Rakeshreddysr2401/-langrobo_perception-/README.md

# rover

**Goal:** give it a pose (x, y, θ) — from the VLM brain, a map click, or a
command — and it gets there precisely, knowing at every moment where it is, and
moving safely through tight spaces because it knows its own shape.

Home and office first, a parking assistant later, an arm to pick things up after
that. Built one tested layer at a time; every claim below is measured.

> **Just powered everything on?** Follow **[STARTUP.md](STARTUP.md)**.

## Start the rover — one command

Power on the D555, Jetson, Pi 5, ESP32 (motor supply too) and the laptop, then
from the Pi 5 (`cd ~/ros2_ws && ./scripts/fleet.sh rover`), or on the Jetson:

```bash
cd ~/rover
./rover up                          # orin-nav:2.0 (Isaac ROS 5.0, ROS 2 Lyrical) since 2026-10-25
                                    # recipe + checks: docker/2.0/ (ISAAC_ROS_5_UPGRADE.md)
```

> **Since 2026-10-25 the whole robot is on ROS 2 Lyrical**: the Jetson (`orin-nav:2.0`, Isaac
> ROS 5.0) and the Pi 5 host (`~/ros2_ws/scripts/ros_env.sh`). The older images 1.1/1.2 are
> deleted; their record is in git history.

It brings up and checks each layer in order: camera (D555 depth) → LiDAR → pose
→ fused pose → slam → nvblox map → nav2 → VLM → follow → track → frame memory → ESP32 wheels → Pi 5 teleop +
brain → LangGraph Studio → Pi 5 voice + Bluetooth speaker → RViz on the laptop
→ ESP32 again. About 8 minutes. A layer that fails stops it and names itself.
`--voice` also (re)checks the Pi 5's voice; it starts at boot on its own anyway.

- It **restarts the container** — for a cold power-on, not a stack that is already up.
  One layer failed? Fix it and continue by hand from that layer (STARTUP.md §2), don't re-run `up`.
- At the end it prints the **Studio** link. It needs two steps: on the laptop
  `ssh -N -L 2024:localhost:2024 rakhi24@192.168.1.16`, then open
  <https://smith.langchain.com/studio/?baseUrl=http://127.0.0.1:2024>.
- Talk to it: "**Kino**, what time is it?" — since 2026-10-12 every sentence reaches
  the brain (no wake word yet); the name makes it certain the sentence is for it.
- **Before anything drives:** `./rover wheels --nudge` (moves ~7 cm) — a live ESP32 link
  does not prove the motor supply is on. Teleop must be in AUTO.
- Stop: `./rover stop` (OPERATIONS.md).

## Where it stands (2026-10-25)

| | what | status |
|---|---|---|
| **Shape** | measured dimensions → URDF + CAD, one source | ✅ [description/](description/README.md) |
| **M1 Calibrate** | camera ↔ LiDAR, camera tilt, lever arm, gyro | ✅ camera within 4 mm of two independent methods; gyro scale 1.001 |
| **M2 LiDAR odometry** | the pose from the walls, every scan | ✅ worst 0.9 cm / 0.39° over 17 runs; ~1 cm vs the owner's tape marks |
| **M3 Fusion** | gyro + LiDAR + VO + wheels, each weighted by its own evidence | ✅ **live**, owns `/odom`: worst 0.8 cm / 0.45° over 19 runs (Phase 1 fusion: 20.5 cm / 13°) |
| **M4 Motion control** | exact x, y, θ moves closed on the pose; firmware fixes | ✅ **live**: four-goal loop closes within 1.4 cm / 0.8° vs LiDAR truth (`./rover goto`) |
| **M5 Safe navigation** | nav2 on the fused pose, LiDAR + depth obstacles, 5 cm margin, collision monitor | nav2 drives on fusion2; nav2 route + goal_exec finish 1.3 cm (`navto --exact`); tight gaps by `./rover pass` (3 cm margin): a 55 cm gap passed at 1.1 cm. Close quarters (2026-10-03): no blind Spin, depth into the map only when not turning, 3 cm map slice; ~50 cm gaps pass, **45 cm cannot be promised** and things under 3 cm are not seen (OPEN_ISSUES.md). 2026-10-04: marks people leave in the camera map are erased by the LiDAR (`ghost_clear`), low things stay; on "no path" `reach` drives back along its own trail and stops repeating a failure |
| **Brain (B1–B3)** | the Pi 5's LangGraph brain drives through `reach` / `goal_exec`, finds things from its own photos (`pixel_to_goal` on the held photo), checks on arrival | ✅ floor-tested 2026-09-26 → 10-02 ([INTELLIGENCE_PLAN.md](INTELLIGENCE_PLAN.md)) |
| **Twin** | the laptop's `kino_sim` simulates the robot's HARDWARE in Isaac Sim and THIS code runs on it unchanged, `TWIN=1 ./rover up`, on ROS domain 42, judged on the true pose -- with the Pi 5 brain too (`fleet.sh twin` on the Pi 5; real-looking `home_real` world) | ✅ Isaac day 2026-10-18: every gate OK; `reach 1.0 -0.6 90` believed vs true 0.4 cm; home_real 4/4 reached through the 80 cm door, over the 1 cm tablet as the robot does ([SYSTEM_OVERVIEW.md](SYSTEM_OVERVIEW.md)) |
| **Isaac ROS 5** | `orin-nav:2.0` (Isaac ROS 5.0, ROS 2 Lyrical) from `docker/2.0/Dockerfile`; 2.1 adds the Part B packages | ✅ 2026-10-25: twin home_real 4/4 in 159 s (4.6: 271 s), 0 touches in the regression suite; **real robot driven**: reach goals 0.6-3.2 cm, nav2 drives the wheels. Three silent nav2 1.5 breaks found and fixed (Twist!). Checks: `docker/2.0/*.sh` ([ISAAC_ROS_5_UPGRADE.md](ISAAC_ROS_5_UPGRADE.md)) |
| **Explore** | the rover maps the home by itself: frontiers of the LiDAR map, every goal through `reach` | twin home_real: whole house in 8.9 min, "no frontier left" (`./rover explore`); **not yet run on the real robot** |
| **Frame memory** | the last 10 min of what it saw, searchable by words: a keyframe per 40 cm / 20° / 30 s still, embedded by EmbeddingGemma 2 on the host GPU; a hit is placed with that frame's own depth (`./rover memory`) | ✅ Jetson half 2026-10-29, robot standing still: search 33-84 ms, "a black backpack" strong and placed from a 103 s old frame (0.53 m ahead), absent things weak; `/odom` 19-20 Hz with it; with the Mac's VLM boxing the hit, the whole find takes ~5-7 s. **Not yet used by the brain, not yet measured while driving** ([FRAME_MEMORY.md](FRAME_MEMORY.md)) |

Numbers and how each was measured: [LOCALIZATION.md](LOCALIZATION.md).
What is still missing, measured: [LOCALIZATION_GAPS.md](LOCALIZATION_GAPS.md).
The roadmap: [SENSOR_FUSION_PLAN.md](SENSOR_FUSION_PLAN.md) §8.
Making the brain use all this (object memory, exact moves, fast detection, learning): [INTELLIGENCE_PLAN.md](INTELLIGENCE_PLAN.md).
**What is open right now, one page:** [OPEN_ISSUES.md](OPEN_ISSUES.md).
**All machines, all repos, how they connect, and how clean each is:** [SYSTEM_OVERVIEW.md](SYSTEM_OVERVIEW.md).

## The repo

| where | what |
|---|---|
| `rover` | the launcher: one layer at a time, each gated on the one below |
| `description/` | **the rover's shape**: `params.yaml` (every measurement, with status and date) → `rover.urdf`, `cad/rover.step`; `description/build` also checks every other copy of those numbers |
| `phase1/nodes/` | the pose: `vo_isaac` (Isaac cuVSLAM; `vo_node` = the old pyCuVSLAM path, self-test only), `gyro_node`, `lidar_odom` (+ node), `fusion2` (+ node), `health`, the calibration tools (`floor_calib`, `cam_lidar_calib`) |
| `phase1/harness/` | **the test harness**: `./rover record <scenario>` drives or records a run, `./rover grade` scores every estimate against LiDAR truth |
| `phase1/firmware/` | ESP32: motors, encoders, telemetry |
| `lidar/` | the RPLidar C1 driver build and its calibration (yaw by driving, timestamp lag) |
| `phase2/` | mapping: nvblox (depth → obstacles 5-27 cm), slam_toolbox, RViz |
| `phase3/` | nav2 (costmaps: nvblox + LiDAR), `./rover drive` exact moves |
| `phase4/` | the VLM bridge: `image_bridge` (photos for the brain), `pixel_to_goal` (pixel → goal; also keeps keyframes' depth), `detections_3d` (opt-in YOLO), `keyframe_memory` + `tools/embedder.sh` (frame memory, [FRAME_MEMORY.md](FRAME_MEMORY.md)) |
| `docker/2.0/` | **the image**: Dockerfile (+ `Dockerfile.features` for 2.1) and its checks: `check.sh`, `vo_check.sh`, `nvblox_check.sh`, `nav2_check.sh`, `topic_audit.sh`, `param_audit.sh`, `tf_lag.sh`, `b2_gridloc.sh`, `b3_cuvgl.sh` |
| `ops/` | `rover_watchdog.py`, `mps.sh` (CUDA MPS, B1) |
| `docs/archive/` | history: the phase logs, the old TODO and READINESS, the knowledge notes |

The Pi 5 brain (LangGraph, voice, teleop) is a separate repo: `~/ros2_ws` on the Pi.

## Everyday commands

```bash
./rover up                         # everything, cold (see STARTUP.md for the layers)
./rover health                     # every layer's rate in one ~15 s pass
./rover status                     # the same rates + processes, and whether the pose is honest

./rover record return              # move it by hand, put it back on the tape: all ~0
./rover grade                      # the newest run vs LiDAR truth

./rover camera --floor             # camera tilt and height off the floor (moves nothing)
./rover camera --lidar [--solve]   # camera vs LiDAR, pose by pose (moves nothing)
./rover lidar --calibrate          # LiDAR mount yaw, by driving
description/build                  # after any measurement change: URDF, CAD, drift check

./rover goto X Y [DEG]             # an exact move, relative (DRIVES); --map / --odom for frames
./rover navto X Y DEG [--exact]    # nav2 plans the route; --exact: goal_exec finishes to ~1 cm (DRIVES)
./rover pass [D] [--dry]           # find the tight gap ahead, crawl straight through, 3 cm margin (DRIVES)
./rover explore [minutes]          # map the home by itself, frontier by frontier, via reach (DRIVES; a person watches)

./rover memory                     # frame memory: last 10 min searchable by words (FRAME_MEMORY.md; part of up)
phase4/tools/embedder.sh status    # its model server on the host GPU (start | stop | status)

docker/2.0/topic_audit.sh          # topics whose publishers and subscribers disagree on the type (stack up)
docker/2.0/param_audit.sh          # nav2.yaml keys the running nav2 silently ignores (stack up)
ops/mps.sh start; MPS=1 ./rover up # GPU shared through CUDA MPS (off by default: no gain measured yet)
```

[OPERATIONS.md](OPERATIONS.md) has the rest and the troubleshooting;
[ARCHITECTURE.md](ARCHITECTURE.md) the topics, frames and nodes.
