Rakeshreddysr2401/-langrobo_perception-/description/README.md

# description/ — the rover's geometry: CAD and URDF from one file

```
params.yaml   every measurement, raw, with status + source + date   ← edit this
build         regenerate everything below and check the repo for drift
build.py      the derivation (params -> frames), URDF writer, CAD, drift check
rover.urdf    GENERATED: frames + boxes/cylinders, no <inertial> yet
cad/          GENERATED: rover.step (open in FreeCAD / Onshape) + one .stl per part
```

## Workflow — "as we go"

1. Measure something (see ROVER_BUILD_PLAN.md §1).
2. Put it in `params.yaml` the way it was measured (from the nose, from the
   floor...). Unknown stays `value: null`. **No guesses, no placeholder masses.**
3. `description/build`: rewrites `rover.urdf` and `cad/`, prints the derived frames,
   and checks the hand copies of these numbers that remain (nav2 footprint,
   `vo_node`'s fallback, firmware, odometry constants, pivot safety corners). Exit 1 = a copy
   disagrees; the output says what it should be.
4. Fix the copies it names, rerun until `drift: N/N`, commit.

A new part (battery, Jetson, Pi 5, motors, drivers...) goes under `components:`
as a box with `size` and `centre` in base_link. It shows up in the URDF and the
CAD on the next build. `mass` stays null until it is weighed.

The CAD needs build123d; `build` makes `~/.venvs/cad` on its first run.

## Frames

base_link: **on the floor, midway between the four wheel contact patches** —
x forward, y left, z up. The nose is at +0.182 (axles 6.3 / 30.1 cm behind it).

| frame | x | y | z | note |
|---|---|---|---|---|
| wheels | ±0.119 | ±0.170 | 0.041 | fixed joints until /joint_states exists |
| camera0_link | 0.173 | −0.0475 | 0.175 | the D555's LEFT IR imager, at the front glass; the driver publishes everything below it |
| laser | 0.1342 | 0 | 0.2498 | yaw 1.5463 rad, calibrated by driving |

Two things that look like mistakes and are not:

- **camera y is −4.75 cm** although the camera is centred: `camera0_link` is the
  left imager, half the 95 mm baseline from the case centre. The driver's own
  TF puts infra2 at +0.095 from it, which fixes the sign.
- **The odometry wheel diameter (85 mm) differs from the tyre (83 mm).** It stays
  until a taped 1 m drive says which one gives true distances.
  Likewise `effective_track` (0.5216) is a turning calibration, not the 0.34 track.

## Live

`./rover pose` and `./rover lidar` both call `tf_up`, which runs
`build.py --rsp` and starts ONE `robot_state_publisher` with the URDF derived
from `params.yaml` at that moment. So a new measurement reaches the live TF on
the next layer start, with no copy to update. `LIDAR_YAW=<rad> ./rover lidar`
still overrides the yaw for one run.

RViz (`phase2/rviz/rover_live.rviz`) draws the URDF from `/robot_description`.

`vo_node` reads its camera offset from TF (`base_link -> camera0_link`) at
start; its constants are only the fallback, and it logs an ERROR if it uses them.

Still copied by hand, and held to params.yaml by the drift check: nav2's
footprint, `vo_node`'s fallback, the firmware and the Phase 1 odometry constants
(`WHEEL_BASE_M`, `WHEEL_BASE_ROT_M`, `METRES_PER_COUNT`), and the pivot
scripts' corners.

## Placeholders

`mass.total` is **assumed 3.5 kg (3–4)**, on the owner's word until it is weighed.
Every build prints it. Nothing uses it for geometry and the URDF has no
`<inertial>` yet.
