Rakeshreddysr2401/-langrobo_perception-/STARTUP.md

# Power-on → working development environment

**The one document to follow after everything has been switched off.**

You powered down the D555, the Jetson, the Pi 5 and the ESP32. You have powered
them back on. This is what to run, in what order, what "good" looks like at each
step, and what to do physically when a step fails.

For *why* any of it is shaped this way see [ARCHITECTURE.md](ARCHITECTURE.md).
For the full runbook including calibration and troubleshooting see
[OPERATIONS.md](OPERATIONS.md).

---

## 0. The five boxes

| box | address | how you know it is alive |
|---|---|---|
| Jetson Orin Nano | 192.168.1.15 | you are on it; `docker ps` shows `rover` |
| D555 depth camera | 192.168.11.55 | **only** a live publisher on `infra1`. Ping proves nothing |
| ESP32 wheel link | via micro-ROS | `/wheel_state` at ~20 Hz |
| Pi 5 (teleop + brain) | 192.168.1.16 | `:8091/mode` answers, `agent_node` running |
| Mac mini (LLM/VLM) | **DHCP — moves** (was .6, came back as .10 on 2026-09-23) | from the Pi 5: `curl http://singireddys-mac-mini.local:8080/health`. The brain calls it by name, so a moved IP does not affect it — only a check by IP looks like a dead server |
| RPLidar C1 | USB on the Jetson, `/dev/ttyUSB0` (CP210x) | `/scan` at ~10 Hz and `base_link -> laser` resolving — `./rover lidar` checks both |
| Laptop (RViz) | **DHCP — moves** | `./rover view` finds it |

**Single command:** `./rover up` runs every step below in order — camera,
lidar, pose (with `SLAM=false`), fused, slam, map, nav, vlm, follow, track and memory (these three
not fatal), the ESP32 check,
the Pi 5 check, Studio, and the laptop view — and prints the Studio tunnel link
and the LangSmith project at the end. Add `--voice` to also check the Pi 5's
voice. It restarts the container, so it's for a cold power-on — don't run
it against a stack that's already up and healthy, it throws the running state
away for nothing. The layer-by-layer steps below are what it runs, and what to
fall back to when one of them fails and you need to see which.

**From the Pi 5 instead:** `~/ros2_ws/scripts/fleet.sh rover` runs this same
`./rover up` — but only when the stack is not already up (it asks over ROS), so
it is safe to run any time. `fleet.sh check` then proves every link with data.

**Voice:** it lives on the Pi 5 as the `langrobo-voice` systemd user unit
(starts at boot). `./rover voice` starts it if it is not running — never a
second copy — and prints the providers, the wake setting, and which speaker +
mic the Pi 5's audio owner picked. Since 2026-10-10 the **mic is the USB AM-C28
array** and the **boAt Stone is the speaker** (Bluetooth A2DP). Speech-to-text is
Sarvam (Telugu or English → English); if Sarvam fails, Parakeet transcribes English
on the Pi 5. Say "Kino" in the sentence to be sure it becomes a turn; other
sentences are judged by the brain. Details: the Pi 5 repo
`docs/voice/VOICE_LAB_2026-10.md`.

**If it seems deaf:** the mic is plugged into the Pi 5, not here — check
`/voice/debug_vad` and `/voice/debug_transcript`. (The old trap — the Stone's
Bluetooth mic too quiet for a 0.05 loudness gate — is gone: that gate is off and
the Stone no longer listens.) To check a suspicion:

```bash
docker exec rover bash -lc 'unset ROS_DISCOVERY_SERVER FASTRTPS_DEFAULT_PROFILES_FILE; \
  export ROS_DOMAIN_ID=0; source /opt/ros/lyrical/setup.bash; \
  ros2 topic echo /voice/debug_vad --field data'
```

**The Jetson can come back under another name.** After a power cycle its
avahi (mDNS) may find `rakhi-jetson.local` still claimed on the network and
rename itself `rakhi-jetson-2.local`, `-3`, … (seen 2026-09-28). The Jetson is
fine, but everything that calls it by name — `fleet.sh`, the Pi 5's ssh — sees
`jetson: unreachable`. Find it by address (192.168.1.15) and give it its name
back:

```bash
ssh rakhi24@192.168.1.15 'sudo systemctl restart avahi-daemon'
getent hosts rakhi-jetson.local          # from the Pi 5: 192.168.1.15 again
```

Two more traps worth knowing before you start:

- **The D555 answers ping while completely dead.** It is a PoE network device
  speaking DDS, not a USB camera. Never diagnose it with `lsusb` or `ping`.
- **`./rover status` on a cold container prints a table of dashes** — nothing is
  publishing yet. It measures every topic in one ~12 s pass (since 2026-10-18;
  it used to take 2+ min). Start a layer first; the layer gates name what failed.

---

## 1. Jetson — start the container

```bash
cd ~/rover
docker ps -a --format '{{.Names}}\t{{.Status}}'   # is `rover` there, and stopped?
docker start rover
```

After a power cycle the container is stopped, not gone. `docker start` is
enough; `./rover camera` will create one if it is genuinely missing.

---

## 2. The stack, one layer at a time

Run these **in order**. Each layer checks the one beneath it, so a failure names
its own layer instead of hiding in a wall of log. **Do not skip ahead when one
fails.**

```bash
./rover camera      # the D555 alone       — IR >=15 Hz, depth >=10 Hz
./rover lidar       # the RPLidar C1       — /scan >=8 Hz AND base_link -> laser exists
SLAM=false ./rover pose   # + cuVSLAM, gyro — VO >=10 Hz, gyro >=50 Hz
./rover fused       # + fusion -> /odom    — /odom >=15 Hz, AND the honesty check
./rover slam        # + slam_toolbox       — /map >=0.3 Hz, map -> odom
./rover map         # + nvblox, ghost_clear — occupancy grid >=1 Hz, cleaned grid >=1 Hz
./rover nav         # + nav2               — both costmaps
./rover vlm         # + VLM pixel -> goal  — colour >=2 Hz, 1 listener
./rover detect      # + YOLO -> odom objects — publishing, target hunt listening
./rover follow      # + "follow me" (starts detect too) — follow listening, people publisher
./rover track       # + the locked-target tracker  — track listening
./rover memory      # + frame memory (model on the host GPU) — embedder reachable, >=1 keyframe, /odom still >=15 Hz
./rover view        # RViz on the laptop
```

**One layer failed in `./rover up`? Continue by hand — do not re-run `up`.**
`up` restarts the container, which restarts the camera you may just have got
working. Fix the failed layer, run it alone, then the rest in the order above
(with `SLAM=false` on pose), then `./rover view` for RViz. From the Pi 5,
`fleet.sh check` then proves the whole chain.

**The nav layer's compiled plugin.** `./rover nav` loads the rover's own
costmap plugin (`footprint_clear`, NAV_PLAN.md) from
`phase3/plugins/ws/install`. That is built once, inside the image, by
`phase3/plugins/build.sh` (~20 s), and again only after its source changes;
nav2_supervise.sh warns in `./rover logs nav` if it is missing. After a nav
restart check two things: `./rover logs nav` has `Initialized plugin
"footprint_clear"`, and `./rover logs reach` has `pose OK`.

**`SLAM=false` on pose, and only one owner of `map -> odom`.** cuVSLAM
publishes `map -> odom` whenever its loop closure is on, which is `./rover
pose`'s default. slam_toolbox is the owner now — it corrects against the walls
on every scan — so pose must run with `SLAM=false`, and `./rover slam` refuses
to start if cuVSLAM already owns the frame. `./rover up` does this for you.

**Order matters less than it did, but the LiDAR still needs a live frame.**
Until 2026-09-22, `./rover pose` killed every static transform in the
container, including the LiDAR's, so a LiDAR started before it vanished
silently. That is fixed; `./rover lidar` now fails its gate if
`base_link -> laser` does not resolve.

**If you carry the rover by hand after bring-up**, cuVSLAM can diverge and slam
will apply a large correction trying to make sense of it. Put it down and run
`SLAM=false ./rover pose`, `./rover fused`, `./rover slam` — the pose and the
map restart at the new spot, which becomes the new origin.

**`detect` depends on which brain the Pi 5 is running.** It feeds
`approach_object`, `where_is`, `list_known_objects` and the `world_model`
service — five tools that otherwise answer "I haven't seen one before" about an
object in plain view. It is distinct from `vlm`: `vlm` answers a VLM's
*described* object at ~10-40 s a look, `detect` publishes everything it
recognises continuously at roughly zero query cost.

Those tools exist on `pi5_ros2_ws`'s **`dev-1.2.8-refactor-test`**. They were
deliberately removed on the **`minimal`** line — `dev-1.3.0-minimal` and
`dev-1.3.1-minimal` both — along with `world_model` and the `on_detections`
handler; that cut keeps vision on `look` + the VLM approach path. On a minimal
brain `/vision/detections_3d` has no subscriber, and running `detect` costs GPU
for nobody. See [docs/archive/TODO.md](docs/archive/TODO.md) §32.

**Check the brain before adding `detect` to the order, and check it by what it
subscribes to, not by the branch name.** `dev-1.3.1-minimal` still *mentions*
`/vision/detections_3d` in `ros2_bridge.py` and `tools/approach.py`, but both
are only comments describing the contract — the handler is gone. Verified
2026-09-09: the bridge's three real subscriptions are `/vision/pixel_result`,
`/voice/tts_speaking` and the compressed colour image, and
`langrobo_core/tools/` has no `world_model`. The grep that answers it:

```bash
ssh 192.168.1.16 'grep -n create_subscription \
  ~/ros2_ws/src/langrobo_ros/langrobo_ros/ros2_bridge.py'
```

If `/vision/detections_3d` is not in that output, skip `detect`. (Since 2026-10-20
it costs ~1 % CPU while nothing subscribes: it sleeps -- no camera, no TF, no YOLO --
and wakes for follow or a target hunt; NAV_PLAN.md "2026-10-20".)

**`follow` is part of `up` since 2026-10-11** ("Kino, follow me" / "come to me";
the Pi 5 brain has the tool on with `LANGROBO_FOLLOW=1`). It starts `detect` (YOLO
+ the person tracker -> `/vision/people`) and `follow_node`. If it fails, `up` warns
and carries on: the robot works without it. YOLO idles until someone asks for people,
so it costs nothing at rest; while active, measured 2026-10-11: `/odom` 20 Hz, colour
4.5 Hz, the cleaned grid 5 Hz, `/scan` 10 Hz (unchanged), GPU ~10 %. `follow_node`
drives only after `/follow/start`. `FOLLOW_DRY=1 ./rover follow` = commands on
`/follow/cmd_vel_dry`, wheels untouched. Nobody in view at the start: it turns
in place to find someone (2026-10-13; not with something within ~0.29 m of its
centre). Lost mid-follow: it turns after them, drives to where they were last
seen and looks all around (40 s cap), re-acquiring by clothes colours
(`phase4/nodes/person_look.py`). The camera sits low: a person must be
standing to be seen. Someone seated at the frame edge (legs and arms only) gives no
YOLO person even at conf 0.1.

**`memory` is part of `up` since 2026-10-29** ([FRAME_MEMORY.md](FRAME_MEMORY.md)): the last
10 minutes of what the robot saw, searchable by words. Two parts: EmbeddingGemma 2 in
llama.cpp on the **host** GPU (`phase4/tools/embedder.sh`, port 8097; the image is not
touched) and `keyframe_memory.py` in the container. Good looks like: `embedder
reachable True`, `keyframes kept >= 1`, `embed per keyframe` ~1.6-1.9 s, `reference
level: 38 photos` (the first start builds it in ~70 s and caches it in
`logs/embed_reference.npz`), and `/odom` still >= 15 Hz (measured 19-20 Hz). If it
fails, `up` warns and carries on. The model server refuses to start with too little
free RAM and stops itself (never anything else) if available RAM drops under 600 MB,
or when the container is gone; keyframes then pause and the status says
`"embedder": false`. Model files: `models/embed/` (gitignored; recovery commands in
`embedder.sh`'s header).

**Do not stop at `nav`.** `vlm` is what lets the Pi 5 brain *see* — without it
`look()` and `approach_described_object()` are silently dead, the brain answers
questions but is blind, and `./rover status` shows the `vlm` row as `--`.

`vlm` costs you depth rate: ~24 Hz → ~14 Hz once `image_bridge` attaches, worst
case a 633 ms gap (measured 2026-09-09). Still over the 10 Hz gate. This is
consumer load, **not** `align_depth` — an earlier note blaming the driver's
reprojection was wrong.

**But the 10 Hz gate is not the constraint that matters here.** Later the same
day, under all six layers, the same stall was measured at **1.4–1.9 s** — past
cuVSLAM's `max_frame_delta_s` of 1.0 s, which resets tracking. `vo_node` logs
`frame gap` and the fusion node logs `vo DOWN`, both recovering in ~1 s, so no
rate gate ever sees it. See [docs/archive/TODO.md](docs/archive/TODO.md) §31.

### When a layer fails

| layer | what it means | what to do — physically |
|---|---|---|
| `camera` | the D555's on-camera DDS server is dead | **unplug its PoE cable ~5 s and replug.** No software restart recovers this |
| `camera`, right after a replug | the D555 is still booting — it takes **~60 s** after power, and `./rover up` waits only 40 s | wait a minute, then `./rover camera` alone (2026-09-28: failed in `up`, passed at 30 Hz a minute later) |
| `slam` | `✗ cuVSLAM is already publishing map -> odom` | pose was started without `SLAM=false`. `SLAM=false ./rover pose`, `./rover fused`, `./rover slam` |
| `nav` | the gate shows both costmaps at **0.0 Hz** and nav.log stops after `Configured MPPI Controller` | nav2's lifecycle manager lost a service reply under load (2026-09-28). Run `./rover nav` again |
| `nav` (reach) | `./rover logs reach` shows `NO POSE` | reach started without ever receiving `/odom` and would drop every goal (it did once, 2026-09-27). `./rover nav` again, then look for `pose OK` |
| `pose` | camera is up but cuVSLAM is not tracking | needs texture. Do not start it facing a bare wall with the emitter off |
| `fused` | prints `✗ DIVERGED` | `./rover pose` **then** `./rover fused`. `fused` alone restarts fusion and NOT cuvslam, so the divergence survives |
| `map` | refuses to start | that is deliberate — the pose is dishonest. Fix the pose first, see above |
| `nav` | costmaps flat | the map has no obstacle data yet. Drive it a little |

---

## 3. The cuVSLAM honesty check — now automatic

cuVSLAM has diverged four times and **the fallback is silent**: the rover drops
to gyro-plus-wheel dead reckoning while `/odom` stays at 20 Hz, `ready: true`,
every rate gate green and nav2 planning and driving. One session ran 21 m that
way before anyone noticed.

**You no longer have to remember to check this.** As of 2026-09-09:

- `./rover fused` runs the check in its gate and prints a `cuvslam` line.
- `./rover map` **refuses** to build on a diverged pose — mapping while diverged
  corrupts the map permanently rather than degrading it.
- `./rover status` prints the pose / cuvslam / wheels rows from fusion2's health.

### It catches two different failures, and says which

Earlier on 2026-09-09 it caught only one. It printed `ok — tracking, not dead
reckoning` with no cuVSLAM node running at all, and `./rover map` built on that
pose without refusing — because the four fields it read (`vo_z`,
`vo_implausible`, `dr_metres`, `landmarks`) are last-known values that **freeze**
rather than disappear when `vo_node` stops. At a standstill a dead tracker read
identically to a healthy one. Fixed the same day (TODO 30); it now also reads
`vo_alive`, and both failures print distinctly:

```
✗ DIVERGED      cuVSLAM is publishing a confidently wrong pose
✗ NOT RUNNING   cuVSLAM is publishing nothing; the numbers above are frozen
```

**Both are fixed the same way** — `./rover pose` **then** `./rover fused` — and
both now make `./rover map` refuse rather than smear the map.

You may also see this, which is *not* a failure and does not block a gate:

```
! vo dropped out in 1 of 4 samples — frame gaps past max_frame_delta_s (1.0 s)
```

That is the load-related stall in [docs/archive/TODO.md](docs/archive/TODO.md) §31 — tracking recovers in
~1 s. Worth watching before a long autonomous run, not worth stopping for.

What you want to see:

```
cuvslam   vo_z +0.007 m   implausible 0   dead-reckoned 0.00 m   landmarks 132
          ok — tracking, not dead reckoning
```

Do **not** check this with `ros2 topic echo /fusion/status --once` — it truncates
the JSON mid-field, so anything grepping it silently reads nothing.

---

## 4. ESP32 — the wheel link

```bash
docker exec rover bash -lc 'unset ROS_DISCOVERY_SERVER FASTRTPS_DEFAULT_PROFILES_FILE; \
  export ROS_DOMAIN_ID=0; source /opt/ros/lyrical/setup.bash; \
  ros2 topic hz /wheel_state; ros2 topic info /cmd_vel'
```

Want **~20 Hz** and `/cmd_vel` **Subscription count: 2** — the ESP32 (it shows
as `_CREATED_BY_BARE_DDS_APP_` in `ros2 topic info -v`, via the micro-ROS agent)
and `fusion2`, which reads the commands. `./rover wheels` checks the ESP32 one by
name, and `./rover up` runs it twice: after `vlm` and again at the very end.

**20 Hz does not mean the motors have power.** On 2026-09-23 every gate passed
— 20 Hz, subs 1, "Wheels are live" — and the wheels could not turn: the
ESP32's logic was powered and the motor supply was not. The rate proves the
board is talking. Before anything drives:

```bash
./rover wheels --nudge      # MOVES ~7 cm: command arrived? did both sides drive?
```

It names which of three things is wrong: the command never arrived, it arrived
and nothing moved (motor power — a switch or the BTS7960 supply), or only one
side moved (that side's driver or wiring).

If it is 0 Hz or subs 0, the ESP32 did not reconnect its micro-ROS session —
**power-cycle the rover** (the board, not the Jetson). Old firmware does not
retry the agent connection. It usually comes back on its own after a power
cycle; it did on 2026-09-09 with no intervention.

### It can also link, rot, and then come back — do not power-cycle on sight

On 2026-09-09 the link came up healthy after the power cycle — `/cmd_vel` subs
**1**, `/wheel_state` publishing — then **decayed and died while the stack was
still being brought up**: 15.9 → 14.8 → 11.3 Hz across three consecutive
`ros2 topic hz` windows, max gap 0.732 s, and minutes later publishers **0**,
subs **0**. Nothing was driven at any point. Roughly ten minutes later it was
back at a steady **20.0 Hz**, subs **1**, with **no power-cycle and no
intervention**.

**So this is not the firmware-retry fault above, and the fix above is the wrong
reflex.** That fault leaves a dead link dead until the board is power-cycled;
this one restored its own micro-ROS session. Power-cycling on sight of it
"fixes" something already recovering and destroys the evidence.

What to do instead: a green wheel check at §4 is a reading, not a guarantee —
**re-check after the last layer is up, and again before anything drives.** The
symptom of missing the window is the worst one available: nav2 plans a route and
publishes `/cmd_vel` into a topic with no subscriber, so the rover never moves
while every gate on the Jetson stays green. That looks like a controller fault
or like teleop in MANUAL, and it is neither.

Cause is not established — one observation. `/cmd_vel` publishers climbed 2 → 6
over the same period as nav2, the brain and `/studio_bridge` attached, so DDS
load is the first thing to test, not the answer. See [docs/archive/TODO.md](docs/archive/TODO.md) §33.

---

## 5. Pi 5 — teleop and the brain

These start themselves at boot. **Check, do not start.**

```bash
ssh 192.168.1.16 'pgrep -af "teleop_we[b]|agent_[n]ode|brain_launc[h]"'
curl -s http://192.168.1.16:8091/mode          # want {"manual": false}
```

| check | want | if not |
|---|---|---|
| `teleop_web.py` running | 1 process | `ssh 192.168.1.16 'pkill -f teleop_web.py'` — `Restart=always` brings it back |
| `agent_node` running | 1–2 processes | it is launched by `brain_launch.py`; see OPERATIONS.md §7 |
| `:8091/mode` | `{"manual": false}` | **AUTO.** In MANUAL it streams zeros at 10 Hz that cancel nav2's commands |

The brackets in that `pgrep` are deliberate: without them the pattern matches
the command line of the shell running it, and every check reports one extra
"process" that is just itself. The same trap kills your ssh session outright
when the command is `pkill` — see §6.

**Teleop must be in AUTO before any autonomous motion.** In MANUAL the rover
crawls, stalls, and it looks exactly like a controller fault.

### The four services, and the one that needs you

All of it is systemd on the Pi 5, which §5 never actually named:

| unit | what it is |
|---|---|
| `langrobo-brain` | the LangGraph `agent_node` |
| `langrobo-teleop` | the `:8091` hold-to-move web page |
| `langrobo-microros` | the **ESP32 <-> Pi 5 bridge**, over the ESP32's USB cable since 2026-10-07 (`/dev/ttyUSB0`; was WiFi UDP 8888) — see §4 and TODO §33 |
| `langrobo-discovery` | Fast DDS Discovery Server, the Pi 5 <-> Jetson meeting point |

After changing anything under `~/ros2_ws/src/langrobo_core`, the brain must be
restarted to see it — `langrobo_core` is imported straight from `src/`, so there
is **no colcon build step** for it, but the running process holds the old code.

```bash
ssh 192.168.1.16 'sudo systemctl restart langrobo-brain'
```

**That needs a password** — `sudo -n` fails, so it cannot be scripted or run by
an agent on your behalf. Type it yourself. Confirm it actually took, because a
piped `sudo` failure is easy to miss:

```bash
ssh 192.168.1.16 'systemctl show -p ExecMainStartTimestamp langrobo-brain'
```

A PID that did not change means the restart did not happen.

---

## 6. LangGraph Studio — the link you asked for

`./rover up` starts it on the Pi 5 every time (its `[studio]` step); it is
not needed for the robot to work — `agent_node` runs the graph in-process —
it is a **dev server** that draws the graph and lets you step it.

The launcher is the Pi 5 repo's `~/ros2_ws/scripts/start_studio.sh` (one
Studio only: a second start sees :2024 answering and exits). It runs beside
the live brain: no micro-ROS agent, plain multicast DDS like everything else.
The Pi 5's `./scripts/dev.sh` is the variant for when the brain is **stopped**
(it also starts a micro-ROS agent). Never run Studio's graph and the brain's
both driving: both publish `/cmd_vel`, and only `agent_node` hears the
nav-done callback.

### Start it on the Pi 5

```bash
ssh 192.168.1.16 'setsid nohup ~/ros2_ws/scripts/start_studio.sh \
    > /tmp/langgraph_dev.log 2>&1 < /dev/null &'
```

It takes 30–60 s. Poll rather than assume:

```bash
ssh 192.168.1.16 'curl -s http://127.0.0.1:2024/ok'      # {"ok":true} when ready
```

### Open it — TWO steps, both required

**Step 1** — on the machine with the browser, leave this running:

```bash
ssh -N -L 2024:localhost:2024 rakhi24@192.168.1.16
```

**Step 2** — open:

```
https://smith.langchain.com/studio/?baseUrl=http://127.0.0.1:2024
```

**The link alone will not work.** Studio's page is served over HTTPS and a
browser blocks it from calling `http://192.168.1.16:2024` as mixed content, with
no visible error. `http://127.0.0.1` is the one address browsers exempt, and the
tunnel is what makes it `127.0.0.1` on your laptop.

Check the tunnel from your laptop: `curl localhost:2024/ok` → `{"ok":true}`.

**A blank page when `/ok` is healthy is the CORS private-network bug**, not a
dead server — and `curl` cannot see it, because curl sends no `Origin`. A local
patch on the Pi 5 fixes it and `pip` silently undoes it; the diagnostic curl and
the one-line fix are in [OPERATIONS.md](OPERATIONS.md) §7, tracked as
[docs/archive/TODO.md](docs/archive/TODO.md) §38. A stale tab looks the same, so hard-reload first.

### When there is no laptop

The tunnel is not a laptop thing — it must simply run **on whichever machine has
the browser**, because `127.0.0.1` is the only address a browser will let an
HTTPS page call over plain HTTP. Pick the box you will actually be looking at:

**On the Jetson** (it has `firefox`, and this is the usual fallback):

```bash
setsid nohup ssh -N -o ExitOnForwardFailure=yes -o ServerAliveInterval=30 \
    -L 2024:localhost:2024 rakhi24@192.168.1.16 \
    > /tmp/studio_tunnel.log 2>&1 < /dev/null &
curl -s http://127.0.0.1:2024/ok        # {"ok":true} — verified 2026-09-09
```

Then open the §6 Step 2 link in a browser **on the Jetson**. `ExitOnForwardFailure`
is what makes a failed forward fail loudly instead of leaving a live ssh session
with a dead tunnel; the keepalive stops the flaky Pi 5 link (TODO §29) from
silently dropping it mid-session.

Note the Jetson's `DISPLAY` is empty over ssh — you need its physical monitor,
or `ssh -X`. If neither is available, **that closes the Studio path** and
LangSmith below is the answer, not a workaround.

**A phone cannot do this.** No ssh tunnel, so no `127.0.0.1`, so Studio will not
load — the teleop page on `:8091` is the only phone-facing thing here.

### If you only want to read what the brain did, skip all of it

LangSmith needs no tunnel, no server and no browser on any particular machine —
[smith.langchain.com](https://smith.langchain.com), project **`pi5`**. Drive a
real turn through Telegram and read the trace. For *reading* flows this is the
lower-effort path and always has been; Studio is only worth the tunnel when you
want to **step the graph yourself**.

### Stop it before you use Telegram — it answers your messages instead

**Studio is not a passive viewer.** Its process runs the same graph and brings
up its own `/studio_bridge` ROS node beside `/agent_node`; both can publish
`/cmd_vel`. It takes no voice or Telegram input (only `agent_node` listens to
those), so it cannot steal a request -- but a drive started from Studio and one
started by voice/Telegram would fight over the wheels.

**Since 2026-10-04 a drive started in Studio reports back to Studio.** Before
that, only `agent_node` registered a nav-done callback, so Studio's bridge logged
`nav done ... listener=NONE` and threw the report away (measured 2026-09-10, and
again 2026-10-04: the robot said it was "1.5 m from the door" after arriving).
Now `graph_studio.py` posts the same report (`movement.nav_report`) as a new turn
on the thread whose tool started the drive -- arrival, failure with its reason,
and any "on arrival" errand. Pi 5 commit `a362e8a`.

So still treat §6 as a mode for DRIVING: **Studio, or the Telegram/voice brain --
not both at once.** `./rover up` starts Studio at the end because the link is
usually what is wanted; if you are about to drive from Telegram, stop it first.
Voice can stay up beside Studio.

### Stopping it

```bash
ssh 192.168.1.16 'pkill -f "langgrap[h] dev"'
```

Confirm `/studio_bridge` is actually gone before trusting a nav report again:

```bash
ros2 node list | grep studio      # want no output
```

**The brackets are not a typo.** `pkill -f "langgraph dev"` matches its own
command line over ssh and kills its own session: exit 255, no output, nothing
killed — indistinguishable from a flaky link.

### LangSmith is a different thing, and needs none of this

[smith.langchain.com](https://smith.langchain.com), project **`pi5`**. Traces of
real turns the rover has already taken through Telegram. No tunnel, no server,
nothing to start — tracing is on (`LANGCHAIN_TRACING_V2=true`).

For *reading* how agents hand off and which tools fire, LangSmith is the lower
effort path. Studio is for driving the graph yourself.

---

## 7. What "all good" looks like

`./rover status` — all eleven rows, plus an honest pose:

```
  camera  /camera/camera0/infra1/image_rect_raw   28.6   want 15   OK
  camera  /camera/camera0/depth/image_rect_raw    15.4   want 10   OK
  pose    /vo/odom                                21.5   want 10   OK
  pose    /gyro/base                             199.2   want 50   OK
  wheels  /wheel_state                            19.9   want 15   OK
  fused   /odom                                   20.0   want 15   OK
  map     /ghost_clear/grid                        4.8   want  1   OK
  nav     /global_costmap/costmap                  0.8   want0.5   OK
  nav     /local_costmap/costmap                   1.7   want  1   OK
  vlm     /camera/color/image_raw/compressed       4.5   want  2   OK
  view    /rover/model                             1.0   want0.5   OK

  cuvslam  vo_z +0.007 m  implausible 0  dead-reckoned 0.00 m  landmarks 132
           ok — tracking, not dead reckoning
```

Plus, off the Jetson:

- `/wheel_state` ~20 Hz, `/cmd_vel` subs 1 — ESP32 linked
- `:8091/mode` → `{"manual": false}` — teleop in AUTO
- `agent_node` running on the Pi 5 — brain up
- `:2024/ok` → `{"ok":true}` — Studio up, if you started it
- `ros2 node list` shows `/agent_node` and `/studio_bridge`

---

## 8. What this does NOT restore

Following this document gets you a **working rig**, not the *identical* state you
left. The difference is deliberate in some places and a known gap in others.

**Comes back exactly:**

- every layer and its rates, the honesty of the pose, the ESP32 link
- the Pi 5 brain and teleop — they start at boot
- Studio's own episodic store (`~/.langrobo/qdrant_studio` persists on disk)
- the Pi 5's `.env`, including `STUDIO_MODEL=default`

**Does NOT come back, by design:**

- **The map.** nvblox builds in the `odom` frame and is discarded on shutdown —
  phase 2c ("a map that survives a power cycle") is deferred by choice. You
  start with an empty grid and it grows as you drive.
- **The odom origin.** It resets to wherever the rover is when `./rover fused`
  starts. Saved locations (`kitchen`, `entrance`, …) are coordinates in that
  frame, so **they only mean anything relative to this session's start pose.**
  If you moved the rover while it was off, they point somewhere else.

**Backed up, but not in this repo:**

- **`~/ros2_ws` on the Pi 5 is its own git repo** —
  `github.com/Rakeshreddysr2401/pi5_ros2_ws`. The branch actually checked out
  moves: it was `dev-1.2.8-refactor-test`, and on 2026-09-09 it was
  `dev-1.3.1-minimal`. Read it, do not assume it —
  `ssh 192.168.1.16 'cd ~/ros2_ws && git rev-parse --abbrev-ref HEAD'`.
  The whole `langrobo_core` / `langrobo_ros` brain tree is version-controlled
  there, so a reflash is a `git clone`, not a loss. (An earlier draft of this
  section claimed it was unbacked-up. It was wrong.)
- **`.env` is the exception, and correctly so** — it is gitignored on the Pi 5
  because it holds the LangSmith / Sarvam / Soniox / OpenAI keys. `example.env`
  is tracked as the template. **This is the one thing with no backup anywhere**:
  if that SD card dies you re-issue keys. Worth a copy somewhere safe.

**Varies between power cycles:**

- **Whether the ESP32 reconnects on its own.** It did on 2026-09-09 with no
  intervention; other sessions have needed a physical power-cycle. §4 tells you
  which you got.
- **The laptop's IP** — DHCP. `./rover view` finds it.
- **Studio is not started at boot** — §6 every time.

---

## 9. Before anything drives

- **A human watches, every time.** The rover cannot see anything flatter than
  5 cm, anything low beside or behind it that the camera never faced (the
  LiDAR sees all round, but only at 25 cm), or **downward**: there is no
  drop-off detection at all.
- **Tapping MANUAL on the phone cancels the active nav2 goal.** That is the stop.
- **Studio can drive.** With ROS sourced, a `navigate` turn typed into the
  browser publishes real `/cmd_vel` — `/studio_bridge` sits alongside
  `/agent_node` and both can command the wheels. To explore the graph *without*
  that, start Studio in a shell where ROS is not sourced: it falls back to
  `StubBridge` and logs tool calls instead of publishing.
- **Teleop must be in AUTO for `./rover drive`, `pivot` and `lidar --calibrate`.**
  In MANUAL it streams zeros over every command. `./rover drive` checks and
  refuses; driving the rover to a new spot with the phone leaves it in MANUAL.
- **`./rover wheels --nudge` first** after any power cycle (§4): a healthy link
  rate says nothing about motor power.
- **Pause YOLO, follow and track while driving** until the overload is fixed (OPEN_ISSUES R8):
  with all of them up on the real robot (2026-10-25) `/odom` fell to 14.7 Hz and the gyro to 104 Hz;
  without them `/odom` held 19.8 Hz. `./rover detect` / `follow` / `track` bring them back.
- **If the D555 does not come up after a power cycle**, look at the Jetson's Ethernet first:
  `cat /sys/class/net/enP8p1s0/carrier` -- `0` is a cable / PoE problem (re-seat the plug at
  both ends, check the injector's light), not the camera's software (2026-10-25).
- **Turns slide.** A plain turn "in place" moves the centre ~30 cm per 90°
  ([LOCALIZATION.md](LOCALIZATION.md)). Give turns room, and use
  `./rover drive` when the position after a turn matters.

## 10. The whole-home map — once, with the owner watching

The brain's "go to the bedroom" needs ONE map of the whole home that survives power cycles
(`maps/last.*`, resumed by `./rover slam`) and the rooms saved in it by name. Do this once:

1. `SLAM_FRESH=1 ./rover up`, then `./rover wheels --nudge`. Pause YOLO/follow/track (§9).
2. Map it: either drive slowly room to room with the phone (teleop), **or** `./rover explore 30`
   and walk behind it (frontier exploration through `reach`; twin home_real: whole house in
   8.9 min). Doors open; nothing on the floor you do not want it to drive at.
3. In each room, stop and tell the brain on Telegram: "save this place as bedroom" (the
   `save_location` tool; places are stored per room id, `/home/room`).
4. `./rover slam --save home` (a named copy), and `./rover stop` (saves `maps/last.*`).
5. Next start, `./rover slam` says where it is in that map ("locked"), and "go to the bedroom"
   works. Optional, for cuVGL (camera "where am I?"): record the same drive with
   `phase2/tools/record_cuvgl.sh home 300` -- it loads the Jetson, so drive slowly.
