Rakeshreddysr2401/-langrobo_perception-/docs/img/2026-10-04_dad_drive_costmap.png

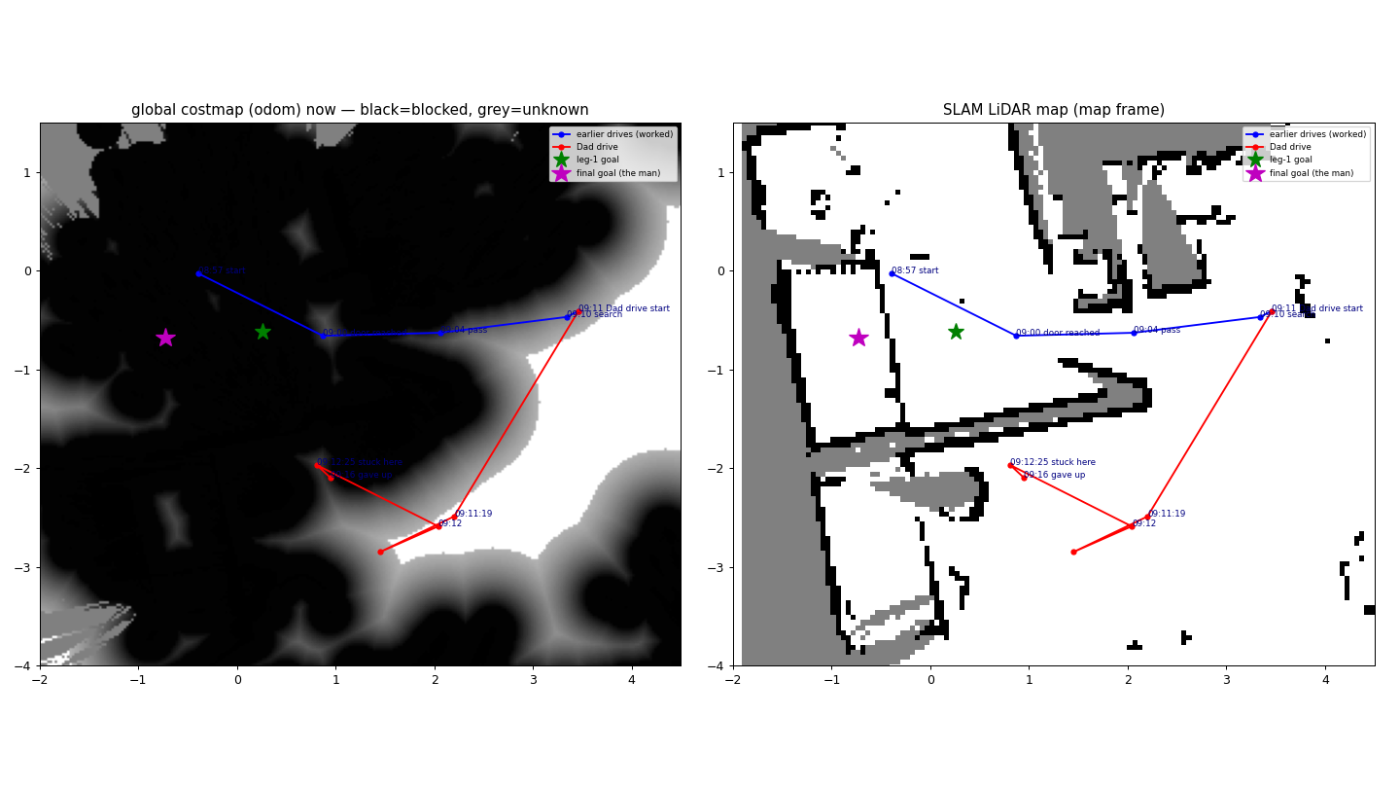
docs/img/2026-10-04_dad_drive_costmap.png
