Rakeshreddysr2401/-langrobo_perception-/description/cad/rover.step

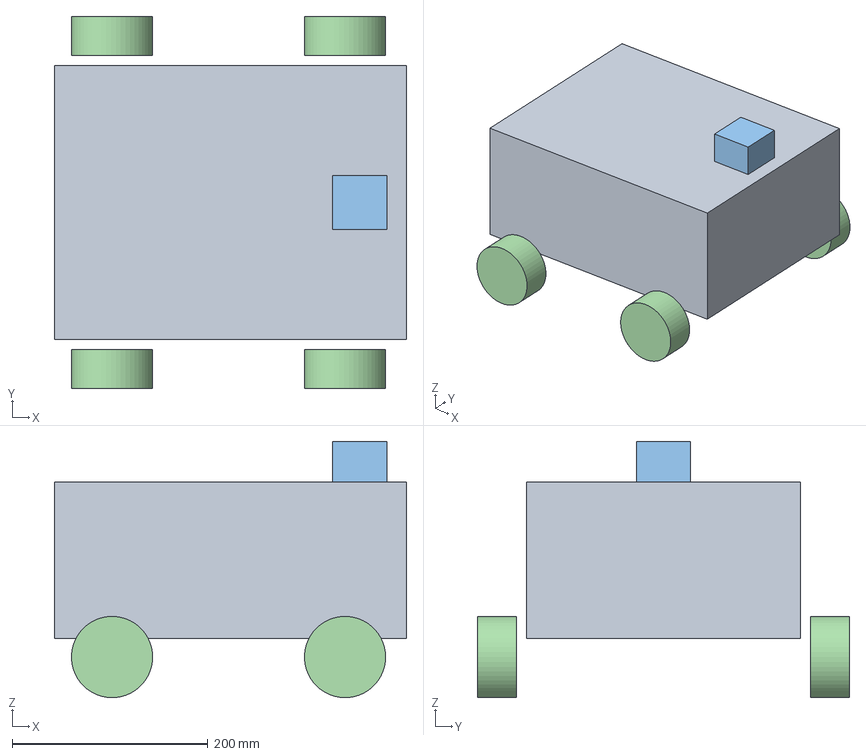
[picture p3: CAD file, 2026-10-19]
description/cad/rover.step
360.0 x 380.0 x 261.8 mm
chassis
camera_d555
lidar_c1
wheel_lf
wheel_lr
wheel_rf
wheel_rr
