Rakeshreddysr2401/-langrobo_perception-/description/cad/wheel_rf.stl

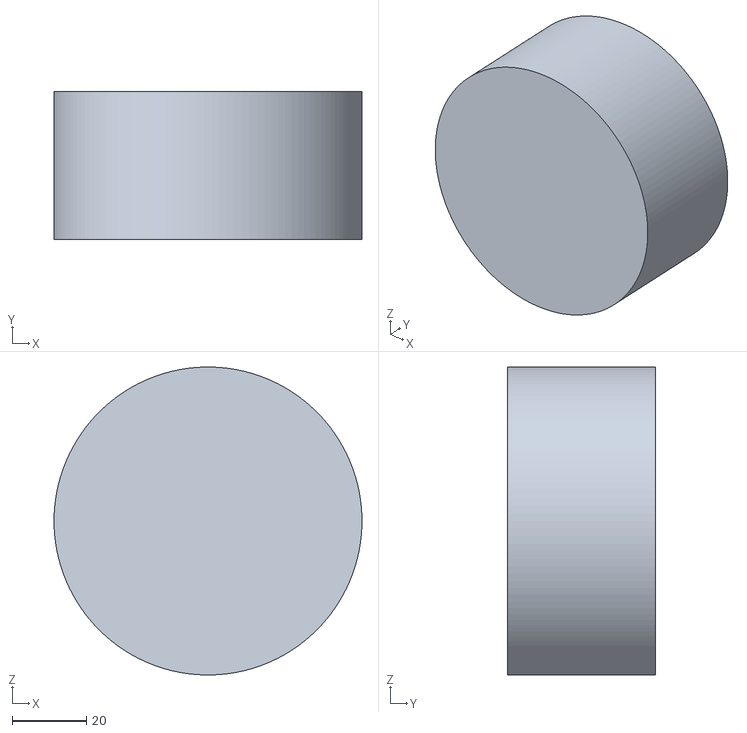
[picture p4: CAD file, 2026-09-23]
description/cad/wheel_rf.stl
83.0 x 40.0 x 83.0
