Rakeshreddysr2401/-langrobo_perception-/description/cad/lidar_c1.stl

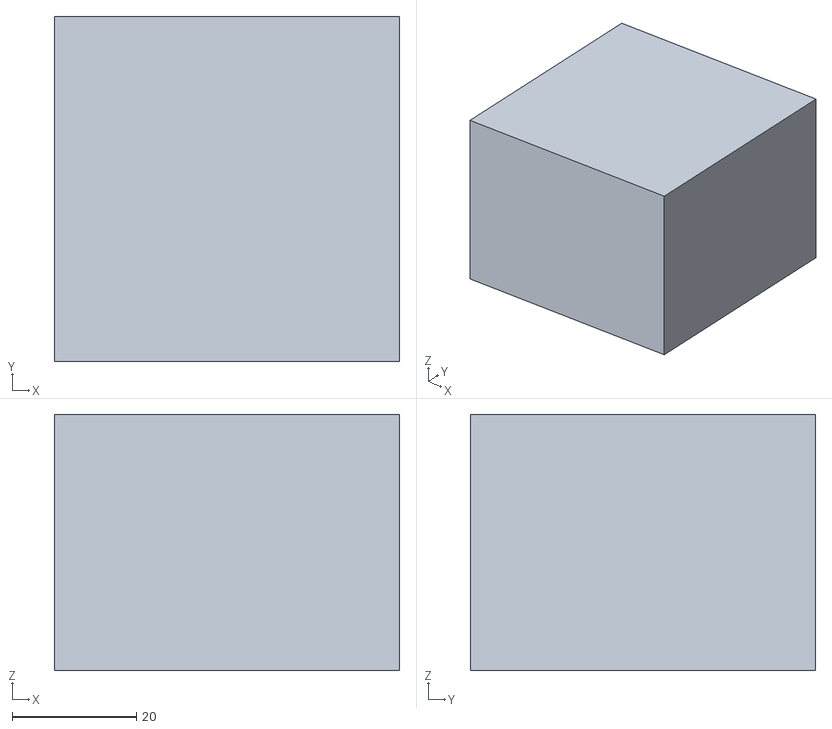
[picture p5: CAD file, 2026-09-23]
description/cad/lidar_c1.stl
55.6 x 55.6 x 41.3
