Rakeshreddysr2401/-langrobo_perception-/description/cad/chassis.stl

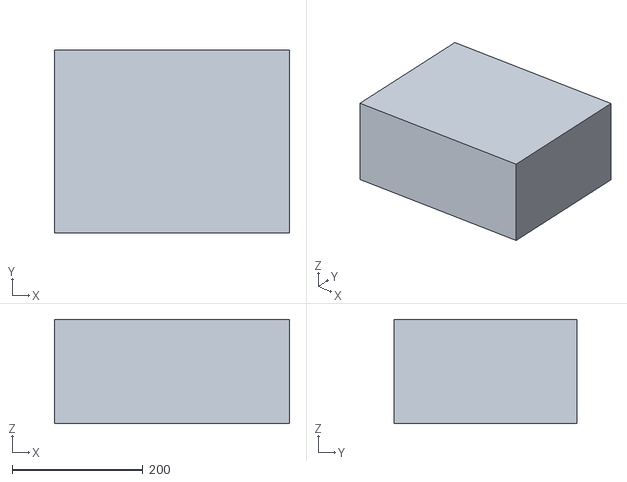
[picture p6: CAD file, 2026-09-23]
description/cad/chassis.stl
360.0 x 280.0 x 160.0
