Rakeshreddysr2401/-langrobo_perception-/description/cad/camera_d555.stl

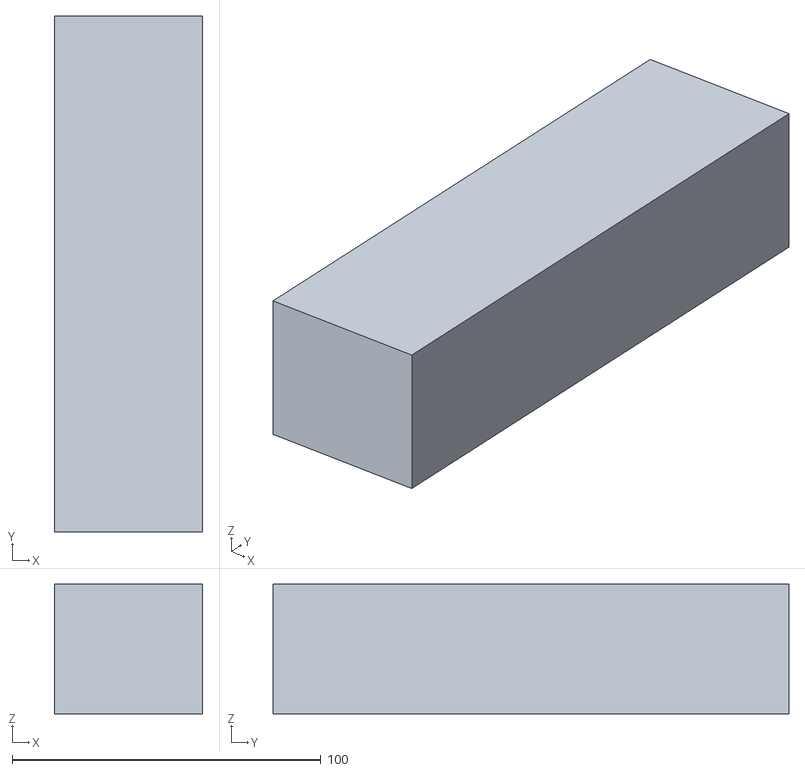
[picture p7: CAD file, 2026-09-23]
description/cad/camera_d555.stl
48.0 x 167.0 x 42.0
