Rakeshreddysr2401/-langrobo_perception-/(list of files, cad)

Other CAD files:
description/cad/wheel_lf.stl
description/cad/wheel_rr.stl
description/cad/wheel_lr.stl
