Rakeshreddysr2401/-langrobo_perception-/OPERATIONS.md

# Operations — the runbook

How to bring the rover up, measure it, calibrate it, and diagnose it when it
misbehaves. For *why* anything is the way it is see
[ARCHITECTURE.md](ARCHITECTURE.md); for the measured numbers see
[docs/archive/PHASE1.md](docs/archive/PHASE1.md).

---

## 1. Bring-up

> Coming back from a power cycle? **[STARTUP.md](STARTUP.md)** is the shorter
> path: it covers all five boxes, not just the Jetson stack, and ends with the
> Studio link. This section is the reference for what each layer proves.

Run these **in order**. Each checks the layer beneath it, so a failure names its
own layer instead of hiding in a wall of log.

```bash
./rover camera      # the D555 alone
./rover lidar       # the RPLidar C1 -> /scan, and base_link -> laser
SLAM=false ./rover pose   # + cuVSLAM and the gyro, loop closure OFF
./rover fused       # + the fused pose -> /odom and TF
./rover slam        # + slam_toolbox: map -> odom, the LiDAR correction
./rover map         # + nvblox: build the room as it drives
./rover nav         # + nav2: plan a route and drive it
./rover vlm         # + the VLM bridge: a picked pixel -> a nav2 goal (phase 4)
./rover follow      # + "follow me": detect (YOLO people) + follow_node (in ./rover up since 2026-10-11)
```

| command | what it proves |
|---|---|
| `./rover camera` | streaming ≥15 Hz **and** the IR emitter verified OFF by read-back |
| `./rover lidar` | `/scan` ≥8 Hz **and** `base_link → laser` resolves (a scan nothing can transform fails the gate) |
| `./rover pose` | cuVSLAM ≥10 Hz, gyro ≥50 Hz, re-framed into `base_link` |
| `./rover fused` | `/odom` ≥15 Hz, TF `odom → base_link` owned by exactly one node |
| `./rover slam` | `/map` ≥0.3 Hz, and **refuses** if cuVSLAM already owns `map → odom` |
| `./rover map` | the occupancy grid publishing, and how much is mapped |
| `./rover nav` | both costmaps carrying obstacle data, all servers activated |
| `./rover vlm` | compressed colour ≥2 Hz, and `pixel_to_goal` subscribed to `/vision/pixel_query` |
| `./rover follow` | `follow_node` subscribed to `/follow/start`, and a `/vision/people` publisher (detect) |

**Restarting `fused` destroys the map.** The pose origin resets, so the old
geometry would land in the wrong place. Restart `map` whenever you restart
`fused`.

Then, at any time:

```bash
./rover status      # every layer's rate, one screen
./rover values      # one-shot readout of every sensor
./rover wheels      # the ESP32 link specifically
./rover wheels --nudge   # MOVES ~7 cm: proves the motors are POWERED, not just linked
./rover slam --check     # odom alone vs LiDAR-corrected, and the correction
./rover logs vo     # tail a layer's log: camera | vo | gyro | fused | lidar | slam
./rover stop        # tear the container down
```

### Exact moves and grading turns — see [LOCALIZATION.md](LOCALIZATION.md)

```bash
./rover drive 0 0 90 --rel     # turn 90 deg left without the centre moving
./rover drive X Y [DEG]        # go to a pose in the map frame
./rover drive --mark NAME      # remember this pose;  --to NAME  goes back
./rover lidar --calibrate      # measure LIDAR_YAW by driving
./rover lidar --lag            # measure the scan timestamp error
```

All of these move the rover except `--mark`, need teleop in AUTO, and check the
LiDAR for clearance first. A plain turn "in place" slides the centre ~30 cm per
90° on this chassis; `./rover drive` plans around it.

### Before you trust anything

**Rates are the honest signal.** Every failure this rig has had was a rate
collapsing, not a topic disappearing. `./rover status` is the first thing to
look at when something is odd.

---

## 2. Driving it

Teleop lives on the Pi 5: **`http://192.168.1.16:8091`** from a phone on the same
WiFi.

**It defaults to AUTO and the buttons do nothing until you flip it to MANUAL.**
That is nav2/the brain owning `/cmd_vel`, not a fault. In MANUAL it publishes at
10 Hz whether or not a button is held, so `/cmd_vel` traffic alone proves
nothing — only a non-zero velocity does.

| button | commanded | speed at the camera | |
|---|---|---|---|
| forward / back | 0.20 m/s | 20 cm/s | ✅ under the tracking limit |
| left / right pivot | 2.0 rad/s | **34 cm/s** | ⚠ over it — expect jumps |

Release is a **coast**, not a brake: the wheels decay to zero over ~0.5 s. Motion
is gated on a `/cmd_vel` newer than 500 ms, so a lost connection stops the rover.

---

## 3. Testing the pose: record, then grade against LiDAR truth

The Phase 1 tape gates (`./rover compare`) are retired. Every pose estimate is
now graded against where the LiDAR says the rover really was
([phase1/harness/README.md](phase1/harness/README.md)):

```bash
./rover record return        # YOU move it anywhere, put it back on the tape marks: all should read ~0
./rover record straight      # also: pivot90, pivot360, square, small, turn, still, manual (these DRIVE)
./rover grade                # the newest run: truth vs fused / lidar / vo / wheels, cm and degrees
./rover grade --summary      # every run -> logs/bags/SUMMARY.md
```

Acceptance and the latest numbers: [SENSOR_FUSION_PLAN.md](SENSOR_FUSION_PLAN.md)
§5 and [LOCALIZATION.md](LOCALIZATION.md) §8-11.

## 4. Calibration

All of these run inside the container. Prefix with:

```bash
docker exec -it rover bash -lc 'source /opt/ros/lyrical/setup.bash; export ROS_DOMAIN_ID=0; <command>'
```

| what | command | procedure |
|---|---|---|
| **how much is mapped** | `python3 -u /opt/rover2/tools/map_stats.py` (in the container) | nothing — it just reads |
| **camera tilt and height, off the floor** | `./rover camera --floor` | nothing: rover still on open floor |
| **camera vs LiDAR (one camera yaw everywhere)** | `./rover camera --lidar` ×5, then `--solve` | place it by hand facing a corner each time |
| **gyro scale, turns, straights** | `./rover record pivot360` / `straight`, then `./rover grade` | clear ~0.7 m; charged pack |
| **LiDAR mount angle** | `./rover lidar --calibrate` | nothing — it drives three 0.20 m out-and-back pairs itself |
| **LiDAR timestamp error** | `./rover lidar --lag` | nothing — it turns briefly each way itself |

### Calibration rules learned the hard way

- **Calibrate against a tape, never against another sensor.** cuVSLAM reads ~2%
  under; calibrating to it bakes that into every wheel.
- **Forward only.** Reversing lets a counting error cancel itself and hide.
- **A 360° beats a 90°.** Four times the signal, and returning to the same floor
  line is far easier to judge than eyeballing a right angle.
- **Never set an angle from a description of a picture.** Two `LIDAR_YAW` values
  set that way were both wrong, sign inverted. Measure by driving
  (`--calibrate`), where two sensors must agree on the same move.
- **Point samples of `/wheel_state` lie.** The encoder reads 0 between its own
  updates, so sampling every 0.5 s during a pivot made a working left side look
  dead. Average over the command window.
- **Never compare cumulative counts (arc length) against `straight`
  (displacement).** On a path that curves or doubles back they are different
  quantities. This produced a confident "the encoders are 2× out" that was
  entirely wrong.

---

## 5. Troubleshooting, by symptom

### The camera

**Three distinct failures that look alike.** Tell them apart before acting:

| symptom | what is true | fix |
|---|---|---|
| `No RealSense devices` **and** `ethtool` says `Link detected: no` | no electrical link — cable or PoE injector | reseat the cable; nothing on the camera can help |
| `dds-device.cpp:46 device is offline`, driver alive, 0 publishers | link fine, on-camera DDS server dead | unplug 5 s, replug |
| streams at 30 Hz but `ros2 param set` times out | **half-alive**: image traffic works, option traffic does not | power-cycle, then **wait 30 s** before re-attaching |

```bash
cat /sys/class/net/enP8p1s0/carrier     # 1 = cable link is up
ping -c2 192.168.11.55                  # answers even when completely dead
```

**Ping is not a health check. Nor is a live image stream.** The only proof is the
emitter read-back, which `./rover camera` does for you and refuses to continue
without.

### The detector (YOLO)

`./rover detect` prints which backend it loaded: `YOLO backend: tensorrt …` is
the fast one (~16 % of a core and 0.6 GB at 5 Hz); `pytorch …` works the same
but costs ~2x the CPU and +0.8 GB. Why it fell back is the next line, and in
`./rover logs detections_3d`:

| it says | fix |
|---|---|
| `no TensorRT engine for TensorRT X` | `./rover engine` once (~8 min, loads the GPU: not while driving), then `./rover detect` |
| `built with TensorRT A, the host now has B` | a JetPack update changed TensorRT: `./rover engine` again |
| `the host's is not mounted at /hosttrt` | the container predates the change: `./rover stop`, `./rover up` |

The engine must be built by the HOST's TensorRT: the image's (10.13) refuses
this Orin (SM 87). Details: `phase4/nodes/yolo_backend.py`. Check it any time
(no robot needed, in the container):
`LD_LIBRARY_PATH=/hosttrt/lib:$LD_LIBRARY_PATH PYTHONPATH=/hosttrt/py:$PYTHONPATH python3 /opt/rover4/tools/test_yolo_backend.py`

### The target tracker (closed loop)

`./rover track` (started by `./rover up`) sleeps until a `/target/lock`.
`ros2 topic echo /target/state` while locked: `tracking` = seen this frame;
`coasting` / `occluded` = not seen, point held; `out_of_view` / `too_close` =
cannot be seen from here, point held; `lost` = in view but unseen 3 s (ask the
VLM). A lock `refused` names why: `photo_not_kept` (the Pi 5 did not announce
the photo on /vision/pixel_snapshot, or it is > 24 photos old), `no_camera_info`
(camera down), a box too small. Tests, no robot: `python3
phase4/tools/test_target_lock.py`; the node over ROS: `phase4/tools/sim_target_track.py`.

**Closed loop without the brain** (DRIVES; owner present): `./rover approach bottle`
-- YOLO finds the nearest bottle, the tracker keeps refining it, /reach drives and
the goal follows. `--mode oneshot` is today's behaviour, for comparison. It prints
a JSON line (also appended to `logs/approach.jsonl`).

### Frame memory (keyframes, EmbeddingGemma 2)

`./rover memory` (started by `./rover up`; [FRAME_MEMORY.md](FRAME_MEMORY.md)). Two parts:
the model server on the **host** (`phase4/tools/embedder.sh status`, log
`logs/embedder.log`) and `keyframe_memory.py` in the container (`./rover logs memory`).
Its health, 1 Hz: `ros2 topic echo /vision/keyframes/status`.

| symptom | meaning | do |
|---|---|---|
| `"embedder": false`, keyframes not growing | the model server is down | `embedder.sh status`; `logs/embedder.log` says why: `GUARD -- available RAM ... < 600 MB` (it stood down for the robot; free memory, then `./rover memory`) or `container ... is gone` |
| `embedder.sh start` says `NOT starting: available RAM` | less than ~1.5 GB free | something else is holding RAM; the robot comes first |
| `frames` stays 1 while parked | correct: a same-view refresh **replaces** the frame (every 30 s), it does not add one | -- |
| `/odom` under 15 Hz after it starts | the GPU or memory is overloaded | `embedder.sh stop`; never raise `EMBED_TOKENS` above 70 without re-measuring (FRAME_MEMORY.md §2) |
| every query `weak`, even for things in view | `reference` not ready (status shows `building`) or the words are vague | wait ~70 s on a first start; describe it ("a black backpack", not "bag") |
| a placement fails `snapshot_expired` for a hit | the keyframe's depth aged out (> 660 s) or the odom origin changed | ask again: the memory itself also forgets after 600 s |

Tests, no robot: `python3 phase4/tools/test_keyframe_memory.py` (23 checks; in the
container: `docker exec rover python3 /opt/rover4/tools/test_keyframe_memory.py`).

### The wheels

```bash
./rover wheels                          # rate at the Jetson
ros2 topic echo /rover_diag --once      # the board's own report
```

`/rover_diag` gives `x` = `loop()` Hz, `y` = free heap KB, `z` = agent state
(2 = connected). **If `loop()` is in the hundreds, the firmware is fine and the
problem is the network.** That distinction used to cost a day.

The ESP32 is on the Pi 5's USB cable since 2026-10-07, so its own link has no
WiFi in it; `/wheel_state` still crosses the **Pi 5 <-> Jetson WiFi** to get
here. Jitter at the Jetson with a steady 20 Hz on the Pi 5 means that WiFi. Check signal:

```bash
iw dev wlP1p1s0 link | grep -iE 'signal|bitrate'
```

−36 dBm is good; −47 dBm and rising jitter means the rover has moved away from
the access point.

**Link healthy, nothing moves.** `./rover wheels --nudge`. If the firmware
echoes the command (`/wheel_state.z` = the vx it received) and both sides read
exactly zero, the motor supply is off — a switch or the BTS7960 feed. The rate
gate cannot see this (2026-09-23).

**It turns, but slides ~30 cm per 90°.** Expected on this chassis — the left
side cannot reverse against the tyres' scrub (and it grows as the pack drains,
ROVER_BUILD_PLAN.md §4.5). `./rover record pivot90` + `./rover grade` measures
it; `./rover drive` plans around it. See [LOCALIZATION.md](LOCALIZATION.md).

### The pose

| symptom | likely cause |
|---|---|
| `straight` grows while parked | gyro bias stale — should self-correct; check `STILL — retuning bias` appears |
| many teleports, `landmarks` low | featureless scene. Drive where there is furniture, not a bare wall |
| many teleports, `landmarks` healthy | genuinely unexplained. Speed is NOT the answer — 89 cm/s with 0 teleports on 2026-08-22. See TODO §3 |
| `wheels` row wildly wrong in turns | expected — skid-steer scrub. The gyro owns heading |
| `FUSED` worse than an input | a real bug. This has happened twice; see docs/archive/PHASE1.md §7 |
| `/odom` frozen, goal_exec refuses "gyro stalled: the pose is frozen", status says "the gyro has stopped" | the D555 link stalled (the gyro rides it — OPEN_ISSUES #2). `ros2 topic hz /gyro/base`; usually resumes by itself within seconds; if not, `./rover pose` |

### The map

| symptom | likely cause |
|---|---|
| RViz map display empty, topic alive | **QoS.** nvblox is VOLATILE, nav2's costmaps are TRANSIENT_LOCAL. RViz renders a mismatch exactly like a dead publisher |
| subscriber gets nothing, `topic hz` shows 5 Hz | wrong topic: `static_map_slice` is a `DistanceMapSlice`. The `OccupancyGrid` is `static_occupancy_grid` |
| `./rover map` gate reads 0 Hz | checked too early — nvblox allocates GPU hash tables before publishing. The gate waits 25 s |
| walls doubled or offset | the pose drifted; the map was written twice in different places |
| map smears suddenly | a cuVSLAM teleport. **Unrecoverable** — nvblox cannot un-write it. Check `jumps` in `/fusion/status` and restart the map |
| large areas blank despite driving there | the camera never saw them — a wall behind the rover stays unknown until it turns |

### nav2

| symptom | likely cause |
|---|---|
| `bt_navigator` fails: *"spin action server not available"* | a behaviour tree still references Spin. **Both** trees need overriding, `navigate_to_pose` and `navigate_through_poses` |
| costmap topic silent but the node is fine | `always_send_full_costmap: false` — it only sends deltas after the first full map |
| `Invalid frame ID "odom"` at startup | a race; the costmaps come up before the TF is flowing and recover |
| rover sits still after a goal | stale row: it pivots since 2026-08-22. Look at the recoveries in `./rover logs nav` |
| goal rejected as unreachable | the GOAL cell is blocked, or the rover is standing in one. RViz's global costmap shows which; `./rover reach` says why in its status line |
| RViz costmap frozen while the rover moves | a nav2 process died (planner_server hosts the global costmap). nav2 now runs under `nav2_supervise.sh`: any death restarts it whole within ~20 s; restarts are in `/tmp/nav_restarts.log` (in the container) |
| planner_server segfaults (exit -11) | changing `footprint_padding` live with `ros2 param set`. **Don't**: edit nav2.yaml and `./rover nav` |
| a gap the rover fits is solid cyan in RViz | cyan = the centre may not go there. A passable gap shows pink edges, cyan bands, and a coloured strip in the middle. Too tight for nav2's 5 cm padding: `./rover pass` (LOCALIZATION.md §13) |

### RViz shows nothing

**Check this first: was it started with `-d`?**

```bash
bash ~/rover_live.sh          # correct -- on the laptop, in a desktop terminal
rviz2 -d ~/rover_live.rviz    # correct, the long way
rviz2 ~/rover_live.rviz       # WRONG -- silently ignored
```

`rviz2` ignores a bare config path. Without `-d` it starts with its **defaults**:
Fixed Frame `map`, which does not exist on this rover, and **zero displays**. A
blank window, no error, and the ROS graph shows `/rviz` connected while
subscribing to nothing. Use `./rover view` from the Jetson, or `bash
~/rover_live.sh` on the laptop — neither can get this wrong.

**`./rover view` needs somebody logged in at the laptop desktop.** RViz started
over ssh into a login screen renders into a void and exits 0. The launcher
refuses in that case and says so rather than reporting success; log in there and
re-run, or start it on the laptop by hand with the command above.

**The laptop key (`rover-laptop`).** The launcher checks the laptop's ssh host
key under the alias `rover-laptop`, not under its DHCP address -- keyed by IP,
every new address was an unknown host, BatchMode refused it, and the search
walked past the laptop (2026-10-09, at .5). Written once, per Jetson:

```bash
ssh-keyscan -t ed25519 <laptop ip> | sed 's/^[^ ]*/rover-laptop/' > /tmp/lk
ssh-keygen -lf /tmp/lk     # must match the Pi 5's: ssh-keygen -lF rakhi24.local
cat /tmp/lk >> ~/.ssh/known_hosts
```

"Did not answer ssh within 15 s" is the WiFi (or that key), never a login
problem; the launcher says which.

It does **not** decide that by looking for an `Xwayland` process any more. GNOME
starts Xwayland on demand, so a freshly logged-in laptop has none and used to be
reported as a login screen — see [docs/archive/TODO.md](docs/archive/TODO.md) §35. It now asks `loginctl`
for an active graphical session and uses mutter's waiting auth cookie.

| symptom | cause |
|---|---|
| blank, `/rviz` in the graph, **0 subscribers** on `/odom` | started without `-d` |
| blank, displays listed, Global Status red | Fixed Frame is `map` (the default since 2026-09-22) and **`./rover slam` is not up** — start it, or set Fixed Frame to `odom` |
| everything but the LiDAR ring draws | `base_link → laser` missing — re-run `./rover lidar` (its gate now catches this) |
| a config change "did nothing" | RViz reads the config only at startup: `./rover view --restart` |
| one display blank, others fine | **QoS.** nvblox is Volatile, nav2 costmaps are Transient Local |
| `GLSL link result: active samplers...` | a driver quirk in RViz's Map shader; usually still draws |

To confirm from the rover whether RViz is really subscribing:

```bash
ros2 topic info /odom        # Subscription count should be >= 1
```

### Teleop

| symptom | cause |
|---|---|
| buttons do nothing | still in **AUTO** — flip to MANUAL |
| turn command drives forward/backward | not enough duty to scrub four tyres. See TODO §14 — `WZ` must be ~5.0 for this firmware, not 2.0 |
| `/cmd_vel` traffic but nothing moves | in MANUAL it publishes 10 Hz of zeros whether or not a button is held. Only a **non-zero** velocity means anything |

Restart it **without a password** — it runs as your user with `Restart=always`:

```bash
ssh 192.168.1.16 'pkill -f teleop_web.py'
```

### Everything looks alive but nodes cannot see each other

A stale `ROS_DISCOVERY_SERVER`. `./rover` unsets it on every command; if you are
running something by hand, do the same.

### An obstacle stays in RViz after the person has gone

Pink cells with the light-blue inflation ring, in FRONT of a standing rover,
still there after whoever made them walked off (owner, 2026-09-26). The local
costmap is the per-cell max of the camera layer (nvblox, which never forgets
on purpose: that is how a low object stays in the map once it is too close to
see) and the LiDAR layer (cleared by raytracing). **Run this while the blob is
on screen**; it says which layer holds each lethal cell ahead:

```bash
docker exec rover bash -lc 'unset ROS_DISCOVERY_SERVER FASTRTPS_DEFAULT_PROFILES_FILE; \
  export ROS_DOMAIN_ID=0; source /opt/ros/lyrical/setup.bash; python3 /opt/rover3/tools/ghost_check.py'
```

`live` = the LiDAR sees it now; `camera memory` = only nvblox's planning slice
has it (a low object, or a person nvblox has not yet seen leave); `stuck in the
LiDAR layer` = no beam has crossed it since.

Measured 2026-09-26, three walk-ins (a pass; 15 s standing facing a door at
2 m; standing facing open space beyond the camera's 3 m reach): **every one
cleared**, nvblox within ~2 s. Two things were seen that are not yet
explained: the costmap cleared in steps up to **~14 s** after nvblox had, and
twice the costmap ended a test 150-400 lethal cells BELOW where it started --
stale cells from earlier, flushed by the walk-in, that nvblox's own grid did
not hold. The next stuck blob, caught with the checker, decides which layer
to change. Turning nvblox's decay back on is NOT the fix to reach for: it also
forgets low obstacles (nvblox.launch.py, DO NOT LET THE MAP FORGET).

**Since 2026-10-04 `ghost_clear` erases the camera's marks of things that
moved** (`phase2/nodes/ghost_clear.py`; OPEN_ISSUES S10). A camera mark the
LiDAR also hit is tall -- a person, a chair; once a LiDAR beam returns from
beyond it, it moved, and it is erased from `/ghost_clear/grid`, the grid nav2
and goal_exec read. Marks under the rover are erased too. A mark only the
camera saw (a shoe, a box under the 25 cm LiDAR plane) is never erased by the
LiDAR; it comes back if the LiDAR hits it again or the camera keeps seeing it.
Floor-tested with the owner the same day: legs left behind the rover erased, a
box kept with the camera turned away.

- watch it: `docker exec rover bash -lc '... python3 /opt/rover2/tools/ghost_watch.py 120'`
  (add `back` for the box behind the rover): camera marks / erased / kept
- RViz: the blocker view shows erased cells GREY
- a mark that stays: run `ghost_check.py` as above. A RED (LiDAR-layer) trace
  that stays is usually in the SHADOW of something nearer -- no beam reaches it,
  so nothing can say it is gone (seen 2026-10-04, 1.4 m behind the rover with
  something at 1.15 m)
- off: `ROVER_GHOST_CLEAR=off` in the container before `./rover map` (passes
  nvblox's grid through unchanged)
- stuck with marks everywhere anyway: `./rover map` starts nvblox empty

### RViz colours (the blocker view, "who says so")

| colour | meaning |
|---|---|
| RED | only the LiDAR says blocked (walls, legs, people -- the 25 cm plane) |
| ORANGE | only the camera says blocked (low things under the LiDAR -- or a phantom) |
| PURPLE | both agree |
| GREY | erased by ghost_clear: moved away, NOT an obstacle |
| GREEN | the brain's target |

(A one-meaning-per-colour scheme -- red both, blue LiDAR, amber camera, pink
erased -- was tried on 2026-10-04 and reverted the same day at the owner's
request; commit 49e22a9 has it.)

The blocker view is on for the near 4 m AND the whole 8 m room, so every cell
the planner treats as blocked is shown, coloured by who says so. The room view
is drawn in 10 cm squares (each takes its most important colour: purple, red,
orange, grey) so it reads at whole-room zoom; the near view keeps every 2.5 cm
cell and draws over it -- zoom in near the rover for the detail. (At 2.5 cm a
cell is ~2 px zoomed out, and only the LiDAR ring showed, 2026-10-04.)

---

## 6. Flashing the ESP32

Full instructions in [phase1/firmware/FLASHING.md](phase1/firmware/FLASHING.md).
In short:

1. Pull the repo on a machine with the Arduino IDE.
2. **Set `WIFI_PASS` on line 68 — locally only. Do not commit it back.**
3. Board: ESP32 Dev Module. Requires **esp32 core 3.x** (the firmware uses the
   3.x per-pin PWM API) and **micro_ros_arduino, jazzy branch**.
4. Watch the serial monitor at 115200 for `[uROS] entities live`.

If you see `[uROS] FAILED to create <topic> — entity limit?`, the precompiled
library's entity caps have been exceeded. Drop `/rover_diag` first, then
`/wheel_odom`. **Never drop `/wheel_ticks`** — it is the distance reference.

---

## 7. The brain — LangGraph Studio on the Pi 5

The agent graph the Pi 5 runs can be opened in LangGraph Studio: every node,
every tool call and every handover, live. Useful for reading the agentic flow
rather than inferring it from Telegram replies.

### It is not started by anything

Nothing on the Pi 5 starts it at boot — `agent_node` runs the graph in-process
and needs no server. Studio is a **separate dev server** you start by hand.

```bash
ssh 192.168.1.16 'setsid nohup ~/ros2_ws/scripts/start_studio.sh \
    > /tmp/langgraph_dev.log 2>&1 < /dev/null &'
```

`~/ros2_ws/scripts/start_studio.sh` on the Pi 5 holds the environment, and holds it for
a reason — every line in it is something that fails quietly if you get it wrong:

- **It `cd`s to `~/ros2_ws` itself.** The CLI reads `langgraph.json` and `.env`
  from the working directory, not from its own location.
- **Full path to `~/.local/bin/langgraph`.** It is not on a non-interactive ssh
  PATH, so `ssh pi 'langgraph dev'` is `command not found`.
- **ROS vars matched to `agent_node`'s** — plain SUBNET discovery, domain 0. A
  stale `ROS_DISCOVERY_SERVER` gives a bridge that starts perfectly cleanly and
  silently sees no robot.
- **`LANGROBO_MEMORY_PATH` set to a Studio-only store**, and deliberately NOT in
  `.env` — `agent_node` reads that same file, so putting it there would repoint
  the *robot's* memory. See the episodic-memory note below.
- **No `set -u`.** ROS's `setup.bash` references unset variables, so `set -u`
  aborts the script the instant it is sourced — silently, if its stderr is going
  to `/dev/null`.
- **`--allow-blocking`**, because the graph does synchronous ROS and HTTP work
  and the server otherwise raises on the first blocking call.

It takes 30-60 s to answer. Poll rather than assume:

```bash
ssh 192.168.1.16 'curl -s http://127.0.0.1:2024/ok'     # {"ok":true} when ready
```

Log: `/tmp/langgraph_dev.log`. To stop it:

```bash
ssh 192.168.1.16 'pkill -f "langgrap[h] dev"'
```

**The brackets are not a typo and not optional.** `pkill -f "langgraph dev"`
matches its OWN command line — the pattern text is *in* the command sshd is
running — so the remote shell kills itself and its own ssh session. You get
exit 255, no output, and nothing killed, which reads exactly like the Pi 5's
intermittent ssh. `langgrap[h]` is a regex that does not match the literal
string `langgrap[h]`, so it only matches the server.

### Reaching the UI

It binds to localhost deliberately. Tunnel from the machine with the browser:

```bash
ssh -N -L 2024:localhost:2024 rakhi24@192.168.1.16
```

then open `https://smith.langchain.com/studio/?baseUrl=http://127.0.0.1:2024`.

**The tunnel is not just convenience.** Studio is served over HTTPS, so a
browser blocks it calling `http://192.168.1.16:2024` as mixed content.
`http://127.0.0.1` is exempt as a secure context, so tunnelling is what makes
the hosted UI work at all. `langgraph dev --tunnel` is the alternative and puts
a public HTTPS URL in front of the robot's agent for the life of the process.

Health checks, through the same tunnel:

```bash
curl localhost:2024/ok       # {"ok":true}
curl localhost:2024/info     # versions and feature flags
curl -XPOST localhost:2024/assistants/search \
     -H 'Content-Type: application/json' -d '{}'
```

**A blank Studio page with a healthy `/ok` is a CORS rejection, not a dead
server.** Found 2026-09-11. The browser sends a *private-network* preflight
before it may call a private address from a public HTTPS page; starlette >= 1.0
rejects that preflight unless `allow_private_network` is set, and
langgraph-api 0.10.0 never passes it — so every API call the UI makes dies at
the preflight and the page renders empty with nothing in the server log. The
curls above all still pass, because curl sends no `Origin`. Reproduce it the
way the browser does:

```bash
curl -s -o /dev/null -w '%{http_code}\n' -X OPTIONS localhost:2024/assistants/search \
  -H 'Origin: https://smith.langchain.com' -H 'Access-Control-Request-Method: POST' \
  -H 'Access-Control-Request-Private-Network: true'
# 200 = fine.  400 "Disallowed CORS private-network" = this bug.
```

The fix is one argument — `allow_private_network=config.ALLOW_PRIVATE_NETWORK`
on the `CORSMiddleware` in `langgraph_api/server.py` (the flag is already
computed correctly, just never handed over). That is **a patch to site-packages
on the Pi 5, not to any repo**: `pip` will overwrite it and the blank page comes
back. `server.py.orig` sits beside it. See [docs/archive/TODO.md](docs/archive/TODO.md) §38.

The graph is `agent`, from `graph_studio.py:graph` via `langgraph.json`.

### Three things that surprise you

- **A `navigate` turn in the browser drives the real rover.**
  `graph_studio.py` attaches a real `ROS2Bridge` whenever ROS is sourced, and
  `ros2 node list` then shows `/studio_bridge` alongside `/agent_node` — two
  bridges that can both publish `/cmd_vel`. Everything in §8 applies: a human
  watches, and MANUAL on the phone is the stop. To read flows **without** that
  risk, start it in a shell where ROS is *not* sourced: it falls back to
  `StubBridge` and tool calls are logged instead of published.
- **Studio has its own episodic memory, separate from the robot's.** Embedded
  Qdrant is single-process, so while `agent_node` holds `~/.langrobo/qdrant`
  Studio used to start with no memory at all (`Storage folder … is already
  accessed by another instance`). `start_studio.sh` now points it at
  `~/.langrobo/qdrant_studio`, so the memory tools work — but they recall
  **Studio's** memories, not the household's. That is the right trade for a dev
  tool and it cannot corrupt the robot's store. To genuinely SHARE one store,
  run a Qdrant server and set `QDRANT_URL` for both processes (`memory.py`
  supports it); that needs `agent_node` restarted and is not done.
- **`watchfiles` logs "N changes detected" every ~10 s and nothing is
  reloading.** `langgraph dev` writes its own `.langgraph_api/*.pckl`
  checkpoints inside the directory it watches. Confirm a real reload by looking
  for a second `ROS2 bridge active` in the log — one occurrence means it has
  imported the graph once.

### LangSmith, which needs none of this

`.env` sets `LANGCHAIN_TRACING_V2=true` and `LANGCHAIN_PROJECT=pi5`, so real
turns through `agent_node` are **already** traced to smith.langchain.com with no
server running and nothing tunnelled. For reading past flows that is the lower
effort path; Studio is for driving the graph yourself.

`STUDIO_MODEL` used to read `gpt-4o-mini` while `STUDIO_PROVIDER=llamacpp`,
which made every trace look like it had called OpenAI. It is now `default`,
matching `agent_params.yaml` — the honest llama.cpp convention, since the server
serves whatever model it has loaded (currently `gemma-4-12B-it-Q4_K_M`) and
ignores the field.

---

## 8. Safety

- **Hand-pushing is always safe.** `pidStep()` returns 0 below 0.01 m/s and
  `driveSide()` with zero duty coasts rather than brakes, so the wheels
  free-wheel and the PID will not fight you.
- **Motion is double-gated**: on `controlEnabled` (agent connected) *and* a
  `/cmd_vel` newer than 500 ms. An idle rover cannot creep.
- **Lift the rover onto blocks** for any wheel test. It is safer than clear floor
  and the wheels spin freely.
- **Never run anything that streams zero `/cmd_vel` while teleoperating**
  (the old `logs/keepalive.py`, removed 2026-09-26, was one): it interleaves
  with real commands and makes the rover stutter.

## Health, watchdog, saved room (2026-10-16)

- `./rover health` — every layer's rate in one ~15 s pass (`status` uses the same pass since 2026-10-18, plus processes and the pose check).
- `rover-watchdog` (systemd, installed with `sudo ops/install_services.sh`) probes
  every 30 s, serves `http://<jetson>:8099/` (JSON at `/health`), and logs changes
  to `logs/watchdog.jsonl`. **Observe only.** To let it restart a dead layer:
  `sudo systemctl edit rover-watchdog` → `Environment=ROVER_WATCHDOG_ACT=1`. Even
  then it never acts while `/cmd_vel` is non-zero or `~/.rover_watchdog_pause`
  exists (`./rover watchdog pause|resume`), restarts the lowest failed layer
  only, and gives up after 2 restarts per layer per 15 min. `./rover watchdog
  status|start|act|stop`. `ops/rover-up.service` (stack at boot) is installed
  but NOT enabled; `sudo ops/install_services.sh --boot-up` enables it.
- Saved room: `./rover slam` autosaves the pose graph every 2 min to
  `maps/last.*` (+ `last.pose`, where the rover stood; `last.prev.*` = the save
  before), `./rover stop` saves too, and the next `./rover slam` resumes from
  it at `last.pose` (`SLAM_START_POSE="x,y,theta"` if it was moved,
  `SLAM_FRESH=1` to start empty). Tested 2026-10-16: restart resumed within
  1 cm and the old walls were there. nav2 still plans in `odom`, not `map`.
- `./rover net` — signal, link rate, ping jitter to the Pi 5, ROS traffic.
  Measured 2026-10-16: WiFi carries ~3.5 Mbit/s of ROS data, so bandwidth is not
  the limit; signal is. DDS unicast-only discovery was tried (FastDDS peer XML,
  `ROS_STATIC_PEERS`) and did not prove multicast was off: left unchanged.
