Rakeshreddysr2401/-langrobo_perception-/(commit log)

2026-08-11 initial: layered rover stack, promoted from the working parts bin
    WHY THIS REPO
    The old stack works but is illegible: camera + TF + cuVSLAM + nvblox all
    start at once, so when something breaks any of four layers could have done
    it. On 2026-08-11 it ran for an hour with TWO nvblox nodes competing, each
    building its own map and both publishing to the same topic, and nothing said
    so. The goal here is not new capability, it is being able to prove one layer
    at a time.
    WHAT IS HERE
    rover.sh l1..l5. Each layer starts ONLY what it adds and REFUSES to
    start if the layer below it is not healthy (assert_rate).
    FACTS.md everything measured, with num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
2026-08-11 PRD: add stage 2 — the rover explores and maps a room by itself
    The PRD stopped at "click a goal in RViz and it drives there". That is a
    RELIABLE rover, not an autonomous one -- at that point the human is still the
    intelligence. Split the goal into two stages with a hard line between them:
    stage 1 (tasks 01-07) click a goal, it drives there, on a map it built
    stage 2 (task 08) switch it on in an unmapped room, it maps the room
    by itself. no pushing, no clicking.
    Stage 2 is frontier exploration: find the boundary between mapped and unknown,
    pick one, send yourself a nav2 goal, drive, look, repeat. It needs no new
    perception -- the map already distinguish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
2026-08-11 add grill-me skill, and record the git setup
    The grill-me skill comes across from the old repo so plans can be stress-tested
    from inside this one -- which is how stage 2 got defined in the first place.
    Also renamed the local branch master -> rover-v1 so local and remote match, and
    documented in the README that rover-v1 is an ORPHAN branch on the shared GitHub
    repo. It shares no commits with main or any dev-0.0.x, which is deliberate and
    means it must never be merged into main.
2026-08-11 add knowledge/ — the concepts, and a learning log on every task
    The tasks said what to do and gated it, but there was nowhere for what you
    learn while doing it to land, so it evaporated.
    knowledge/ holds concepts BY TOPIC rather than by task, because they do not map
    one-to-one: TF matters in tasks 02,03,04,06,07,08 and QoS bites in every one.
    Written once they get deeper over time instead of drifting apart in six copies.
    01 frames and TF 02,03,04,06,07,08
    02 visual odometry and SLAM 02,03,04,08
    03 sensor fusion and the EKF 03
    04 voxels, TSDF, ESDF, slice 04,05,06,08
    05 QoS, DDS and rates all
    06 costmaps and inflation 06,07,08
    07 planners,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
2026-08-11 record what the old repo still provides — this repo is not self-contained
    Checked rather than assumed. Two things did NOT move and are load-bearing:
    * orin-nav-stack/Dockerfile builds orin-nav:1.1, the image rover.sh runs.
    There is no other source for it, and it is 57.8 GB.
    * orin-nav-stack/firmware/ is the ESP32 source, cited here by line number.
    Plus $HOME/orin-nav-stack is a symlink into that repo and is what the old
    container mounts, so it must not be deleted.
    Deliberate for now -- copying a Dockerfile you cannot test is worse than
    pointing at the one that demonstrably built the running image -- but it means
    this repo cannot rebuild itself. Tracked as TODO item 13, to fix on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
2026-08-11 session 0: land the grill-me decisions before the first hardware run
    Paperwork only — no rover touched. Ten decisions from stress-testing the plan,
    plus three things found by reading the code instead of the docs.
    CORRECTIONS (rule 3: the machine beats the doc)
    - TODO §3 was wrong in the reassuring direction. It described "the collision
    monitor is silently unprotected" — a bug fixed on 2026-08-10. The 0.5 Hz was
    nvblox's back_projected_depth debug topic that depth_to_cloud.py replaced;
    source_timeout is 1.5 s not 2.5 s; and a stale source HOLDS THE ROBOT AT ZERO
    rather than being ignored. Rewritten: the monitor is fail-safe, the real risk
    is a rover pinned in place, and the g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
2026-08-11 session 1: first hardware run — L1 passes at 30.0/30.1 Hz
    The first execution of anything in this repo. ./rover.sh l1 passed on the
    first attempt, against TODO §7's prediction that it would fail on something
    small — camera IR 30.0 Hz, depth 30.1 Hz, both at the 896x504x30 profile cap.
    FACTS §1: recorded the L1 numbers, flagged that the FIVE-MINUTE SOAK WAS NOT
    DONE (these are ~40 s numbers, and the failure that cost a day looked perfect
    for the first thirty seconds).
    TODO §4 -> 🟡: esdf_slice_min_height lowered 0.12 -> 0.06. Both reasons for
    0.12 were gone (camera-height error fixed, floor proven not to fill the map),
    and at 0.12 every obstacle under 12 cm was invisible. UNVALIDAT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
2026-08-14 session 2: clean-slate Phase 1 — camera + from-scratch VO + side-by-side compare
    Old plan (PRD.md, tasks/, FACTS.md, src/) deleted; PLAN.md is now the plan of
    record. Pose engine rewritten from scratch against pyCuVSLAM 16.0.0.
    Working on hardware:
    camera IR 30.0 Hz, depth 25.1 Hz
    pose visual odometry 27-29 Hz, 162 landmarks, gyro 200 Hz
    Found while building:
    - infra2/camera_info signs P[3] opposite to REP-104; |baseline| 9.49 cm
    - world_from_rig is PoseWithCovariance, not Pose
    - cuvslam rejects aliased image buffers for left/right
    - tf_transformations absent from orin-nav:1.1
    - rate is not a health signal: a dead tracker returns identity at 30 Hz,
    so /vo/status now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
2026-08-14 compare: survive SIGTERM with a verdict, add --plain, write CSV to the host mount
    [compare-20260814-195911.csv]
2026-08-14 camera: the IR emitter was ON the whole time — emitter_enabled:=0 is a silent no-op
    depth_module.emitter_enabled is a Boolean parameter. The launch argument '0'
    does not parse as false, so the driver kept its default of ON while the launch
    line read as though it were off.
    Measured consequence: a 60 cm hand push read 1.1 cm on /vo/odom (55x under),
    with the pose bit-identical for 1422 consecutive frames. The projector is
    rigidly mounted, so its dot pattern is repainted from the camera's own
    viewpoint each frame and the scene appears static.
    With the emitter genuinely off:
    infra1 std 54.6 -> 23.5 (the dots supplied over half the image contrast)
    landmarks 162 -> 185, frozen_frames 1422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
2026-08-14 compare: stop path ratcheting on noise, and remove the gyro bias
    Measured parked for 125 s (thanks to the 1-minute still test):
    cuvslam position drift 0.3 cm / 125 s — the pose itself is fine
    cuvslam heading drift -0.23 deg / 125 s
    path accumulator +9.0 cm / 125 s — 26 um/frame of noise, summed as
    a magnitude so it can never cancel
    gyro bias 0.078 deg/s = 4.7 deg/min, against a 10 deg gate
    path is now accumulated in 5 mm chords rather than per frame, and the gyro bias
    is measured over the first 5 s of stillness and subtracted. Verified: bias came
    out +0.0833 deg/s independently, heading then held -0.14 d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
    [compare-20260814-202854.csv]
2026-08-14 geometry: camera is 17.0 cm forward of the pivot, not 10.0
    Measured on the rover 2026-08-15: wheelbase (front axle to rear axle, one side)
    25.0 cm, camera lens to the front axle line 4.5 cm, so cam_x = 4.5 + 25.0/2 =
    17.0 cm. The 10.0 cm in the code was a guess and 7 cm short.
    base_link's origin is on the ground at the centre of the four wheel contact
    patches, so this is measured from the pivot, not from the front face of the body.
    It matters most for the 360 deg spin test: too short a lever arm makes a pure
    pivot look like it also translated.
    Also carries the firmware into the repo so what gets flashed is version
    controlled. Confirmed unchanged: wheel diameter 8.5 cm, track width 34 cm,
    c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
    [rover_firmware_v2.ino]
2026-08-14 compare: Ctrl-C was killing the run without a verdict or a CSV
    ./rover compare ran python via 'docker exec' with no TTY. In that mode docker
    does not proxy SIGINT, so Ctrl-C killed the client while the in-container
    process never reached its shutdown path. Every run so far printed a live table
    and then lost both the grade and the logged time series — which is why no CSV
    exists after 20:28 despite several hand-push runs.
    Allocate a TTY when stdin is one, so the signal reaches python.
2026-08-14 geometry: correct a 2.06 deg camera mount yaw
    Two straight 2 m hand pushes, heading changing under 0.6 deg in each:
    197.2 cm forward, 6.7 cm sideways -> 1.95 deg
    194.9 cm forward, 7.4 cm sideways -> 2.17 deg
    Agreement to 0.2 deg over two runs makes this a fixed mounting offset, not
    noise. A 4-wheeled rover cannot crab sideways, so the rover travelled where it
    pointed and the camera is rotated on its bracket.
    This is the kind of error that survives a passing gate: it does not affect
    distance travelled and it cancels out of measured rotation, so the scale check
    (1.35% and 2.45% under, both inside +-5%) passed with it present. It only tilts
    the reported direction of travel. Corrected, bot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
    [compare-20260814-205943.csv]
2026-08-14 compare: detect pose teleports and refuse to grade a run containing one
    Measured 2026-08-15, out-and-back: cuVSLAM teleported 202 cm in a SINGLE frame
    at t=17.07s, at a healthy 28 Hz, with nothing logged. Heading stepped +20.3 deg
    in one 0.25 s sample. SLAM is off, so no loop closure could legitimately do it —
    the tracker lost features and re-initialised.
    Correlates with push speed:
    clean 2 m push median 14.3 cm/s peak 18.8 cm/s 0 teleports
    failed out-and-back median 10.2 cm/s peak 76.5 cm/s 1 teleport
    The teleport landed at the end of a fast shove. Every number after a jump is
    measured from a corrupted origin, so the run is now marked INVALID and not
    graded, rather than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
    [compare-20260814-210538.csv, compare-20260814-210843.csv]
2026-08-14 compare: add the FUSED row — distance from cuVSLAM, heading from the gyro
    Measured on a clean 2 m out-and-back (peak 16 cm/s, no teleports), splitting the
    error by leg:
    outbound 0 -> 198 cm vo-vs-gyro heading -1.74 deg (within 0.13 deg most of it)
    return 198 -> 11 cm vo-vs-gyro heading +7.68 deg
    cuVSLAM is excellent forward and poor in reverse: driving forward, features
    expand outward from the image centre with long track histories; reversing, they
    shrink toward the centre and new ones enter at the edges where they are worst
    observed. A gyro does not care which way the robot moves.
    Replaying that run with gyro heading: endpoint error 28.4 cm -> 12.2 cm (2.3x),
    lateral error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
    [compare-20260814-211111.csv, compare-20260814-211404.csv, compare-20260814-211428.csv]
2026-08-14 firmware: flashing instructions for the ESP32
    USB + Arduino IDE path, with the one-time library setup (esp32 core 3.x,
    micro_ros_arduino jazzy branch from ZIP, ESP32Encoder), what to edit (WIFI_PASS
    only), and what NOT to (AGENT_IP, wheel constants, all confirmed with a tape).
    Verification is ordered so each step needs less than the last: serial monitor at
    115200 proves the encoders by hand with no ROS involved, then ./rover wheels for
    the rate, then the compare instrument.
2026-08-14 rover: add './rover values' — every sensor's current reading in one place
    cuVSLAM pose and health (landmarks, frozen frames), the IMU both raw in optical
    axes and re-framed into base_link, and the wheel state with implied vx and yaw
    rate. Useful when something has gone quiet and you want to see which layer.
2026-08-14 compare: 1 Hz wheel data was being silently discarded; add TODO.md
    The integrator guarded against gaps > 0.5 s to stop it swallowing one huge step
    after a stall. With /wheel_state stuck at 1.000 Hz every sample has dt ~ 1.0, so
    EVERY sample was dropped and the wheels row read a permanent 0.0 while messages
    were visibly arriving at 1 Hz.
    Raise the limit to 1.5 s and integrate trapezoidally: the firmware reports the
    instantaneous velocity measured over one 20 ms control period, so at 1 Hz we are
    point-sampling a signal that updates 50x faster, and averaging consecutive
    samples roughly halves the error. Warn live when the rate is under 15 Hz so the
    number is read as a sanity check, not a refer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
2026-08-15 diagnose the 1 Hz /wheel_state: best-effort stream flush, not the firmware
    The round-trip probe settles what reading the source could not. Encoding a
    sequence number in /cmd_vel's linear.x (safe: below the 0.01 dead zone in
    pidStep, so duty is zero) and decoding it back out of /wheel_state.z shows the
    board consuming 19.71 of 20 commands per second with zero lag growth. loop() is
    fast, so the telemetry timer is firing and the messages die after publish.
    That kills the standing 'flashed binary does not match source' theory, along
    with WiFi, the DDS hop and the agent's output — Pi 5 and Jetson both read
    1.000 Hz from the same best-effort listener at the same instant, +/-2.9 ms at
    the agent,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
2026-08-15 firmware: publish /wheel_state reliably so it actually leaves the board
    Best-effort was chosen deliberately on the reasoning that a 20 Hz telemetry
    stream should not pay for delivery guarantees. On this transport that reasoning
    inverts: micro-ROS buffers a best_effort message until the XRCE session next
    runs, and rcl_publish does not flush it, so with nothing else talking to the
    board the stream drained at 1.000 Hz while loop() published at 20.
    Reliable is not about guarantees here, it is about the send happening now.
    /cmd_vel already demonstrates reliable sustaining 19.71 msg/s over this link.
    Needs an OTA flash to take effect.
    [rover_firmware_v2.ino]
2026-08-15 the 1 Hz was loop() blocking on the executor; keep the board fed
    Sweeping the rate we publish TO the ESP32 settles it. /wheel_state tracks that
    rate 1:1 up to 10 Hz (2->3.13, 5->5.08, 10->10.08) then saturates (20->11.76,
    40->16.44). loop() runs once per inbound message plus once per second when idle
    -- the 2 Hz row is 2 from messages plus ~1 from the timeout. So
    rclc_executor_spin_some(&executor, RCL_MS_TO_NS(5)) blocks until data arrives
    instead of returning after 5 ms, and the telemetry publish right after it can
    only fire as often as that call returns.
    The firmware logic was never wrong. Two reflashes chased that idea; the
    mechanism was in a library neither of them touched.
    Workaround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
2026-08-15 firmware: everything the encoders should have been giving us, in one flash
    Batched because the bench is set up now and each flash costs a trip.
    The actual 1 Hz fix: rclc_executor_spin_some(&executor, 0) instead of a 5 ms
    timeout. With a non-zero timeout that call blocks until a message arrives, so
    loop() ran once per inbound message and the 50 ms telemetry timer inherited that
    rate. Non-blocking polling lets delay(1) set the loop rate.
    /wheel_ticks (Quaternion as four doubles: LF LR RF RR) publishes CUMULATIVE
    direction-corrected counts. This is the one that matters. /wheel_state carries
    instantaneous velocity, so every consumer must integrate and a dropped message
    loses that distance fore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
    [rover_firmware_v2.ino]
2026-08-15 camera: retry the emitter set — streaming does not mean the camera is ready
    Seen today: infra1 streaming at a healthy 30 Hz while every
    'ros2 param set depth_module.emitter_enabled false' returned 'timeout waiting
    for reply'. The D555 answers image traffic before it answers option traffic, so
    attaching the driver too soon after a power-cycle leaves the emitter stuck on
    with every other indicator green. That is the exact state in which a 60 cm push
    once read 1.1 cm, so it has to fail loudly rather than pass quietly.
    Retries for ~30 s and still refuses to continue if the read-back never comes
    back False. Also records the three distinct D555 failure modes in TODO 7 --
    no link, dead DDS serve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
2026-08-15 compare: flag a dead encoder side instead of printing its arithmetic
    Both LEFT encoders went dead today between two tests three hours apart. velL is
    0.5*(dLF+dLR) and wz is (velR-velL)/0.34, so a zeroed side does not produce an
    obviously broken row -- it produces a confident report of a turn that is not
    happening. That is worse than no row at all, because it looks like a real
    disagreement with cuVSLAM.
    Detection is deliberately asymmetric: one side moving while the other sits at a
    hard zero is a fault, both sides at zero is a parked rover. The warning appears
    live and again in the verdict, and says plainly that the gates do not depend on
    it -- FUSED takes distance from cuVSLAM and heading f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
2026-08-15 compare: tell speed apart from a featureless scene when tracking dies
    The 442 cm/s in the last run was not the operator pushing hard -- nobody hand
    pushes a rover at 4.4 m/s. vo_peak already skipped teleports, but only ones over
    15 cm, and at 30 Hz a 14.7 cm hop squeaks under that threshold and reports as
    442 cm/s. So the tool blamed speed and sent the fix in the wrong direction.
    Teleports are now caught by implied speed as well as size: over MAX_PUSH_MS
    (1 m/s) is the tracker re-initialising whatever the step size.
    The operator's own observation -- jumps happen near walls and while reversing --
    is the better lead, and it is measurable. compare now subscribes to /vo/status
    and records the l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
    [compare-20260815-074049.csv, compare-20260815-074339.csv]
2026-08-15 fuse every sensor for the job it is actually good at
    Requested: use all the sensor data so x, y, theta are right, since nav2 is built
    on top of that. Mostly yes -- but 'use everything' needs one correction, and the
    correction is the interesting part.
    heading gyro z stays primary; it beat cuVSLAM by 7.68 deg on a return leg.
    Now pulled onto cuVSLAM's heading with a ~30 s time constant, because
    gyro bias walks and cuVSLAM's heading does not drift (it is measured
    against the world afresh each frame). Slow enough that a teleport
    cannot yank it.
    distance taken from the ENCODERS when both sides are alive, with cuVSLAM
    supplying only the directi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
2026-08-15 compare: stop accusing a working encoder, and record the calibration finding
    The dead-side detector latched a boolean the instant either side reported
    motion first, and never cleared it. A right wheel that started a fraction of a
    second after the left was therefore reported dead for the whole run. It wrongly
    accused a perfectly good encoder on the 120 cm out-and-back, and the new tick
    log is what disproved it: RF moved 11781 counts and RR 14831 while the banner
    claimed RIGHT was silent.
    Now it counts samples instead. A side must stay silent through ~5 s of the
    other side's motion, and the accusation is withdrawn the moment it moves. This
    is the second time a latched flag has produced a conf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
    [compare-20260815-080814.csv]
2026-08-15 encoders are correctly calibrated; the 2x claim was a units error
    200 cm by tape, forward, straight:
    LF 11434 -> CPR 1526.6 RF 11623 -> CPR 1551.9
    LR 11378 -> CPR 1519.2 RR 11275 -> CPR 1505.4
    ENCODER_CPR 1560 is right within 3%, and all four wheels agree within 3%. No
    firmware change, no per-wheel constants.
    The earlier claim that they were 2x out with the rear reading 25% more than the
    front came from comparing cumulative counts -- which measure ARC LENGTH -- with
    cuVSLAM's straight-line displacement from the origin. On the 120 cm out-and-back
    the rover travelled far more path than its final displacement, and that gap got
    read as a calibration error. Both quantities we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
2026-08-15 gyro: track the bias continuously, and make the yaw filter actually filter
    A parked rover found two bugs that no moving test would have.
    1. The complementary filter never applied its correction. Written as
    fused_yaw = gyro_yaw + (vo_yaw - gyro_yaw) * k
    it recomputes from gyro_yaw every message, so the result is always 99.9%
    gyro no matter how long it runs -- the correction cannot accumulate. Parked
    107 s, cuVSLAM held +0.01 deg, the gyro walked to -9.52, and FUSED faithfully
    reported -9.51. Now the gyro's STEP is integrated onto the filter's own
    previous value, and that is what gets pulled toward cuVSLAM.
    2. Gyro bias is not constant. Three runs today measured +0.0838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
    [compare-20260815-082243.csv]
2026-08-15 PHASE1.md — the sensors, the techniques, the numbers, the commands
    Written because Phase 1's real output is not the code, it is what we now know
    about this rig: which sensor is good at what, which numbers were measured rather
    than assumed, and which faults produce green indicators while lying.
    Records the reasoning, not just the results -- why depth is deliberately unused
    (it is derived from the same stereo pair cuVSLAM consumes, so it is not an
    independent witness), why the accelerometer is never integrated for position
    (error grows as t^2, 180 m in a minute) but is the only drift-free attitude
    reference on the vehicle, and why the sources are displayed separately (a single
    fused number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
    [compare-20260815-082903.csv, compare-20260815-083252.csv, compare-20260815-083354.csv]
2026-08-21 teleop proven: the command path works end to end
    Phone -> Pi 5 web -> /cmd_vel -> WiFi -> ESP32 -> PID -> BTS7960 -> motors, the
    one path Phase 1 had never exercised. Everything until now was sensing; this is
    the first time the rover moved under its own power, and it is the same path nav2
    will use.
    Commanded 0.200 m/s, measured 0.197 from the ENCODERS (not echoed from the
    command, so it is real evidence the wheels turned). Balance 1.00 between sides,
    which also confirms L_MOTOR_DIR and R_MOTOR_DIR: a wrong sign there would have
    pivoted instead of driving straight. Release decays 0.197 -> 0.043 -> 0.004, a
    coast rather than a brake, as driveSide intends.
    logs/watch_teleop.py prints the two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
    [compare-20260815-085524.csv]
2026-08-21 fuse distance from totals, not a per-step ratio that could only inflate
    The first driven out-and-back caught this: FUSED landed 6.9 cm from the start
    against cuVSLAM's 2.2 cm, with a path of 313 cm against cuVSLAM's 244 and the
    wheels' own 254. Fusion made the answer worse than either input, which fusion
    must never do.
    The per-step ratio was the fault. w.path accumulates in 5 mm chords while
    vo_step is smooth per-frame, so gained/vo_step was lumpy -- often exactly 0,
    sometimes ~2x. The 0.5-2.0 sanity band then behaved perversely: a 0 ratio fell
    BELOW it and was rejected, keeping the full cuVSLAM step, while a large ratio
    passed and was applied. Every accepted correction made the step longer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
    [compare-20260821-160505.csv]
2026-08-21 carry the fused pose through a cuVSLAM teleport instead of freezing
    Refusing the false step was only half the job. When the tracker lost itself,
    _fuse was skipped entirely, so FUSED ignored the bogus 2 m hop -- correct -- and
    also lost whatever REAL travel happened in that frame, permanently. That missing
    distance never comes back, and it is why an endpoint stayed wrong after a jumpy
    run even though the jump itself was rejected.
    The encoders and the gyro did not fail. Encoders measure distance at the axles
    and a gyro measures rotation from angular momentum; neither cares what the
    camera can see. So FUSED now dead-reckons on those two through the outage.
    Direction of travel comes from the SI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
    [compare-20260821-160917.csv, compare-20260821-161524.csv, compare-20260821-161604.csv]
2026-08-21 make the three sensors cover for each other in every direction, not one
    Asked for: if one breaks, the others carry it. What existed only covered a
    single case, and the audit found the gap immediately -- both _fuse and
    _deadreckon were called from _vo, so cuVSLAM was still the heartbeat. A teleport
    was handled because a message still arrived; cuVSLAM going SILENT was not
    handled at all, and the fused pose simply froze while the wheels and gyro were
    perfectly healthy. Verified by killing vo_node mid-run: FUSED went stale and
    displayed "no publisher".
    FUSED now has its own 20 Hz pulse, independent of any one sensor:
    cuvslam dies -> wheels + gyro dead-reckon (watchdog, 220 frames covered i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
    [compare-20260821-162121.csv]
2026-08-21 heading belongs to the gyro; wheels need a skid-steer track width
    A hand-set 90 degree turn measured all three against a known truth for the first
    time:
    gyro 89.80 deg -0.2%
    cuvslam 99.85 deg +11%
    wheels 146.49 deg +63%
    FUSED 94.11 deg +4.6%
    Two independent faults.
    WHEELS. wz was computed as (velR - velL) / 0.34, the physical track. That is the
    differential-drive formula and this rover is four-wheel SKID-STEER: it has no
    steering, so turning drags all four tyres sideways. The geometry converting a
    speed difference into a yaw rate is an effective width that includes the scrub,
    and it is always larger than the physical track. Measured ratio 146.49/89.80 =
    1.63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
    [compare-20260821-163727.csv]
2026-08-21 calibrate the skid-steer track width from a 360, not a single 90
    turn wheels read truth ratio implied width
    90 deg 146.49 90 1.631 0.5546 m
    360 deg 556.49 360 1.546 0.5256 m
    Takes the 360: four times the signal, and returning to the same floor line is
    far easier to judge than eyeballing a right angle. The 5.4% spread between the
    two is not error to be explained away -- scrub varies with turn rate, tyre
    loading and floor, so this is a good average rather than a physical constant,
    and the comment now says so.
    The operator noted the rover did not pivot about its centre and "all wheels not
    in sync", which sounds like it should inv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
2026-08-21 three rotation runs, and guard the crash that ate one of them
    turn wheels read truth ratio width peak rate
    90 left 146.49 90 1.628 0.5534 -
    360 left 556.49 360 1.546 0.5256 21.4 deg/s
    360 left 548.34 360 1.523 0.5179 76.2 deg/s
    The two 360s agree to 1.5%, so the constant is their mean: 0.5217 m.
    Worth reading the last two columns together -- the faster turn over-read LESS.
    Scrub is not a fixed property of the chassis, it varies with turn rate, tyre
    loading and floor, which is why this is documented as a calibrated average with
    a note to re-measure on carpet rather than as a physical dimension.
    The th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
2026-08-21 scrub measured: the wheels only agree with each other in a straight line
    Per-wheel counts through a 360 deg pivot, for two wheels on the same side --
    bolted to the same chassis, driven by the same BTS7960, and therefore
    mechanically obliged to sweep the same arc:
    LEFT front/rear RIGHT front/rear
    straight 1.00x 1.03x
    turning 1.60x 1.29x
    Straight they agree almost exactly. Turning, the front wheels travel up to 60%
    further, so the rear are being dragged. That is skid-steer scrub, and it means
    encoder distance is an excellent reference in a straight line and a poor one
    mid-turn.
    So the encoder/cuVSLAM scale calibration is now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
2026-08-21 fourth 360 confirms the track width to 0.2%, and the scrub repeats
    360 left 551.49 deg ratio 1.532 implied 0.5209 m
    Against a constant of 0.5219 set from the previous three, that is 0.2% off.
    Four runs now span 1.5%; the mean is 0.5216.
    The more interesting number is the slip repeating almost exactly:
    LEFT 37.6% -> 37.5%
    RIGHT 22.5% -> 23.0%
    Half a percent between consecutive runs. So the front wheels out-travelling the
    rear is a deterministic property of this chassis and its loading, not random
    slip -- the rover pivots about a point behind its geometric centre and does so
    consistently. That is what makes freezing the encoder calibration through turns
    the right r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
2026-08-21 drop cuVSLAM outright when it is blind, and make dead reckoning actually run
    A hard drive with many turns broke everything and exposed two bugs that the
    gentle runs never would have. 32 teleports, landmarks bottoming at 4 against a
    healthy 100-200, and the endpoint told the story:
    wheels 17.4 cm <- best answer
    FUSED 42.4 cm <- worse than its own worst input
    cuvslam 4595.9 cm
    FUSED doing worse than the wheels alone is the whole thing failing at its
    purpose, and it did so for two reasons.
    First, dead reckoning never fired: "carried 0 frames (0.0 cm)" through 32
    teleports. It measured travel as w.path - anchor, and Source.path accumulates in
    5 mm chords, so at 30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
    [compare-20260821-170211.csv, compare-20260821-170451.csv, compare-20260821-170753.csv]
2026-08-21 FUSED beats both its inputs under failure: 4.9 cm through 12 teleports
    Driven hard under teleop -- repeated lefts, rights, forwards, reverses, in a room
    with little for the camera to see. cuVSLAM lost tracking 12 times and landmarks
    fell to 17 against a healthy 100-200.
    cuvslam 79.6 cm heading +6.98
    wheels 55.7 cm heading -31.51
    gyro - heading +1.71
    FUSED 4.9 cm heading +1.75 PASS
    16x better than cuVSLAM, 11x better than the wheels, and the heading landed on
    the gyro's, which was the only one worth having. The same test one commit
    earlier gave 42.4 cm and FAILED -- worse than the wheels alone.
    Both new mechanisms are visible in the run: cu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
    [compare-20260821-171018.csv]
2026-08-21 360 spin passes: FUSED 3.68 deg. Phase 1 gates are complete.
    wheels 348.65 deg error -11.35
    gyro 363.57 deg error +3.57
    cuvslam 371.15 deg error +11.15 FAIL
    FUSED 363.68 deg error +3.68 PASS
    cuVSLAM failing is expected and is why the gate exists -- rotation is visual
    odometry's weakest case, and a pivot swings this camera past its tracking limit.
    The wheels reading 3.2% off is the skid-steer calibration paying off; before the
    effective track width was measured they were 63% wrong.
    Headings wrap to +/-180, which made this test unreadable: every source correctly
    reports "about 0" after a full turn, and that is indistinguishable from not
    having moved. S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
    [compare-20260821-171305.csv, compare-20260821-171434.csv, compare-20260821-171631.csv]
2026-08-21 PHASE1.md — the complete record: sensors, techniques, numbers, faults
    Rewritten as the definitive document now that the gates are complete. Phase 1's
    real output is not the code, it is what is now known about this rig: which sensor
    is good at what and by how much, which constants were measured rather than
    assumed, and which faults produce green indicators while lying.
    Keeps the reasoning, not just the results -- why depth is deliberately unused,
    why the accelerometer is never integrated for position but is the only
    drift-free attitude reference, why the sources are displayed separately, and why
    fusion is assignment plus fallback rather than averaging.
    The fault table is the part worth re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
2026-08-21 Phase 1b: publish the fused pose that nav2 will navigate on
    fusion.py is the algorithm with no ROS in it, extracted from compare.py
    programmatically rather than retyped -- the method bodies are the same source
    text, so the thing validated over two days of tape-measured runs is the thing
    that ships. compare.py grades it; fusion_node.py publishes it; they cannot
    drift apart into two implementations where only one was ever measured.
    fusion_node.py owns /odom and the TF odom -> base_link, and vo_node now runs
    with publish_tf:=false. Only one thing may publish a transform, and the raw
    cuVSLAM pose is the one that teleports: 12 of them in a single drive, one 651 cm
    in a frame, ending 79.6 cm from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
2026-08-21 Phase 1b verified: /odom agrees with the measured estimator to 0.6 cm
    Ran fusion_node and compare.py simultaneously and drove:
    /odom (fusion_node) 67.1 cm +90.60 deg
    compare FUSED 66.5 cm +91.07 deg
    difference 0.6 cm 0.47 deg
    Two separate instances with separate gyro-bias calibrations and separate start
    moments, so the residual is startup timing rather than a behavioural difference.
    The claim that fusion.py is compare.py's algorithm was about source text; this
    measures it.
    The run also shows what agreement looks like with nothing broken -- 179
    landmarks, no teleports, and all four headings within a degree of each other on
    a 90 deg turn (cuvs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
    [compare-20260821-175621.csv]
2026-08-21 docs: rewrite README, ARCHITECTURE and add OPERATIONS
    README and ARCHITECTURE still described the plan deleted in the clean slate --
    they referenced PRD.md and tasks/, and a stage numbering that no longer exists.
    Rewritten against what is actually built.
    README.md entry point, current status, and where to look
    ARCHITECTURE.md the system as built: machines, topics, frames, nodes, and
    why each decision went the way it did
    OPERATIONS.md new -- the runbook: bring-up, driving, gates, calibration,
    and troubleshooting organised BY SYMPTOM rather than by
    subsystem, because the symptoms on this rig are what mislead
    The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
2026-08-21 git: keep the diagnostic tools, drop the run artifacts
    logs/ holds two very different things. The *.py are diagnostic TOOLS -- the
    rotation calibration, the encoder check, the yaw-sign check, the teleop
    watcher -- and they are source. The rest is output: 22 run CSVs plus 17k lines
    of terminal capture, run.txt alone at 15,065 lines.
    Every claim the CSVs support is already written up in PHASE1.md with the numbers
    quoted, so keeping near-identical files to re-derive a table nobody will
    re-derive is bulk rather than evidence. They stay on disk; git add -f will
    preserve a specific run if one ever matters.
    [compare-20260814-195911.csv, compare-20260814-202854.csv, compare-20260814-205943.csv, compare-20260814-210538.csv, compare-20260814-210843.csv, compare-20260814-211111.csv, compare-20260814-211404.csv, compare-20260814-211428.csv]
2026-08-21 Phase 2a: the line it draws, and a laptop that can watch
    Two of the three things asked for, neither of which needs a map yet.
    /fusion/path publishes where the rover has been, so RViz draws the track as it
    drives. Appended in 2 cm CHORDS rather than per pulse: at 20 Hz a stationary
    rover would otherwise add 20 identical poses a second until the message is
    megabytes and RViz stutters. Capped at 5000 poses, about 100 m of travel.
    phase2/rviz/rover.rviz shows the fused pose with its covariance ellipse, the
    travelled line, and the frame tree -- plus the raw cuVSLAM pose on a layer that
    is OFF by default. Turning that on beside the fused one is the clearest
    demonstration there is of what Phase 1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
2026-08-21 record: a pivot command drives instead of turning
    Counter-rotating in 0% of samples. The left side tracks its target exactly
    (-0.34 commanded, -0.36 measured); the right side is commanded +0.34 and
    measures -0.30, so it is being dragged backward by the chassis rather than
    driving against it. The residual 0.06 m/s differential is why the gyro still
    reads ~7 deg/s -- the rover reverses along a slight curve, which is what
    'goes front/back even when I click right' actually is.
    Also records the theory this disproved, because it is separately true and will
    otherwise be rediscovered: the teleop was written for a firmware where wz is a
    PWM fraction, while this one reads it as rad/s, so WZ=2.0 asks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
2026-08-21 Phase 2b: nvblox builds the room on the fused pose
    Depth plus /odom become a TSDF and a 2D occupancy grid. Standing still it has
    already mapped 4.4 x 8.4 m at 5 cm voxels -- 1.63 m2 of floor and 1.77 m2 of
    obstacle, the rest unknown -- and it grows as the rover drives.
    global_frame is odom, not map. There is no map frame until something localizes
    against a saved map (2c), and pointing nvblox at a frame nothing publishes
    produces an empty map and a confusing hunt.
    Built on the FUSED pose deliberately. nvblox writes depth wherever the pose
    claims the robot is, so a cuVSLAM teleport smears geometry into the map
    permanently -- that is precisely what Phase 1 existed to stop reaching this node.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
2026-08-21 path: latch it, and publish on a timer rather than only when it moves
    /fusion/path only published when the pose had travelled 2 cm from the last
    anchor, which conflated two different questions. Appending is about travel --
    a parked rover must not grow the message. Publishing is about viewers, and a
    viewer needs the track whether or not the rover happens to be moving right now.
    The visible symptom: RViz showed nothing once the rover stopped, and an RViz
    started after a drive showed nothing at all. That reads as a broken publisher
    rather than a design choice about when to append.
    Now appended on travel as before, published at 2 Hz regardless, and TRANSIENT_LOCAL
    so a late subscriber gets the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
2026-08-21 correct the speed limit: teleports track texture, not velocity
    The teleop loop closed at 6.8 cm and 1.2 deg -- both gates pass -- at a peak of
    42 cm/s, well past the ~25 cm/s limit this repo had written down as fact, with
    ZERO teleports and 162 landmarks.
    Cross-tabulating every run makes the pattern plain:
    18.8 cm/s healthy landmarks 0 teleports
    42 cm/s 162 landmarks 0 teleports
    84 cm/s min 17 landmarks 12 teleports
    94 cm/s min 4 landmarks 32 teleports
    The original claim came from correlating teleports with peak speed across two
    runs. The correlation was real; the causation was not. Landmarks were the
    confound, and the two move together because a bar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
2026-08-21 Phase 3: nav2 plans and drives on the nvblox map
    global costmap 240x240 @ 5 cm lethal 1770 inflated 165
    local costmap 80x80 @ 5 cm lethal 1430 inflated 365
    footprint 0.18 front / -0.17 rear / +/-0.19 side
    Consumes what the earlier phases produce: /odom and the TF from fusion_node,
    the ESDF slice from nvblox via NvbloxCostmapLayer, and /cmd_vel out to the
    ESP32. No map server and no AMCL -- the frame is odom, so this navigates within
    one session rather than recognising a room tomorrow. That is 2c/2d.
    The footprint is derived from Phase 1's measurements rather than guessed: front
    is the camera face at 17.0 + 1 cm, rear is the rear wheel centre plus the wheel
    radi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
2026-08-21 rviz: a config the laptop can actually render
    The laptop has ROS 2 Jazzy but not nvblox_rviz_plugin, so the 3D mesh display
    could never have worked there. Rebuilt around standard message types only --
    every display now uses something any Jazzy install renders, and the 2D map is
    what nav2 plans on regardless.
    Shows the room, the driven track, nav2's plan, the fused pose with its
    covariance ellipse, and the real measured footprint. Costmaps and the raw
    cuVSLAM pose are present but off; turning the latter on beside the fused pose is
    the clearest demonstration there is of what Phase 1 bought.
    The QoS settings are the part worth keeping right. nvblox publishes VOLATILE and
    nav2's costmaps publi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
2026-08-21 document Phase 2 and 3: what was built, what it taught, what is untested
    PHASE2.md mapping -- the 2b/2d distinction, the frame chain, nvblox settings
    and why each one, the measured map growth, and the traps
    PHASE3.md navigation -- what each nav2 piece does and why it was chosen, the
    footprint derivation, and everything shaped by the pivot fault
    README, ARCHITECTURE and OPERATIONS updated to match: new phase status, the new
    topics with their durabilities, the new nodes and config files, the new
    commands, and troubleshooting for the map and for nav2.
    Three things the docs go out of their way to say plainly.
    WHAT IS NOT DONE. nav2 is running and no goal has been d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
2026-08-22 rviz: build the config from one rviz actually ships, not by hand
    The hand-written config produced a blank screen: no rover, no map, nothing --
    while the laptop was demonstrably receiving /odom at 19.8 Hz and the occupancy
    grid at 4.9 Hz. The data path was never the problem.
    The config was missing four keys the Visualization Manager requires -- Enabled,
    Name, Transformation and Value. RViz rejects a config it cannot parse and falls
    back to its DEFAULTS, and the default Fixed Frame is 'map'. There is no map
    frame on this rover until Phase 2c, so everything silently fails to transform
    and the screen stays empty with no error a user would notice.
    Now derived programmatically from nav2_bringup'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
2026-08-22 map: slice at the rover's height, so it can drive under a table
    Driving under a 29 cm table painted obstacles in every direction. The rover is
    22 cm tall and fits under it comfortably, but the ESDF slice ran from 10 cm to
    60 cm, so the tabletop was inside the obstacle band and the rover found itself
    surrounded by something it could pass beneath.
    The 2D map is a horizontal slice through nvblox's 3D model, and the band has to
    be set by what the ROVER COLLIDES WITH, not by how high the camera can see:
    0 - 10 cm skipped -- the camera pitches down 1.3 deg, so at 3 m the floor
    itself reads up to 6.8 cm high and becomes a phantom obstacle
    10 - 22 cm the obstacle band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
2026-08-22 map: stop nvblox forgetting the room it just mapped
    A full room loop ended with LESS map than it started with -- 8.74 m2 of floor
    down to 3.04 m2 -- while looking perfectly good locally the whole way round.
    nvblox had not restarted; it had deleted the earlier half of the loop.
    nvblox decays the TSDF by default. Each voxel's weight is multiplied by 0.95 at
    5 Hz and the block is DEALLOCATED once it falls low enough, which is a 2.7 second
    half-life:
    not seen for 3 s -> 50% weight
    10 s -> 7.7%
    30 s -> 0.05%, effectively erased
    A room loop takes minutes, so the far wall was gone before the rover returned to
    it. Locally the map always looked right, which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
2026-08-22 reject a diverged cuVSLAM: a ground rover cannot be 21 m underground
    A full room loop produced 62 m2 of "floor" spread over a 16 m blob with the walls
    in the middle, and the path said 37.4 m driven inside a 2.1 x 1.6 m box. Both are
    the same fault.
    cuVSLAM had jumped once and settled into a confident wrong pose:
    raw cuVSLAM x 16.9 y 1.0 z -21.70 frozen, not drifting
    gravity accel z +9.76 the rover is level, on the floor
    landmarks 95 healthy by every signal we had
    Landmarks are not sufficient to catch a diverged tracker. It was tracking
    features perfectly well; it was just tracking them from the wrong place.
    The damage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
2026-08-22 pivot: it was never wiring, it was 48 percent duty
    Lifted on blocks the wheels counter-rotate perfectly and symmetrically -- velL
    +0.411 against velR -0.407, and the mirror image on the other direction. So the
    wiring, R_MOTOR_DIR and the reverse PWM path are all correct; the electrical
    side does exactly what it is told. On the floor the same command counter-rotated
    in 0 percent of samples. That is traction, not code.
    The cause is a units mismatch in the teleop. rover_firmware_v2.ino reads wz as
    rad/s and computes each wheel as vx +/- wz * 0.34/2. The teleop was written for
    an earlier firmware where wz was a PWM FRACTION, and its own comment still
    claims WZ = 2.0 gives about 100 percent PWM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
2026-08-22 track the teleop in git: the WZ fix lived only on the Pi 5
    The turn-speed fix that unblocked mapping existed in exactly one place --
    ~/langrobo_teleop/teleop_web.py on 192.168.1.16 -- and would have been lost if
    that machine were reimaged. Copied in with a README explaining the units
    mismatch, so the reasoning survives with the number.
    The README leads with how the fault PRESENTED rather than what it was, because
    that is what made it expensive: not "turning is weak" but "the rover drives
    backward when told to turn". The wheels could not break four tyres loose
    sideways at 48 percent duty, so the small residual differential pushed the rover
    along a slight curve instead. It cost a whole mappin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
2026-08-22 docs: fold in today's findings, and repoint knowledge/ at code that exists
    Three techniques from today were in the code and in TODO but not in the
    documents anyone reads first.
    PLAUSIBILITY CHECKING. A sensor's own confidence signal cannot detect the
    failure where it is confidently wrong. cuVSLAM reported 95 landmarks -- healthy
    by every measure it exposes -- while claiming the rover was 21.7 m underground.
    Catching that needs an EXTERNAL constraint, and gravity is one that never
    drifts. Added to PHASE1 as a technique in its own right and to ARCHITECTURE's
    design rules, because it generalises well beyond this sensor.
    MAP DECAY. nvblox forgets by default, 2.7 second half-life, blocks deallo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
2026-08-22 loop closure: enable SLAM, and keep it out of the odom frame
    The reason SLAM was off has expired. vo_node's own docstring said it: with SLAM
    enabled the tracker quietly corrects drift at the moment you are trying to
    measure it. Phase 1 has its drift numbers now, so it is on by default; run
    SLAM=false ./rover pose to measure raw drift again.
    THE PART THAT MATTERS IS WHERE THE CORRECTION GOES.
    track() returns two poses per frame and we were discarding one. The ODOMETRY
    pose is continuous -- it drifts but never jumps, which is exactly what an odom
    frame must be and what the fusion's teleport rejection depends on. The SLAM pose
    is globally consistent but JUMPS whenever a loop closes.
    Publishi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
2026-08-22 pivot verified on the floor: 93 and 96 percent counter-rotating
    Against 0 percent before the WZ change. The rover pivots, peak 65 deg/s.
    It is working hard to do it: the wheels reach ~0.28 m/s of the 0.85 commanded
    and the body turns at ~65 deg/s against the ~290 that full duty gives unloaded,
    so scrub absorbs roughly two-thirds of the torque. Fine for driving, worth
    remembering before relaxing the NO-PIVOT settings in nav2 all at once.
2026-08-22 gate the SLAM correction too: a room loop is not 91 metres
    After a real room loop the map -> odom correction came out as
    [-10.5, -22.2, 87.7] m -- 87 metres straight up, a 91 m correction for a rover
    that had driven about four. The SLAM optimiser diverged exactly as the odometry
    pose once did, and planar_constraints did not prevent it.
    A correction is accumulated drift made visible. On a ground rover over a room
    that is centimetres to a metre or two; it is never tens of metres and never
    vertical. So the same plausibility test the odometry gets now guards the
    correction, and it is discarded rather than published.
    Worth noting what did NOT happen. odom -> base_link read [-0.828, 0.876, 0.000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
2026-08-22 map: integrate to 3 m, because the slice is only 12 cm tall
    A real room loop produced an 18 x 17 m blob with the walls scattered through the
    MIDDLE and none at the edges, claiming 150 m2 of free floor for a room nothing
    like that size. Both symptoms are one cause, and it is the interaction between
    two settings rather than either alone.
    The obstacle band is 12 cm tall -- 0.10 to 0.22 m, set to the rover's own height
    so it can drive under tables. Stereo depth error grows with range squared:
    2 m -> 1.9 cm well inside the band
    3 m -> 4.2 cm about a third of it, usable
    5 m -> 11.8 cm the ENTIRE band
    So a wall 5 m away has its points smeared vertically across the whole band.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
2026-08-22 loop_test: grade the estimate, not the parking
    This test printed FAIL whenever /odom did not finish within 10 cm of where it
    started. That grades the DRIVING. Nobody parks a rover back on a tape mark to
    10 cm by eye down a phone screen, so it reported failure on runs where the
    estimate was excellent and merely said so honestly.
    Measured today: /odom read 120.6 cm from the mark and the rover was physically
    about 100 cm away. The estimate was ~20 cm out over 12.9 m driven -- 1.6%,
    which is good stereo VO -- and the old verdict called it a failure twice in a
    row, sending us hunting for a regression that did not exist.
    The pose error is the DIFFERENCE between what odometry claims and what a ta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
2026-08-22 docs: write down today, and retire the 25 cm/s limit everywhere
    Three findings from the first pair of real room loops.
    TODO §15 -- the estimate has never actually been graded. loop_test printed FAIL
    whenever /odom did not finish within 10 cm of the mark, which grades the
    driving. Run 1 read 120.6 cm with the rover physically about 100 cm away: a
    ~20 cm estimate error over 12.9 m, or 1.6%, called a failure. Run 2's -22 deg
    heading error is the part still worth chasing and has no tape reading behind it.
    TODO §16 -- the SLAM pose diverged to 87 m above the floor and asked to correct
    the world by 91 m, with planar_constraints set. odom -> base_link stayed at
    z = 0.000 throughout, because the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
2026-08-22 rviz: draw the rover as a car, and a live view that opens on the right things
    The pose arrow says where the rover is and which way it points. It does not say
    how BIG it is, and on a map where the recurring question is "does it fit through
    there" the size is the thing you want to see. rover_marker.py publishes the real
    measured footprint -- deliberately the SAME numbers as nav2's costmap footprint,
    so the picture cannot quietly disagree with what the planner believes -- as a
    body with four wheels, a cyan nose, and a heading ray.
    The nose is a separate colour on purpose. Seen from directly above, a symmetric
    body is genuinely ambiguous about which end is the front, and "which way is it
    facing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
2026-08-22 the rover drives itself, and the controller no longer has to buy heading with motion
    First autonomous goal in the project: 1 m ahead, planned, driven, stopped 7.8 cm
    short against a 15 cm tolerance. Odometry read 95.8 cm of displacement and the
    tape said 93-95, which is also the first tape-confirmed pose reading since the
    loop tests.
    It got there badly. The rover overshot to 1.13 m, came back, and hunted around
    the goal for 13 seconds of a 6-second journey, crawling at 0.05 m/s while
    turning at the full 1.0 rad/s cap, ending 23 deg rotated and still commanding
    0.9 rad/s when nav2 declared success.
    Both causes were leftovers from the pivot fault. use_rotate_to_heading was false
    because the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
2026-08-22 cuVSLAM diverged a third time, and nothing said so for 55 minutes
    vo_z read -40.087 m -- forty metres underground -- with vo_implausible at 99394
    and climbing at ~30/s, dead_reckoned 3341, and 21.4 m travelled on dead
    reckoning alone. At that rate the counter represents about 55 minutes, and
    fusion_node had been up 57. It had been diverged for essentially the whole
    session, including both autonomous goal drives.
    The z gate did its job: the fused pose never followed cuVSLAM underground, and
    restarting vo_node recovered it completely (-40.087 -> -0.005, implausible
    steady at 0, 110 landmarks).
    The problem is that nothing surfaced it. The rover degraded to gyro-plus-wheels
    dead reckoning and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
2026-08-23 drive scripts refuse to run when something else owns /cmd_vel
    A 120 cm goal was driven while the teleop was still in MANUAL. In MANUAL it
    streams zeros at 10 Hz, and those zeros interleaved with nav2's commands and
    cancelled them: the rover limped to 101 cm, then stalled and sat there for 50
    seconds while nav2 believed it was still driving.
    The script had PRINTED a warning that /cmd_vel was active and driven anyway,
    which wasted the run. A warning you drive through is not a check, so both drive
    scripts now watch the topic for 3 s and abort with instructions rather than
    proceeding.
    Also xy_goal_tolerance 0.15 -> 0.05. 15 cm is a sensible navigation tolerance,
    but the checker fires the momen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
2026-08-23 wheel telemetry is at 20 Hz and has been for a while — nobody re-checked
    After today's power cycle /wheel_state came up at 20.004 Hz sustained over a
    369-sample window, /wheel_ticks at 20.5, /cmd_vel subscription count 1. Max
    inter-arrival 0.107 s, so it is genuinely sustained rather than the old
    1000.1 ms +/- 2.9 ms metronome.
    TODO 1 had this as a red blocker at 1.000 Hz. The firmware fix that stops
    rclc_executor_spin_some blocking landed some time ago -- rover.sh's keepalive
    comment already noted 20.3 Hz -- but the TODO entry was never revisited, so a
    resolved fault sat at the top of the list shaping decisions. The diagnosis is
    kept because the reasoning is the useful part.
    This unbloc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
2026-08-23 the obstacle band now covers the whole rover, and the footprint keeps a margin
    Three measurements from the floor today: the rover is 24 cm tall, the gate bar
    is at 29 cm, the camera sits at 18 cm.
    The band was 0.10-0.22 m, chosen as "the rover's height" before anyone measured
    it. The rover is 24 cm, so the top 2 cm of it was driving through space nothing
    checked -- an obstacle between 22 and 24 cm was invisible to the map and could
    still hit the body. Band is now 0.10-0.24, which is the principled setting: it
    should cover exactly what can strike the rover, no more and no less. Nothing
    above 24 cm can hit a 24 cm rover, and the 29 cm gate and 29 cm table both stay
    out of the map, which is wh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
2026-08-23 goto: check the destination, not just the route
    A goal of (1.20, 0.00) was accepted, driven at for 52 seconds, and abandoned
    42 cm short. The goal cell was INSCRIBED and every cell within 20 cm of it was
    blocked -- the rover was being asked to drive inside an obstacle.
    NavFn plans to within a tolerance of the goal, so it returns a perfectly good
    path when the goal is unreachable; the path simply stops short. The controller
    drives to the end of it, finds it is not inside xy_goal_tolerance, and tries
    again: approach, stall, back up, approach. That is the recovery behaviour doing
    exactly what it should, and from outside it looks like a controller fault.
    The script checked every cell on the RO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
2026-08-23 goto takes a heading: x y [theta], and reports how far off it finished
    The operator wants to hand the rover a pose from a camera -- "2, 3, 90" -- and
    have it arrive there facing that way. theta is now an optional third argument in
    degrees: absolute against the map (0 is +x, 90 is +y), or with --rel a turn
    relative to the current heading. Given no theta it holds the heading it started
    with, which is the least surprising default for "go there and stay pointed the
    way I am".
    Previously the goal orientation was hardcoded to the rover's starting
    orientation with no way to ask for anything else.
    The result block now separates two things that were being confused. It reports
    how far the ROUTE bulg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
2026-08-23 status tells you when the pose is lying, and caught it immediately
    ./rover status listed five topics and stopped at `wheels`. A command whose whole
    job is "what is alive" could not report fused, map, nav or the laptop view, so
    the answer to "is the stack up" was three fifths of the stack. It now covers
    every layer with the rate each one needs.
    More importantly it now checks whether cuVSLAM is TRACKING, which no rate can
    tell you. The divergence failure is silent by construction: the rover drops to
    gyro-plus-wheel dead reckoning while /odom holds 20 Hz, ready stays true,
    vo_alive stays true and every gate stays green.
    That check cannot be written with `ros2 topic echo /fusion/status --once`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
2026-08-23 cuvslam divergence: planar_constraints was never in the path, and it now recovers
    Four divergences (-21.7, +87.7, -40.1, +7.2 m) were attributed to
    planar_constraints failing to do its job. It was never doing that job.
    planar_constraints is a field of SlamConfig. The value that diverges, vo_z, is
    est.world_from_rig -- the ODOMETRY pose. The SLAM pose is used only for the
    map -> odom correction. Introspecting the installed API confirms OdometryConfig
    has no planar option at all: async_sba, max_frame_delta_s, multicam_mode,
    use_motion_model, use_denoising, use_gpu, rectified_stereo_camera. There is no
    setting that constrains the odometry to a plane, so this was never fixable the
    way three sess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
2026-08-23 turning is not movement: the progress checker was aborting legal manoeuvres
    A goal 1.12 m behind-left was refused after travelling 2.2 cm. Nothing was wrong
    with the goal. allow_reversing is false, so a goal behind the rover must be
    faced before it can be approached, and SimpleProgressChecker demanded 0.5 m of
    travel within 15 s while counting a turn as no progress at all.
    This chassis rotates at about 0.21 rad/s for the 1.0 rad/s it is commanded, so
    the 146 deg turn it needed took 12.1 s -- the allowance almost entirely spent
    standing still, legitimately, before a wheel had carried it anywhere. The goal
    was aborted mid-turn, a backup recovery ran, the behaviour tree exhausted itself
    and th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
2026-08-23 capture what lives on the other two machines
    The Pi 5's ros2_ws is its own repo and is fully pushed (dev-1.2.6, remote head
    matches local). But the teleop is NOT in it -- ~/langrobo_teleop is not a git
    repo at all, so the thing that is the rover's stop button was tracked only by
    the copy in this repo. teleop_web.py and run_teleop.sh already matched here by
    md5; langrobo-teleop.service did not exist here and now does, so the whole unit
    can be rebuilt: what runs it, as what user, and that Restart=always is what
    makes `pkill teleop_web.py` a safe way to restart it without sudo.
    The laptop holds no source of truth and now says so. Everything on it is a copy
    pushed from this repo, `./rover view`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
2026-08-23 bring the docs up to date with what the rover actually does now
    PHASE3 said "running, not yet driven to a goal" and documented
    allow_unknown: false. Both were wrong by the end of the day: goals of 1.00 m and
    1.20 m were planned and driven to within 4.9 cm and 3.6 cm, and allow_unknown had
    to become true because a forward-facing camera can never see the floor the rover
    is standing on -- so the rover's own cell stays unknown, NavFn cannot start a
    wavefront there, and every goal failed with free floor visible 20 cm ahead.
    Section 4 was "everything shaped by the rover not turning in place". It turns in
    place now, so it is rewritten around what actually shapes the config: a deadband
    below 0.8 ra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
2026-08-25 the rviz config was renamed and three docs never heard about it
    phase2/rviz/ has held rover_live.rviz and rover_live.sh since the laptop was
    reduced to a display, but ARCHITECTURE, OPERATIONS and phase2/LAPTOP all still
    pointed at rover.rviz. Following LAPTOP.md section 4 verbatim meant copying a
    file that does not exist.
    While there: LAPTOP.md described a copy-and-run flow the laptop no longer uses,
    and hand-rolled the docker exec that ./rover rviz already does. Both now say
    `bash ~/rover_live.sh`, and OPERATIONS records the failure that actually cost us
    tonight -- RViz started over ssh into a login screen renders into a void and
    exits 0.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
2026-08-25 the guard measured forward travel and called it height
    Two bugs, one mistake: judging a ground rover's pose by a z it cannot have.
    TODO 22. The divergence guard tested wfr.translation[2] -- OPTICAL z, read
    before the conjugation -- and base_from_optical maps optical +z to base +x. It
    was reading forward travel. Every ~50 cm driven tripped VO_MAX_Z_ODOM and
    re-created the tracker, and every rebuild reset the odom origin. 15 rebuilds in
    one session, the reported "z" clustering on +-0.50/0.51 with 197, 174 and 167
    landmarks, while the real base-frame height sat at 0.038 m throughout. The
    operator saw it as a return leg drawing a second line beside the first.
    Fixed by conjugating into base_lin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
2026-08-25 the spin gate, automated: rotate and ask all four yaw sources
    TODO 5 has never been run because it wanted a human rotating the rover by hand.
    It does not have to: a 360 deg turn is the one manoeuvre whose ground truth you
    know without measuring anything, so a powered spin grades gyro, cuvslam, fused
    and wheels at once, and they are independent enough that agreement means
    something.
    It also reports start-to-end displacement, because a pivot should end where it
    started. First run: fused held position to 1.4 cm while raw cuvslam claimed
    743 cm of translation -- rotation is where its translation goes wrong, which is
    consistent with TODO 4 and is a candidate explanation for the 291 rejected
    corr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
2026-09-03 the spin gate graded itself, and fusion trusted a witness gone quiet
    yaw_crosscheck.py stopped the powered spin when FUSED's own accumulated
    yaw hit the target, then graded fused against that same target -- circular
    by construction. Now it asks the operator what they actually observed and
    grades every source against that instead.
    Chasing the same test led to fusion.py's _still() check: it treats vo_speed
    as a live witness for "is the rover moving", but vo_speed is only updated on
    an accepted VO frame -- during a landmark dropout it just freezes at
    whatever it last read. A hand-rotated ~90 deg turn, with landmarks dipping
    throughout it, froze vo_speed near zero from before the turn started,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
2026-09-03 a map-framed twin of the path, so loop closure is visible instead of implied
    /fusion/path is stamped odom, and odom never gets corrected by definition --
    so a loop closure can take a 28 cm correction and the line in RViz does not
    move a pixel. That is not a rendering bug, it is what the frame means, but
    it made "the estimate corrected itself" unverifiable on screen.
    /fusion/path_map re-stamps each pose into map at the moment it was recorded,
    using whatever map -> odom correction existed then -- not re-transforming the
    whole path on every publish, which would just slide the track rigidly and
    hide the correction again. The two lines now separate exactly where and by
    how much a closure correct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
2026-09-03 start rover_marker.py, so RViz's Rover display actually shows a rover
    /rover/model has been what the Rover display in rover_live.rviz binds to
    since it was written, but no layer ever launched rover_marker.py -- so the
    display had been silently empty since 2026-08-26, and ./rover status has
    shown a permanent -- on the view row the whole time. Nothing was broken;
    nothing had ever been run.
    Started from the fused layer, because the marker is drawn in base_link and
    base_link is what fused begins publishing. Gated the same way as /odom.
    Claude-Session: https://claude.ai/code/session_01BxrgWECrjKDPceb2Yt4kFM
2026-09-03 the Jetson itself measured: power mode stuck one tier below Super, Docker owns 74% of used disk
    Cross-cutting look at what's on rakhi-jetson vs what the rover stack needs:
    nvpmodel at 15W with MAXN_SUPER unused (this board is the Super revision),
    23.6G of build cache from a dir whose own README says nothing's built from
    it, ~9.3G of rtabmap crash-recovery snapshots in ~/robot/data, and a second
    image tag (orin-nav:0.0.2) alongside the one actually run. Idle baseline
    (GPU 0%, ~5W) confirms current load is IDE/dev tooling, not perception.
    Claude-Session: https://claude.ai/code/session_01EmA3b7DhQuTGGkvDnA5u93
2026-09-06 color frames for the VLM plan, and what testing them found: nav2 works, wheels don't
    Enabled RGB on the D555 (424x240x15) so the Pi 5 can hand a frame to a VLM for
    "go to the red bottle" -> coordinates -> /goal_pose. Verified cuVSLAM, nvblox
    and nav2 are all unaffected by the extra stream, then published a goal to
    prove the other half: nav2 accepts it and drives correctly, but the fused
    (cuVSLAM-backed) pose never actually translated. The ESP32 has no active
    micro-ROS session -- /wheel_state is 0 Hz on both the Jetson and the Pi 5,
    a regression from the 20 Hz fixed 2026-08-23 (TODO #1). Logged as TODO #24;
    also #25 for a one-off planner_server segfault that self-recovered on retry.
    Co-Autho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
2026-09-06 power-cycle fixed the wheels, and the first autonomous drive since proved it
    Every device (Jetson, Pi 5, ESP32, D555) power-cycled together. Full bring-up
    came up clean, including the wheel link that TODO #24 found completely dead
    two sessions ago -- /wheel_state is back at ~20 Hz with no reflash needed, so
    the fix was power alone. Published a 0.7 m goal to confirm end to end: it
    stalled once (oscillating translation + unwanted yaw drift on a straight-line
    goal, no obstacle in nvblox's map, floor confirmed clear by hand), but a
    second attempt drove straight through -- Goal succeeded, no cuVSLAM
    divergence. Logged as TODO #26; #24 closed, #25 not reproduced on two more
    bring-ups.
    Co-Authored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
2026-09-06 every box answered, and the one thing that would stop you talking to it
    Checked all five: Jetson, Pi 5, Mac mini, ESP32 wheel link, D555. Rates
    measured live, nothing inferred from docs.
    Two things the docs had wrong or missing. The Mac mini is not idle - it is
    serving gemma-4-12B multimodal to the Pi 5's agent_node right now, reachable
    from both machines; PLAN.md:19 still calls it "vlm currently not active".
    And the frame_id="map" bug that pixel_to_goal.py's docstring warns would stop
    start_nav_to_pose working at all is already fixed on the Pi 5 side
    (ros2_bridge.py:597 = "odom"), so the VLM-to-nav2 path is not blocked.
    Voice is the actual gap: pi5_stt_node/pi5_tts_node are not running, s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
2026-09-06 voice is one powered-off speaker away, not a software problem
    Tried to start the Pi 5 voice stack. Everything software-side passed: the
    Jetson's voice role is stopped so there is no double-transcribe conflict,
    both Sarvam and Soniox keys are present, and the config reads clean.
    The speaker is the blocker. bluetoothctl connect returns
    br-connection-page-timeout and an 18s inquiry scan does not see the boAt
    Stone at all - it is off, out of range, or a phone is holding it. Checked
    for the documented wired fallback too: arecord -l lists no capture hardware
    and the only PipeWire sink is auto_null, so the Pi 5 currently has neither
    a microphone nor a speaker.
    Did not launch the nodes. bt_audio.e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
2026-09-06 phase 4: a VLM's picked pixel becomes a nav2 goal
    ./rover vlm is a real layer now, gated like every other one. Two nodes:
    image_bridge.py publishes the colour frame as JPEG on the topic the Pi 5's
    agent_node already subscribes to, and pixel_to_goal.py answers
    /vision/pixel_query with an odom-frame goal.
    pixel_to_goal is the half that did not exist. ROS2Bridge.ground_pixel() on
    the Pi 5 has been publishing into the void since it was written - nothing
    was listening on the other end. It reads aligned_depth_to_color rather than
    the raw depth stream, because colour and depth are different sensors with
    different intrinsics and a colour pixel does not index the same depth pixel;
    align_depth.enable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
2026-09-06 write down the vlm layer, and three things the fleet check turned up
    README and OPERATIONS gain ./rover vlm in the bring-up and its gate, so the
    runbook matches what the launcher does.
    PLAN's open question about the mac mini is answered: it is not "vlm
    currently not active" any more, it serves gemma-4-12B multimodal to the Pi
    5's brain from 192.168.1.6 and is reachable from both machines. Line 19
    itself is left exactly as written - that section is the original ask
    recorded verbatim and is not mine to rewrite.
    Three new TODO entries, all from measuring rather than reading:
    27, depth at 8.3 Hz against a 10 Hz gate. Nothing downstream is broken by
    it, but it is what pixel_to_goal reads to tu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
2026-09-06 the tf lookup that blocked the thread that fills the tf buffer
    Cross-repo read with pi5_ros2_ws. Three faults on this side.
    pixel_to_goal._on_query called lookup_transform with a 0.5s timeout from
    inside the executor callback — the same single thread the TransformListener
    needs in order to consume /tf. It could never succeed; it was a guaranteed
    0.5s stall in front of the same failure, on the one object-approach path that
    actually works on this rover. Latest-available now, matching the base_link
    lookup right below it that never had the timeout.
    image_bridge re-encoded 896x504 JPEGs at 5 Hz forever, subscribers or not, on
    a box at 96-99% GPU with 1.6 GB free, plus ~250-400 KB/s of wifi fo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
2026-09-06 the hardware reference moves next to the firmware it describes
    HARDWARE.md and the wiring PDF came from the pi5_ros2_ws repo, which had no
    business holding them: this repo owns the ESP32 firmware and FLASHING.md.
    That repo also carried two .ino files, and one was a rover_firmware_v2.ino
    157 lines SHORTER than the one here — an older v2 with no /reset_odom, no
    /wheel_ticks and no diag publisher. Two files with the same name and different
    contents is a flash-the-wrong-one waiting to happen; those copies are gone and
    phase1/firmware/ is now the only place the firmware lives.
    HARDWARE.md opened by calling itself the source of truth for flashing, which
    FLASHING.md already was. Now that they a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
2026-09-07 the disk audit called 5.3 G of RTAB-Map "live" — this rover runs cuVSLAM
    JETSON_LOAD.md's ~/robot/data table marked rtabmap.db as "live — keep" while
    listing the other 9 GB as crash residue. Nothing in ./rover starts RTAB-Map;
    the localiser is cuVSLAM, and RTAB-Map belongs to an earlier design that was
    never built here (the same phantom stack that got JETSON_D555_SETUP.md deleted
    from the pi5 repo).
    So that 5.3 G is very likely reclaimable too. I cannot re-measure the Jetson
    from here, so the entry now says what is verifiable — no launch path starts
    RTAB-Map — and tells the reader to re-check rather than asserting a number I
    have not confirmed.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
2026-09-09 the pose honesty check is a gate now, not a doc footnote
    Cold bring-up after everything was power-cycled. All eleven rows green,
    ESP32 came back on its own, cuVSLAM genuinely tracking.
    TODO 21 asked for the divergence to be made loud. status already ran
    health.py; the bring-up path did not, so the check existed only as an
    instruction to run it by hand after every start -- which is how a rover
    once drove 21 m on dead reckoning with every gate green.
    ./rover fused runs health.py in its gate and warns on divergence.
    It keeps going: the layer is up, it just cannot be trusted.
    ./rover map refuses outright. nvblox integrates depth at whatever pose
    it is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
2026-09-09 put vlm in the written bring-up order
    The skill listed camera->pose->fused->map->nav->view and stopped, so a
    by-the-book start left the brain able to answer questions but never see.
    Two other things in it had gone stale: it still said ./rover fused does
    not cover the cuVSLAM check, and it told you to check divergence with
    `ros2 topic echo /fusion/status --once` -- the exact command health.py's
    docstring says truncates that JSON, so a grep of it silently reads nothing.
    Also corrects the divergence count in the new code comment: TODO 21
    documents four occurrences, not five.
2026-09-09 write down how to start LangGraph Studio, and what it costs
    Nothing starts it at boot -- agent_node runs the graph in-process and
    needs no server -- so the whole procedure lived only in a session.
    The three things that cost time working it out are in there:
    * from ~/ros2_ws, with the full ~/.local/bin/langgraph path, because
    the CLI reads langgraph.json and .env from cwd and is not on a
    non-interactive ssh PATH;
    * ROS vars matched to agent_node's plain SUBNET discovery, since a
    stale ROS_DISCOVERY_SERVER yields a bridge that starts clean and
    silently sees no robot;
    * the tunnel is load-bearing, not convenience: Studio is HTTPS and a
    browser blocks it calling http: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
2026-09-09 compare.py can finally see the divergence it was built to catch
    TODO 21's last open bullet. compare is the instrument you actually watch
    during a push, and it subscribed to /vo/status -- which carries the
    landmark count but NOT vo_z, vo_implausible or dr_metres. Those are on
    /fusion/status. That is the whole reason the Phase 1 instrument stayed
    quiet through four divergences.
    It now reads both and prints a red banner live, and again in the verdict
    ABOVE the grade, latched so a run that diverged and then recovered is
    still not reported clean. A number measured against a diverged pose is
    not a bad measurement, it is a measurement of something else.
    VO_Z_LIMIT is defined once, at the same 0.3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
2026-09-09 STARTUP.md: power-on to a working dev environment, in one document
    Bring-up knowledge was spread across a skill, OPERATIONS 1, OPERATIONS 7
    and a session. Somebody coming back to a cold rig had to assemble it.
    STARTUP.md is that assembly: all five boxes rather than just the Jetson
    stack, the layer order, what to do PHYSICALLY when each one fails (the
    D555 needs its PoE unplugged, the ESP32 needs the rover power-cycled --
    neither has a software fix), the Pi 5 checks, and the Studio link as two
    steps, because the link alone silently does nothing without the tunnel.
    Ends with a "what all good looks like" block, so the answer to "is it
    working" is a comparison and not a judgement call.
    Every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
2026-09-09 version-control the Studio launcher, and say what a restart does not restore
    Two gaps in STARTUP.md, both found by asking whether following it
    actually reproduces the state it describes.
    start_studio.sh existed only on the Pi 5's SD card while two documents
    told you to run it, so a reflash would have left both pointing at a file
    nobody had a copy of. It now sits in phase4/pi5/ with the reasoning for
    each line, following the same convention phase1/teleop/ already used for
    the Pi 5's teleop. Verified identical to the live copy by md5.
    And a new section 8 answering the question honestly: the map and the odom
    origin do NOT come back -- nvblox builds in the odom frame and phase 2c
    is deferred,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
2026-09-09 the honesty gate cannot see a dead tracker, only a lying one
    ./rover status printed "ok — tracking, not dead reckoning" with no cuVSLAM
    node running at all, and ./rover map built on that pose without refusing.
    health.py reads vo_z, vo_implausible, dr_metres and landmarks. All four are
    last-known values that freeze when vo_node stops publishing, and dr_metres —
    the one that would move — stays 0.00 until the rover drives. So a stationary
    rover with a dead tracker reads identically to a healthy one, which is the
    state every bring-up is in.
    vo_alive would have caught it in 0.5 s. fusion.py:377 computes it correctly
    and fusion_node.py:348 serialises it into the very payload health.py alre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
2026-09-09 teach the honesty gate the difference between lying and being dead
    health.py now reads vo_alive, the one field that separates a dead tracker
    from a healthy one at a standstill. Checked BEFORE the divergence test: once
    cuVSLAM stops publishing, vo_z and vo_implausible are frozen values, and
    testing them first reports the wrong fault.
    Sampled across the window rather than once, because vo genuinely drops out
    for ~1 s under load (TODO 31) and that is a flicker, not a death:
    all false ✗ NOT RUNNING, rc 1
    some false ok + a dropout warning pointing at TODO 31, rc 0
    all true ok
    absent ok + a note that this fusion_node cannot report it
    Both gates already propagated the exit c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
2026-09-09 the latched divergence line argued against itself
    compare.py latches a divergence on purpose: a push that diverged is not
    clean, however good the tracker looks by the time you read the verdict.
    But _divergence_lines() printed the LIVE fields next to that latched
    verdict, so once cuVSLAM was reset the red line refuted itself --
    ✗ cuVSLAM DIVERGED — vo_z +0.01 m, 0 poses rejected, 0.00 m dead reckoned.
    a z well inside the 0.30 m limit, next to a claim of divergence. That is
    a warning a reader talks themselves out of, which is exactly what the
    latch existed to prevent.
    vo_z and vo_implausible are now snapshotted when the latch first trips
    and quoted from there once it has recovered, wi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
2026-09-09 the detector was not missing, it was stranded in the old project
    TODO 32 says four things the Pi 5 brain asks for have "no code anywhere in
    this repo". For the two vision seams that was true of this repo and false of
    this machine: orin-nav-stack/nodes/detections_3d.py — 459 lines, YOLOv8n +
    D555 depth + TF, already speaking all three vision topics — was left behind
    when the layered stack was built. A July-dated /tmp/detections_3d.log inside
    the container was the clue.
    Ported to phase4/nodes/detections_3d.py, wired in as ./rover detect. Nearly
    all the adaptation was configuration, because the node was parameterised:
    target_frame map -> odom, because ros2_bridge.NAV_FRAME is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
2026-09-09 say which brain ./rover detect is actually for
    I added detect to the bring-up order as though every brain wanted it. The
    Pi 5's dev-1.3.0-minimal branch deletes world_model, on_detections and the
    five tools detect feeds -- that cut keeps vision on look() plus the VLM
    approach path, which is the one object-approach path that has ever worked
    here. On that branch /vision/detections_3d has no subscriber and detect
    spends GPU for nobody.
    The Subscription count: 2 I measured was the OLD brain: the Pi 5 is still
    running its dev-1.2.8-refactor-test build, which does have on_detections.
    The layer is right; the claim that it is unconditional was not.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
2026-09-09 the wheel link came back on its own, so stop reaching for the board
    Three things this bring-up taught, all of which cost time to rediscover.
    The ESP32 linked healthy, decayed across ~45 s (15.9 -> 14.8 -> 11.3 Hz,
    max gap 0.732 s), died to publishers 0 / cmd_vel subs 0, and then came
    back to a steady 20.0 Hz with no power-cycle and no intervention. That is
    NOT the documented firmware-retry fault, which leaves a dead link dead --
    so the standing advice to power-cycle on sight is wrong here, and would
    have "fixed" something already recovering while destroying the evidence.
    The replacement advice is to re-check after the last layer is up and
    again before driving, because the window is silent i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
2026-09-09 pixel_to_goal knew where the object was and only said where to park
    ground_pixel's reply carried "goal", which is compute_standoff_goal's
    output -- deliberately _STANDOFF_M (0.45 m) short of the object so nav2
    parks in front of it rather than inside it. That is right for driving and
    wrong for answering, and (ox, oy), the object's actual odom position, was
    computed two lines earlier and thrown away.
    So anything wanting to say "the chair is 1.4 m away" had exactly one
    number available and it was short by 0.45 m -- in a way that looks
    entirely plausible, which is the bad kind of wrong. Measured live: object
    (-0.142, -0.676) vs goal (0.255, -0.463), gap 0.451 m.
    Adds two fields, both additive,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
2026-09-09 the micro-ROS agent is on the Pi 5, which changes what to suspect
    TODO 33 told the next person to capture /tmp/micro_ros_agent.log without
    saying where it lives, and guessed at Jetson DDS load as the cause. Found
    while looking at something else: the agent is langrobo-microros.service on
    the Pi 5 -- "ESP32 WiFi UDP bridge". So the log is journalctl on the Pi 5,
    and the link is ESP32 -> Pi 5 over WiFi UDP, with /wheel_state only
    reaching the Jetson afterwards over the discovery server.
    A WiFi dropout on the Pi 5 side produces exactly the decay-then-recover
    signature that was measured, and has nothing to do with Jetson DDS load or
    /cmd_vel publisher count. Promoted to first hypothesis; the pub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
2026-09-09 Studio was answering the Telegram messages, and reporting to nobody
    Two sessions went into a navigation that "never said it arrived". It said
    it. It said it to /studio_bridge.
    Studio is not a passive viewer: its process runs the same graph, polls the
    same Telegram bot, and raises its own ROS node beside /agent_node, both
    publishing /cmd_vel. Left running from §6 -- which this repo's own
    rover-start flow ends by starting -- it picked up the user's Telegram
    request and ran the navigation itself:
    [studio_bridge]: nav done: success=False listener=NONE
    msg="Navigation to 'near the white bucket' failed ..."
    listener=NONE is the entire bug. Only agent_node registers a nav-d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
2026-09-09 record the navigation failure itself, which is still not fixed
    Today fixed being told what happened. It did not fix what happened. Three
    approaches to a bucket 1.6 m away, none arrived, and the two logged runs
    failed in different places -- one in the controller after three backup
    recoveries, one in the planner with no movement at all.
    Writes both traces down while they are still exact, along with the
    hypothesis worth testing first: nav2 has rotate-to-heading and spin
    recovery disabled because this rover reportedly cannot turn in place, but
    teleop's left/right pivot it by counter-rotating the wheels. If that is
    true the config is a stale assumption and it explains the controller run
    precisel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
2026-09-10 the laptop was logged in; the check was looking for the wrong thing
    ./rover view ended a clean bring-up with "nobody is logged in at the laptop
    desktop" at a laptop that was logged in, at its own screen. Re-running changed
    nothing, and the advice it prints could not have fixed it.
    It decided that from `pgrep -a Xwayland`. GNOME starts Xwayland ON DEMAND, so a
    session where nothing has spoken X11 yet has no such process -- not because
    there is no session, but because nothing has asked. loginctl showed an active
    wayland session on seat0 the whole time, and mutter's Xwayland auth cookie was
    already waiting in /run/user/1000 from login.
    Keep Xwayland as the preferred source of the display numb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
2026-09-10 note down the approach path's improvements, in the order to do them
    Read the "go near the chair" path end to end across both repos -- the Pi 5's
    langrobo_core/langrobo_ros and the Jetson's phase4 -- and wrote down what came
    out of it. Not prompted by a failure; prompted by nobody having read the whole
    thing in one sitting before.
    Thirteen items, ordered as a series rather than by where they were found:
    measure first (can this chassis actually pivot?), then the two suspected halves
    of TODO 34, then the VLM downscale that makes everything after it affordable,
    then the holes that produce a confidently wrong answer instead of an error,
    then architecture, then cleanup.
    The ones that are new rat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
2026-09-10 leave a note for whoever comes back, including me
    Powered down for a break. Todays_Todo.md now opens with what actually changed
    today rather than making the next session re-derive it.
    Three things worth not forgetting. The rotation fix is written to brain.env on
    the Pi 5 but has never run, and the restart it needs was blocked on a password
    -- except the power cycle does it for free, since a cold boot reads
    EnvironmentFile on start. TODO 33 got much worse and now outranks the whole
    list: the wheel link dies under driving load, so no motion measurement here is
    trustworthy without checking wheel_state continuity over the same window. And
    item 1 is largely answered -- this rover CAN pivot, clea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
2026-09-10 the turn fix works; what is left is spin-down, not calibration
    Verified end to end through the real brain rather than by driving /cmd_vel
    myself: publish to /voice/user_input, record /cmd_vel and /gyro/base, and read
    the angle the MODEL asked for off the length of the twist window.
    360 -> 357.0 deg (was ~86)
    180 -> 202.0 deg (was ~43)
    90 -> 114.3 deg (was ~21)
    90 -> 83.6 deg (repeat)
    wheel_state was continuous through every window, max gap 0.11-0.16s, so none of
    it is 33 dropout. The 4.2x systematic error is gone.
    The report of "still only ~90" was against the un-fixed brain: the process
    serving it started before brain.env existed, and the journal shows zero user
    turns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
2026-09-10 two processes run this graph, and only one had the calibration
    The turn fix verified at 360 -> 357 deg through agent_node, and the next report
    was "still half rotations" -- from a Studio thread. Both true. brain.env is
    loaded by systemd for langrobo-brain.service via EnvironmentFile, and Studio is
    not started by systemd, so it ran the same graph with _STEADY_STATE_ANGULAR_VEL
    back at the commanded 5.0. /proc/<studio pid>/environ had no LANGROBO_ vars at
    all. Same rover, minutes apart, 357 degrees one way and about 86 the other.
    Fixed in start_studio.sh on the Pi 5 (1dbac6e), copy synced here. It now sources
    brain.env and says so, and warns when the file is missing -- "no calibration"
    must n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
2026-09-10 note what the power cycle applies by itself, and what it does not
    A cold boot restarts agent_node, so both the calibration and the stale-view fix
    go live for Telegram and voice with no password step. Studio does not start at
    boot and must be told the calibration loaded -- if that line is missing from its
    log it is uncalibrated, and any motion test through it is invalid.
    Claude-Session: https://claude.ai/code/session_01WaBBZBx5XuiUbvQnm5aw9J
2026-09-10 the label said "current" and nothing ever expired it
    The report was "ask what you see, move, ask again, it answers from the old
    picture" -- which is Todays_Todo item 14, marked done at 14:17 today. It is not
    done, and there are two separate reasons.
    FIRST, the fix has never executed. langrobo_core is an editable install, so the
    source on disk is right and looks live, but Python imports at process start. The
    agent_node that could have served the failing test started 13:20:01, 57 minutes
    before the commit. The current one (boot 0, after the 14:33 reboot) does carry
    it and has served zero turns -- the journal has nothing but the startup cache
    warm. Third time this trap has been hit; the rotati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
2026-09-10 built it: the stamps are in, the measurement is not
    Pi 5 4988fe8. look() now stamps its frame with the pose it was taken from,
    every user turn carries where the robot is now and how far that is from the
    frame, and LOCAL_AGENT_PROMPT stopped telling the model not to look again.
    196 tests, up from 184.
    Records the four edges that cost something to find -- wrapping headings, the
    label and the stamp having to print the same convention, a pure pivot moving
    zero metres, and TF loss having to read as unknown rather than unmoved -- and
    the two facts that will otherwise be re-derived: both packages are
    symlink-installed so no colcon build is needed, and the 48-message cap counts
    messages, which is w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
2026-09-10 the sticky agent never handed off, so the stamps never got read
    A pasted transcript showed the real failure: with navigate sticky from an
    earlier move, "what are you looking at" was answered directly, three times,
    with no look() call and no handover. local_agent -- the only agent with a
    camera tool -- was never entered. Both prompts already say to hand this off;
    the 12B model ignored them.
    Fixed on the Pi 5 (1de1e9e): a code-level backstop in graph/build.py, matched
    against the user's own words rather than the model's reply, forces the chain
    to local_agent when a non-vision agent is about to answer a vision question
    instead of handing off. 209 tests, up from 196.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
2026-09-10 Add ./rover up (single-command bring-up) and stamp the odom origin epoch
    ./rover up chains camera->pose->fused->map->nav->vlm, then checks the ESP32
    link and the Pi 5 (teleop/agent_node/AUTO), starts LangGraph Studio, and
    brings up laptop RViz -- the exact sequence a manual bring-up already
    followed, now one command. --voice also brings up Pi 5 STT/TTS and
    reconnects the boAt Stone 650. STARTUP.md points at it.
    fusion.py's health() (-> /fusion/status) now reports origin_epoch, a marker
    unique to the current odom origin (set once, at construction). The Pi 5
    brain uses this to stop serving a saved named location once the odom origin
    it was measured under is gone -- a restart or a cuVSLAM dive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
2026-09-10 Log TODO 37: rotation-induced x,y drift report, unverified
    Reported informally (not from a graded --spin/--return/--expect run, no
    confirmed physical motion), so no ground truth exists yet to call any
    sensor's reading an error against. Documents the existing PASS baseline
    (README.md: 3.68 deg spin error, 2.5-4.9cm drift) that the report
    contradicts, why "wheels look correct" is backwards on a skid-steer rig,
    the test protocol to actually verify it, and fix/sensor candidates ranked
    by cost (re-measure cam_x/cam_y first, LiDAR scan-matching only as a last
    resort) -- IR rangefinders ruled out as the wrong tool for this problem.
    Claude-Ses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
2026-09-11 Fix ./rover --voice never starting voice, and add ./rover voice
    Three bugs, each hiding the next:
    The "already running?" probe used `pgrep -af "stt_node|tts_node"`, which
    matched the ssh command line carrying the pattern. It therefore always
    reported voice as already up, so `up --voice` never started anything.
    Bracketed the pattern.
    Fixing that exposed `set -e` killing the script: pgrep exits 1 when it
    matches nothing, and the old always-matching probe had masked it. Guarded
    the command substitutions.
    The launch ssh then hung indefinitely — the started process keeps the
    channel's fds open even under setsid+nohup — which is also why a plain
    `./rover up` stalled at the Studio step. Both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
2026-09-11 Let nav2 use doorways, and give it a recovery that turns
    Two symptoms, reported by the user: the rover stops dead at narrow places it
    physically fits through, and facing a wall with the goal behind it, it never
    tries to rotate out. This is TODO 40, and it explains TODO 34's two runs.
    Three compounding causes:
    footprint_padding 0.07 set the inscribed radius to 0.24 m, and that radius is a
    hard gate in NavFn, InflationLayer and RPP's collision sweep at once. The gate
    is the 0.170 m rear overhang, not the 0.190 m half-width, so the planner refused
    every gap under 0.48 m on a rover 0.38 m wide -- the 0.38-0.53 m band is most
    interior doorways. Now 0.03: 0.40 m gaps, 1 cm/side of margin. 0.02 i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
2026-09-11 TODO 40: the sweep that justified Spin's speed read yaw only
    Test 2 said "confirm Spin actually rotates". That is the wrong bar. The wz
    sweep in nav2.yaml read yaw rate off /odom, and yaw rate cannot tell a pivot
    from an arc -- so it cannot support the claim that 1.5 rad/s turns this chassis.
    teleop_web.py measured the day before that wz 2.0 is ~47% duty and cannot break
    the tyres loose, and TODO 14 put a real pivot at ~93% duty (wz ~4.7). Spin is
    capped at 1.5, about 25% duty per wheel.
    If that is right, nav2 has only ever curved, and a Spin that translates while
    turning is worse than no Spin in the gaps TODO 40 is trying to fit through --
    and is a candidate cause of TODO 37 and TODO 36.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
2026-09-14 Audit both machines as one system, ahead of an item-by-item interview
    Cross-checked Jetson and Pi 5 docs against current code and recent commits
    over SSH: found the two repos' own gap-tracking docs have drifted from each
    other again (INTEGRATION_GAPS.md §1 still says open what Jetson TODO §32
    closed 5 days earlier), and that the detections_3d fix is verified but not
    actually wired into ./rover up. Surfaces one priority question — whether
    Nav2 pivots or curves at 1.5 rad/s — that three separate open items (TODO
    §37, §40, INTEGRATION_GAPS §3) all reduce to.
    Claude-Session: https://claude.ai/code/session_017Pv4zk7svzo98x8ow4ByCY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
2026-09-14 TODO 41: a live Spin test found one wheel side may not be turning
    Ran the pure-rotation-through-Nav2 test §40 item 2 and §37 both called for
    (logs/spin_via_nav2.py, uses the actual /spin action, not raw /cmd_vel like
    yaw_crosscheck.py). Two runs at different angular caps both failed to
    pivot, and the higher-speed run covered LESS ground than the lower one --
    ruling out "just needs more angular authority" as sufficient on its own.
    The operator then watched a manual pivot directly and saw only one side's
    wheels turn. logs/wheel_log.py's first capture is consistent (LEFT flat at
    0.000 m/s while RIGHT showed real values) but too short to confirm. Config
    changes made while chasing the angular-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
2026-09-14 Revert this session's audit and Spin-test findings, at user's request
    Reverts aab290c (TODO 41: wheel-side finding) and 2e5b43d (system audit).
    Removes SYSTEM_AUDIT_2026-09-14.md, logs/spin_via_nav2.py, logs/wheel_log.py,
    and the TODO 41 entry.
    Claude-Session: https://claude.ai/code/session_017Pv4zk7svzo98x8ow4ByCY
2026-09-14 Fix double space in yaw_crosscheck.py's docstring comment
    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
2026-09-22 Add the RPLidar C1 as a layer, and measure its yaw rather than guess it
    The rover's pose stack was pure dead reckoning: gyro heading, wheel distance
    and cuVSLAM direction all estimate MOTION, and none can look at the room and
    correct accumulated error. That is why returning to 0,0,0 does not land where
    it started, and why pivots shift x,y. A lidar is the sensor that fixes it,
    because walls do not move.
    ./rover lidar RPLidar C1 -> /scan at 10 Hz, + the base_link -> laser TF
    ./rover slam slam_toolbox -> map -> odom + /map (the correction itself)
    The driver is compiled, not a script, so lidar/build.sh clones a pinned
    sllidar_ros2 and builds it INSIDE the image with the workspace bind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
2026-09-22 ./rover pose killed the lidar's TF, and every gate stayed green
    `./rover pose` published its own base_link -> camera0_link behind
    `kill_match "[s]tatic_transform_publisher"` -- a match on the BINARY, so it
    killed every static transform publisher in the container, including the
    lidar's base_link -> laser.
    `./rover up` runs lidar BEFORE pose. So a full bring-up destroyed the laser
    frame every single time, and nothing said so: the driver publishes /scan
    whether or not the TF exists, so `./rover lidar`'s 10 Hz gate passed, the
    four direction readings printed fine, and `./rover status` showed the lidar
    row healthy. The only symptom was RViz drawing no ring -- and slam_toolbox
    would have had noth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
2026-09-22 TODO 42: the lidar is in, and its yaw is still a placeholder
    Records what is wired (layer, slam config, RViz displays) against what is
    unproven (the yaw, slam itself, any floor measurement, nav2 still in odom),
    so the next session cannot mistake "it is running" for "it is correct".
2026-09-22 Make RViz a map you can analyse, and fix the three faults that found
    Asked for a view where the room builds as it drives and the rover moves
    through it, with the track drawn and everything in sync. Four display changes,
    and three real faults surfaced while verifying them.
    DISPLAYS
    Fixed Frame odom -> map. This is the change that makes the request true.
    In `odom` the ROOM slides under a stationary rover every time the pose is
    corrected; in `map` the room holds still and the rover moves through it.
    The top-down view's Target Frame moves from base_link to <Fixed Frame> for
    the same reason -- riding the rover pins it to screen centre, which is
    exactly the thing you cannot read a po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
2026-09-22 Commit the 46 x 42 footprint the rover model now draws
    This edit was sitting uncommitted in the working tree from a previous session:
    nav2's footprint widened from 35 x 38 to 46 x 42 cm, from the owner's
    description of the rover on 2026-09-22 (body 36 x 28, tyres 5 cm past each end
    and 7 cm past each side).
    It goes in now because phase2/nodes/rover_marker.py was just changed to draw
    exactly these numbers, and that file's whole contract is that the picture and
    the planner agree. Leaving one committed and the other not would guarantee they
    drift apart.
    Still NOT tape-measured -- both files say so. If a doorway that used to pass
    starts failing, measure tyre-to-tyre and nose-to-tail and fix bo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
2026-09-22 Add a live yaw readout, so the mount angle stops being described in words
    Two attempts to set LIDAR_YAW from a description of the RViz picture produced
    two OPPOSITE errors -- "front draws on the left" and then, after rotating -90
    to cancel exactly that, "left draws as front". Both cannot be true of the same
    object, and a -90 rotation should have turned the first into a correct picture.
    The fault is the method, not either report: a quarter-turn error looks the same
    from several descriptions, and the sign is easy to invert at every step between
    eye and file.
    So stop describing it. `./rover lidar --watch` prints, once a second:
    nearest raw bearing renders at LIDAR_YAW would be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
2026-09-22 Measure the turn fault: 11% of commanded, asymmetric, and that is the x,y shift
    TODO 37 recorded "turning shifts x,y" as an unverified report. It is now
    measured, and the cause is not drift or a sensor fault -- the rover does not
    pivot about its centre.
    Driving the rover and reading /wheel_state against /odom:
    - pivots reach ~11% of commanded wheel speed and ~7% of commanded yaw rate.
    A sweep of wz from 0.4 to 2.5 rad/s, both directions, never beat 5%. Peak
    wheel speed saturates near 0.11 m/s whatever is asked, so this is not a
    scale constant that can be trimmed.
    - straight driving reaches OVER 100% of command on the same wheels, so
    neither motor is weak. The deficit is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
2026-09-23 ./rover up: bring pose up with SLAM=false, or the slam step refuses
    `up` runs camera lidar pose fused slam ..., and pose's default is SLAM=true --
    cuVSLAM loop closure on, publishing map -> odom. The slam layer's guard (added
    earlier today) correctly refuses to start a second owner of that transform,
    so every full bring-up would have stopped half done, at slam, with nav2 and
    the VLM bridge never started.
    In this sequence slam_toolbox is meant to own map -> odom, so `up` now runs
    the pose step as `SLAM=false ./rover pose`. Running ./rover pose by hand keeps
    its old default.
    Verified on the power cycle of 2026-09-23: ./rover up ran every layer through
    vlm, wheels, Pi 5 and Studio; vo_node ca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
2026-09-23 ./rover wheels --nudge: the link rate cannot tell you the motors are off
    After the 2026-09-23 power cycle every gate passed -- /wheel_state 20 Hz,
    /cmd_vel subscribed, "Wheels are live" -- and the rover could not move. The
    firmware echoed each command back in /wheel_state.z (it arrived), and the
    encoders read exactly zero on both sides (nothing turned). The ESP32's logic
    was powered; the motors evidently were not.
    The rate gate proves the board is TALKING. Only moving proves it can DRIVE,
    and a gate that moves the rover cannot be the default. So it is opt-in:
    ./rover wheels --nudge sends 0.05 m/s for 1.5 s (~7 cm) and names which of
    three things is wrong -- command never arrived, arrived an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
2026-09-23 Grade turns against the walls: the slide is real, the pose misses ~7 cm of it
    With motor power confirmed (./rover wheels --nudge: 0.051 for 0.050 on both
    sides), ./rover pivot ran four 90 deg turns and registered LiDAR scans either
    side of each. It now prints odometry's displacement beside the LiDAR's, which
    splits one complaint into three separate findings:
    - heading is good: -1.6 to +1.2 deg per 90, scale 0.989
    - the rover REALLY slides ~30 cm per 90 deg "pivot", rotating about its left
    wheels in both directions -- the left drivetrain is the one short of
    torque under scrub (it drives fine straight)
    - the pose sees most of that slide and misses 6-8 cm of it per turn, odom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
2026-09-23 ./rover drive: exact short moves that plan around the pivot fault
    The rover cannot turn about its centre (TODO 43), so this stops asking it to.
    Every move is rotate -> straight -> rotate, and the geometry is exact: the
    slide from rotating about a pivot P depends only on the total rotation, so a
    straight leg of the right length and direction cancels it. Any pose -- a turn
    "in place" included -- is three primitives away. It re-plans from the LiDAR-
    corrected pose after each pass and grades the end pose a second time by
    registering the start and end scans directly, with no slam involved.
    First on the floor, with the pure-wz pivot: +90 in place held the centre to
    1.0 cm (slam) and 1.2 cm (walls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
2026-09-23 Stamp /scan when it was measured: sllidar's stamps led by ~82 ms
    slam_toolbox looks the pose up at each scan's header.stamp. sllidar_node reads
    now() BEFORE grabScanDataHq() blocks for the next full revolution, so its
    stamps lead the measurement by most of a scan period. During a turn every scan
    was therefore matched against a pose ~0.6 deg away in the direction of the
    turn, and the error added up turn after turn: two +90 turns left slam with an
    8 deg heading correction that odometry and direct wall registration both said
    was wrong, and ./rover drive, steering to slam's heading, over-turned by 10.
    lidar/scan_lag.py measures it: hold still for a reference scan, turn each way
    at a steady rate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
2026-09-23 Bring every doc in line with the LiDAR and localization work
    The owner's goal, 2026-09-23: from x, y go to x + x1, y + y1, and when sent
    back land on exactly x, y, theta. Three days of work on that were recorded in
    commits and TODO 42/43, and every document a reader would actually open still
    described the stack before it. This makes them agree.
    New: LOCALIZATION.md -- the analysis in one place. The pose as built (slam
    owns map -> odom), what was found in order of impact with every number (the
    turn fault and its coin-flip pivot, the ~12% the pose misses of each slide,
    the 82 ms LiDAR stamp error, the mount angle, six silent faults), held-left
    turns, how ./rover drive plans around the slide,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
2026-09-23 ROVER_BUILD_PLAN.md: measure, CAD, URDF, power, weight, turning fixes
    The owner asked for one plan that turns this into a rover that moves
    precisely and fast: CAD, then a URDF with the exact positions of the wheels,
    LiDAR and depth camera; turning; power management on the 3S pack (does less
    voltage deliver the same movement?); and weight distribution.
    The plan is built on what is measured, and says which numbers are assumed:
    - the physics of the pivot. A skid-steer pivot needs each tyre to push about
    mu*N*sqrt(1 + (L/W)^2) -- always more than it can grip -- so the wheels
    slip and the motors work near stall. With m ~ 4 kg and mu ~ 0.7 (assumed),
    that is ~3.0 of the GB37's 3.5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
2026-09-23 description/: measured geometry, URDF and CAD from one params file
    The owner tape-measured the rover (2026-09-24). description/params.yaml
    holds those raw measurements (from the nose, from the floor), plus the
    D555 and C1 datasheet dimensions, each with status, source and date.
    Unknowns stay null: no masses are estimated. description/build derives
    every frame from them, writes rover.urdf and cad/ (build123d: STEP plus
    one STL per part), and checks the 22 other copies of these numbers in
    the repo for drift.
    What the tape changed:
    - wheelbase 0.238 (was 0.25), wheel OD 83 mm, 40 mm wide, axle 41 mm
    - envelope 36 x 38 cm (was a described 46 x 42): the wheels sit inside
    the frame's leng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
    [camera_d555.stl, chassis.stl, lidar_c1.stl, rover.step, rover.urdf, wheel_lf.stl, wheel_lr.stl, wheel_rf.stl]
2026-09-23 Live TFs from the URDF: one robot_state_publisher replaces two static ones
    ./rover pose and ./rover lidar now call tf_up, which runs
    description/build.py --rsp and starts one robot_state_publisher serving the
    URDF derived from params.yaml at that moment. A new measurement reaches the
    live TF on the next layer start with nothing to copy, and the two per-layer
    static_transform_publishers -- whose kill patterns once took each other out
    and lost the laser frame -- are gone. LIDAR_YAW=<rad> ./rover lidar still
    overrides the yaw for one run; the yaw tools now say to record it in
    params.yaml.
    Verified on an isolated ROS domain (77), not the live stack: base_link ->
    camera0_link (0.173, -0.048, 0.1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
    [rover.step]
2026-09-23 vo_node reads the camera mount from TF; rover_marker retired; sensor plan
    vo_node looks up base_link -> camera0_link once at start (15 s timeout),
    so its camera offset comes from description/params.yaml via
    robot_state_publisher. Its constants are only the fallback, and using them
    logs an ERROR. The listener is unregistered after the lookup so it does not
    decode /tf for the node's life. Tested on an isolated domain:
    0.1730 / -0.0475 / 0.1750; --self-test passes.
    rover_marker.py is deleted. RViz draws the URDF (RobotModel) and nav2's
    own /local_costmap/published_footprint, so neither is a hand copy any more.
    ./rover status's view row becomes a frames row that checks
    robot_state_publisher is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
2026-09-23 ROVER_BUILD_PLAN §9.6: edge cases for home, office and parking
    Situation-by-sensor table: where the wheels, LiDAR, camera and gyro each hold
    or fail, and the rule that follows (weight the wheels by situation, not a fixed
    low number: they are the truth for 'stopped', for plain corridors, and for
    stuck/slip detection). Records the low-and-close blind zone (under the 25 cm
    laser plane, inside ~40 cm of the nose: stairs, cables, shoes) and the
    cheapest fixes: tilt the D555, downward ToF cliff sensors, a firmware bumper.
2026-09-23 SENSOR_FUSION_PLAN.md: use every sensor for what it is good at
    The owner asked for a plan that neither ignores the wheels blindly nor
    follows the existing code blindly. It judges today's fusion.py:
    - position is the camera's direction scaled by the wheels
    - the LiDAR corrects only through slam_toolbox, every 10 cm or 0.1 rad
    - hard switches decide which sensor counts, and there is no covariance
    - front/rear ticks are summed, which throws away slip evidence
    - turning uses a symmetric effective track
    - scans are not de-skewed
    In its place: each sensor reports its own situation-dependent covariance.
    The wheels get asymmetric ICR skid-steer kinematics, a per-wheel slip
    score, a zero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
2026-09-23 Stage A: localization test harness -- record once, grade against LiDAR truth
    ./rover record SCENARIO drives one test (straight, pivot90, pivot360,
    square, small, still, manual) and bags the raw sensors plus every live
    estimate. It steers on raw sensors only: turns stop on the integrated gyro,
    straights on the four encoders. It keeps the swing and path clear from
    /scan, and Ctrl-C stops the motors before closing the bag.
    ./rover grade scores fused, vo, wheels and wheels+gyro against truth. At
    each still moment the per-beam median scan is matched point-to-line (Huber)
    against the start. A checkpoint is used only if the residual is <= 2 cm,
    the fit is not corridor-degenerate, and two independe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
2026-09-23 LOCALIZATION §7: stage A baseline (partial), graded against LiDAR truth
    The still, straight and 2-of-8 pivot90 runs are on the new geometry, and every
    checkpoint passed the truth gates.
    - Wheels over-read 50.3 cm as 51.0, in the direction the 85 vs 83 mm tyre
    predicts.
    - The fused heading drifts 0.53 deg while parked 34 s (gyro+wheels 0.12, VO
    0.00).
    - In the pivot, the fused heading is 4.94 deg off against the gyro's 1.51.
    The pivot run stalled. The actual turn rate was ~0.06 rad/s for 1.5
    commanded, and the right side barely drove in a CCW turn, then ran backwards
    under a forward command. Driving stopped to spare the motors. Suspect: low
    battery (build plan §0); the right side reve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
2026-09-25 See low objects and all round: LiDAR in the costmaps, 5 cm band, 5 cm margin
    The owner asked for wires, remotes and 6-8 cm objects to be seen, for a 5 cm
    safety margin, and for safe turns at corners.
    - The LiDAR is in both nav2 costmaps (ObstacleLayer on /scan). Until now both
    were camera-only: nav2 knew nothing beside or behind the rover. Live, the
    local costmap now holds 1043 lethal cells behind the rover.
    - nvblox's obstacle band is now 5-27 cm (was 10-24). The 10 cm floor existed
    because the TF called the camera level while it was not, so the floor rose
    with range. New `./rover camera --floor` measures the tilt off the floor in
    the camera's own depth (RANSAC over ~40k points,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
    [rover.step, rover.urdf]
2026-09-25 Camera lever arm fitted against LiDAR truth: the left imager is on the LEFT
    Stage A's baseline is now recorded: pivot90 (6 of 8 turns), pivot360, a
    single turn, and a 0.4 m square, on the charged pack. After every turn,
    fused and VO were ~13 cm off even when the rover barely moved: a lever-arm
    error. Re-projecting the recorded VO with candidate camera offsets against
    LiDAR truth (26 checkpoints, 7 runs) fits camera0_link at
    (0.1623, +0.0419) +- 3 mm. The mean error drops from 8.0 to 2.0 cm and the
    max from 19.6 to 5.7. Leave-one-run-out holds (e.g. held-out 13.6 -> 1.3 cm).
    The D555 driver's TF sign put the left imager on the right. The old y = 0
    explains TODO 43's "7 cm per turn" (0.0475 *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
    [rover.step, rover.urdf]
2026-09-25 LOCALIZATION_GAPS.md: what stands between the rover and an always-correct pose
    Measured on the running rover:
    - nvblox and both costmaps store obstacles in odom, which drifts; SLAM
    corrects only every 10 cm / 0.1 rad, and nothing stored follows it
    - the LiDAR is not an odometry input
    - the camera's yaw is 0 deg in the URDF and 2.06 in VO, and the LiDAR says
    +1.09 (depth slice matched to the scan, 1.2 cm residual)
    - the gyro under-reads by ~2%
    - wheel ticks carry no timestamp
    - VO drops ~1 frame in 5
    - the depth time offset is unmeasured
    - the Pi 5 clock is >= 30 ms off
    - /odom has no covariance
    - an item on the rover blocks a LiDAR sector
    Order: camera-LiDAR ca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
2026-09-25 SENSOR_FUSION_PLAN §8: movement roadmap, the sensor joins and phases M1-M5
    The joins:
    - gyro+LiDAR: de-skew and gyro scale
    - LiDAR+wheels: slip/stuck detection and the ICR fit
    - LiDAR+camera: extrinsic and depth time offset
    - wheels+IMU: zero-velocity lock
    - voltage+motors: pivot torque margin
    Phases, each with acceptance numbers graded by the harness:
    - M1 calibrate
    - M2 LiDAR odometry
    - M3 covariance-weighted fusion (with /odom covariance and health flags)
    - M4 closed-loop motion primitives and firmware anti-windup/stamps/INA226
    - M5 safe navigation (rotation shim, collision monitor, confidence-scaled
    speed, cliff sensors)
    Also what to keep cheap now so the arm fits later.
    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
2026-09-25 harness: 'return' scenario, the owner's drive-around-and-come-back test
    Drive it anywhere for --secs (180 by default), put it back on the start
    mark, and every estimate should read ~0. The LiDAR truth row says how close
    it really got back.
2026-09-25 ./rover camera --lidar: measure the camera against the LiDAR, pose by pose
    M1's first calibration. Each capture takes the median depth band at 20-30 cm
    (where the camera and the laser see the same walls), fits it point-to-line to
    the median scan, and saves the correction. --solve combines 4-6 hand-placed
    poses into one camera yaw (plus an x/y cross-check against the VO lever-arm
    fit) and prints the params.yaml line. A test capture: dyaw +1.43 deg,
    residual 1.1 cm, min eigenvalue 1067 (well constrained).
2026-09-25 M1: camera yaw measured against the LiDAR, now the only camera yaw
    `./rover camera --lidar` from 6 hand-placed poses facing corners. Per spot:
    +1.59 -0.29 +0.71 +1.13 +0.98 +1.57 deg, median +0.96. The depth scale fits
    at 1.00; +-3% moves the residual under 0.1 cm.
    - params.yaml camera.yaw 0.0168 rad (0.96 deg), in the URDF. Depth, nvblox
    and the costmaps all follow it.
    - vo_node takes roll, pitch and yaw from TF. cam_yaw_deg is now an EXTRA
    correction (default 0). The August 2.06 deg came from an older mount, and
    it fit LiDAR truth worst of the values tried (mean 2.03 cm vs 1.75 at
    0.96). It is kept only for the self-test.
    - Independent check: the same fits put camera0_link within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
    [rover.step, rover.urdf]
2026-09-25 M1: gyro scale is 1.0010, fine; withdraw the '2% under-read' claim
    Three pivot360 runs each way plus every recorded turn over 45 deg, graded
    against LiDAR truth: 21 turns give a scale of 1.0010 (left 1.0012, right
    1.0006), per turn +-0.7%, 1.1 deg rms. No correction is needed.
    The 2% claimed on 2026-09-25 came from one turn (2.6% off; the other turns in
    that run agreed within 0.3%) and a trace read mid-motion. Withdrawn in
    LOCALIZATION.md §8, LOCALIZATION_GAPS G5 and SENSOR_FUSION_PLAN §8. Turns do
    overshoot 1-3 deg, because the runner integrates on arrival time and the
    rover coasts after the stop; that is an M4 motion-control item.
    The runner now waits up to 8 s for the gyro before a tu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
2026-09-25 Calibrated baseline (LOCALIZATION §9); runner gyro-counting bug fixed
    After M1, fused on full turns is 0.5-3 cm / under 1 deg (was 3.8 / 1.6), a
    1 m straight is 0.5 cm, and small moves are 0.4 cm.
    pivot90 found two things:
    - fusion.py took on a 7.6 deg VO heading jump (36 landmarks mid-spin) and
    ended 13 deg off, while gyro+wheels held 2 deg. That is M3 evidence.
    - The runner integrated the gyro from an index into a buffer it trims every
    ~20 s, so ~10 s of rotation went uncounted while the motors ran (a "+90"
    went ~112). It now integrates in the callback on IMU stamps. Truth and all
    grades are unaffected.
    The drive froze again after long near-stall pivots (encoders still for 8 s
    u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
2026-09-25 ROVER_BUILD_PLAN §4.5: power system redesign, open for the owner's discussion
    The owner decided the power system needs a proper design for consistent
    behaviour. Batteries and connections will be discussed before anything
    changes. §4.5 collects the evidence:
    - the weak-pack pivot at 3 deg/s, then the fast pivots after charging
    - freezes after long near-stall pivots
    - the motor feed found off after a power-cycle
    - no voltage or current telemetry anywhere
    And the questions for that discussion: the pack, who powers what, motor
    headroom, INA226 sensing, wiring and safety, low-battery behaviour, and the
    arm's load. Until then: charge before motion tests, and log it.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
2026-09-25 M2: LiDAR odometry, worst 0.9 cm / 0.39 deg over every recorded run
    phase1/nodes/lidar_odom.py has no ROS inside it:
    - gyro de-skew of every scan
    - scan-to-submap point-to-line ICP with a Huber kernel (the last 10
    keyframes, 3 cm voxels)
    - per-fit residual, inliers and degeneracy eigenvalue; a failed fit falls
    back to the prediction and is flagged
    The grader runs it as a `lidar` estimator, and SUMMARY gets a lidar column.
    The de-skew direction was decided by grading 13 turning runs (43 truth
    checkpoints). Beams run backwards in time (the C1 spins clockwise):
    heading 0.17 / 0.39 deg mean / max, against 1.32 / 5.31 without de-skew
    and 12-14 deg the other way.
    Over all 17 runs the worst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
2026-09-25 M2: LiDAR odometry live as /lidar/odom (no TF), recorded and graded
    lidar_odom_node.py runs the same class the harness grades offline. It holds
    each scan 0.12 s so the gyro covers its sweep, then publishes nav_msgs/Odometry
    in frame lidar_odom with covariance from the fit; failed fits get 1 m /
    10 deg. It publishes no TF: odom -> base_link stays with the fusion until M3.
    It starts in the fused layer with a rate gate, and a status topic carries
    residual, inliers, degeneracy eigenvalue, failures and ms/scan.
    The harness records /lidar/odom and grades it as lidar_live.
    Live: 10 Hz, 7.5 ms per scan, 0.17 cm residual; parked 34 s it holds
    0.0 cm / 0.05 deg.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
2026-09-25 M2 passes the owner's tape-marked return test: live LiDAR odometry within ~1 cm / 0.3 deg
    The rover was moved by hand and put back on tape marks. LiDAR truth says it
    ended 0.9 cm / 0.1 deg from its start, consistent with the tape. The live
    /lidar/odom was 0.3 cm / 0.24 deg from that. Fused was 20.5 cm off (3 jumps),
    VO 8.9 cm / 6.0 deg, wheels+gyro 24.9 cm.
    M2's acceptance holds on every recorded run and on this independent check.
    The motor-driven zigzag waits for the power work (build plan §4.5).
2026-09-25 M3: fusion2 offline, every sensor weighted by its own reliability
    One EKF over [x, y, th, vx, vy, gyro bias]. The gyro predicts at 200 Hz.
    Gated, evidence-weighted corrections:
    - LiDAR odometry pose through a re-anchored offset, late fixes carried
    forward by motion only
    - adaptive VO (velocity while the LiDAR is healthy, absolute pose when not,
    noise by landmarks)
    - wheels with slip- and turn-rate-dependent noise
    - a zero-velocity lock that re-measures the gyro bias
    Over 19 recorded runs, with LiDAR fixes fed at their live 0.13 s delay:
    fused2 worst 0.8 cm / 0.45 deg, mean of worst 0.3 cm / 0.19 deg, as good as
    the LiDAR alone. Without the LiDAR it is 6.2 cm / 1.43 deg against fused.py'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
2026-09-25 M3: fusion2 live beside fusion.py as /fused2/odom (no TF), recorded and graded
    fusion2_node.py runs the class graded offline. It passes each /lidar/odom
    fix with its scan stamp so the late fix is carried forward by motion, reads
    VO landmarks and health from /vo/status, and treats the 1 m failed-fit
    covariance as a failed fit. It publishes pose, full 3x3 pose covariance,
    velocity and a status topic (flags, accepted and rejected per source, gyro
    bias, sd). It publishes no TF: fusion.py still owns odom -> base_link.
    It starts in the fused layer with a rate gate, the harness records
    /fused2/odom and grades it as fused2_live, and logs/calib/ (calibration
    captures) is ignored.
    Live: 20 Hz, all s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
2026-09-25 M3 live: fusion2 passes the owner's second return test, 0.1 cm / 0.32 deg
    The rover was moved and turned by hand with the wheels skidding at times, then
    put back on tape marks (truth 0.1-0.2 cm). fusion2 live read 0.1 cm /
    0.32 deg, matching offline (0.2 / 0.29). fused.py read 1.8 cm (9.7 worst) and
    wheels+gyro 24.5 cm / 5.2 deg. The slip score reached 0.74 and down-weighted
    the wheels. LiDAR had 4900 fixes accepted and 0 rejected; VO 4 jumps
    rejected.
2026-09-25 Switch: fusion2 owns odom -> base_link; fusion.py is the fallback
    At the owner's call after fusion2 passed the live return test (0.1 cm /
    0.32 deg):
    - `./rover fused` has FUSION=2 (default): fusion2_node on /odom with
    publish_tf, frame odom
    - fusion_node runs beside it on /odom_legacy with no TF
    - FUSION=1 swaps them back; exactly one ever sends the TF
    - fusion2_node gains publish_tf / odom_topic / frame_id params, defaulting to
    side-by-side so a bare run cannot steal TF
    - the harness records /odom_legacy and grades it as fusion1; `fused` stays
    "whatever drives the rover"
    Checked live: one process each, odom -> base_link on /tf, /odom at 20 Hz,
    fusion2 taking 10 LiDAR fixes/s and reje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
2026-09-25 Switch: fusion2 owns /odom and odom -> base_link; fusion.py is the fallback
    FUSION=2 (the default, the owner's decision 2026-09-26 after the live return
    test): fusion2 publishes /odom and the TF, and fusion.py runs beside it on
    /odom_legacy without TF. FUSION=1 ./rover fused swaps them back. Exactly one
    node sends odom -> base_link in either mode. The harness records
    /odom_legacy and grades it as fusion1, so `fused` always means what drives
    the rover.
    The first two switched runs wedged within minutes: /odom and the TF went
    silent while the estimate stayed current. A gdb-injected state probe showed
    rclpy's single-threaded executor starving both timers (0.5-0.8 s overdue,
    never called) while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
2026-09-25 Cleanup: keep only what the rover needs; the Phase 1 fusion retired
    The owner asked for one clean structure: shape (CAD/URDF), calibrated
    sensors, a tested fusion, and precise, safe moves.
    Retired (all in git history):
    - phase1/nodes/fusion.py, fusion_node.py: the Phase 1 estimator. fusion2
    replaced it (worst 0.8 cm / 0.45 deg vs 20.5 cm / 13 over 19 runs; the
    owner's return tests). No FUSION switch, no /odom_legacy.
    - compare.py (./rover compare) and lidar/pivot_test.py (./rover pivot):
    replaced by ./rover record / ./rover grade against LiDAR truth.
    - logs/*.py: 31 one-off diagnostic scripts. map_stats.py, which ./rover map
    still uses, moved to phase2/tools/.
    Kept working:
    - fusio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
2026-09-25 M4: goal executor, exact (x, y, theta) moves, 177/180 simulated goals at ~1.2 cm
    goal_exec.py (no ROS), goal_exec_node.py (live on fusion2's /odom),
    ./rover goto X Y [DEG] [--odom|--map]. The VLM brain can use
    /goal_exec/goal.
    It approaches along the goal line: a pre-goal 25 cm behind on the line, with
    both turns' slides pre-compensated, then a straight drive along the line
    steering out cross-track error. Retries back up along the line, with no turns
    in place, and the last motion is always straight. The turn slide is learned
    from every turn (P = (I - R(a))^-1 d, per direction) and saved between runs.
    Safety: the outline + 5 cm swept about the learned pivot for turns and along
    the leg for s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
2026-09-26 M4 live: first goals on the rover; recorder output unbuffered
    ./rover goto on the rover, each goal recorded:
    - back 40 cm reached 0.7 cm (LiDAR truth: 0.8 cm from the goal)
    - return to start reached 1.2 cm / 0.5 deg
    - a 90 deg turn in place stalled on a small correction turn
    - a 58 cm back-right move limit-cycled 6-7 cm off its line
    The rover showed two things the simulator did not: small in-place turns stall
    when the command decelerates below the scrub threshold, and steering while
    driving corrects less cross-track error than modelled. Both are fixes to make
    before the next live round (LOCALIZATION §12).
    ./rover record runs the harness with python3 -u: piped, its output was
    block-buffere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
2026-09-26 ./rover response: the rover's real pivot, arc and creep response on this floor
    Pivot in place follows 17-39% of the command, rising with it (fit:
    0.52*cmd - 0.21 rad/s), and slides the centre 1-4 cm. Arcs while driving
    follow only 15-25% (the simulator assumed 85%), which is why the live line
    approach could not steer out cross-track error. Straight creep works even at
    0.02 m/s. Another drive freeze after ~20 s of pivoting; the arc and creep
    rows were re-run on a rested drive.
2026-09-26 M4: goal_exec retuned on the measured response; simulator uses it
    The simulator now models the rover as measured (./rover response):
    - pivot in place at 0.52*cmd - 0.21 rad/s, scaled for the pack
    - arcs at ~22% of the command (it had assumed 85%)
    goal_exec changes:
    - turn command floor 1.0 (0.6 stalled live)
    - turns stop early by the measured rate x 0.25 s
    - drive steering gains ~4x (command units), clip 1.0
    - pre-goal runway 35 cm, minimum 20 cm to steer out cross-track
    Three seeds x 3 chassis x 12 goals: 104 reached, 2 correct refusals, 1 miss.
    Mean 0.9-1.2 cm, worst 1.5 cm / 1.06 deg. Obstacle refusals are unchanged.
2026-09-26 M4 live round 2: all four goals reached; the loop closes within 1.4 cm
    Retuned on the measured response, on the rover:
    - turn 90 deg in place: 0.8 cm / 0.96 deg (LiDAR truth)
    - forward-left, face +90: 1.25 cm / 0.8 deg
    - return to start: the four-goal loop closes within 1.4 cm / 0.8 deg
    - forward 30 cm: reached, then disturbed ~11 cm after finishing (wires under
    the wheels)
    Round 1's stalling turn and line-approach limit cycle are gone. fusion2 is
    within 0.1-0.4 cm of the truth; the wheels alone were off by up to 59 cm.
2026-09-26 M5: ./rover navto — nav2 route + goal_exec exact finish; first nav2 drives on fusion2
    nav2-only goal succeeded (8.6 cm, inside its 10 cm). Return-to-start with
    --exact: nav2 to the pre-goal 4.9 cm, goal_exec reached 1.3 cm / 0.5 deg;
    fused within 0.1 cm of LiDAR truth. An earlier run with wires under the rover
    stalled ~80 s near the pre-goal; cause not established.
2026-09-26 nav2: LiDAR no-echo beams clear the costmap (inf_is_valid true)
    The C1 reports inf for ~95 of 720 beams in a room; with inf_is_valid false
    those beams cleared nothing, so marks left while the rover was carried stayed
    and closed a 48 cm gap it fits through. Also correct ./rover nav's stale
    narrowest-gap message for the measured footprint + 5 cm padding.
2026-09-26 M5: ./rover pass — tight gaps on raw points, goal_exec pass mode; 2.5 cm map
    nav2 refused a gap the rover fits: 5 cm cells round each edge inward (~50 cm
    read 40-45), and a cell-map planner keeping the padded outline clear cannot
    thread a gap within a few cm of the rover. The precise pass measures the gap
    from LiDAR + depth at rover height (1 cm, remembered in odom, forgotten when
    seen through), lines up, and crawls the centre line at 5 cm/s with the
    owner's 3 cm margin, stopping and backing out on any contact.
    Simulated with the C1's measured 1-3 mm noise: 50/48 cm pass without a
    touch, 43 refused, 46 the boundary. Live: a ~55 cm gap passed, 1.1 cm /
    0.8 deg at the end, fused within 0.7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
2026-09-26 nav2 supervised: any node dying restarts nav2 whole
    planner_server segfaulted after live footprint_padding changes; the global
    costmap lives in it, so RViz showed a frozen map (the owner saw the gap stay
    solid cyan) while the rest of nav2 ran. nav2's own respawn left the lifecycle
    manager stuck mid-reset, so instead any node exiting shuts the launch down and
    nav2_supervise.sh starts it again clean. Verified: planner killed with SEGV,
    nav2 back whole and planning. ./rover nav also kills the launch process now
    (it had respawned duplicates of every node).
2026-09-26 M5 pass: see low things close up, look ±25°, re-check while crawling; RViz shows what decides
    The stool's feet stuck out under the depth band's flat 5 cm floor (owner:
    50 cm at the floor, sensors 60 at 5-27 cm). Measured floor noise sets the
    band floor by range (2 cm < 1 m, 3.5 to 1.6 m, 5 beyond). Pass mode re-checks
    the rest of the line every step and stops 'blocked ahead'; ./rover pass then
    re-measures (at most twice). Before measuring it looks ±25° (owner's idea).
    RViz: the local costmap near the rover (the whole-room costmap's 45 cm halos
    hid everything), the depth obstacles at 1 cm coloured by height
    (/goal_exec/obstacles), and the pass corridor (/gap_pass/markers).
    Live: ~50 cm-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
2026-09-26 depth_obstacles: history 5 for 800 KB depth frames; cached camera mount
    With history 1 each new frame's fragments evicted the one being reassembled
    and no image arrived. The static camera mount is cached on every live lookup
    and used after 3 s without /tf_static (a node flooded by images went 15 s+
    without it). Live after the fix: look ±25, measured the ~50 cm floor gap at
    51.5 cm (the stool's feet now counted), passed at 1.1 cm / 1.0 deg.
2026-09-26 LOCALIZATION §13: the look + low-band pass measured the floor gap at 51.5 cm and passed
2026-09-26 reach: get to the goal — nav2, exact finish, and on failure look / pass / wait, retrying
    nav2 gave up on the owner's goal in a 51 cm corridor within 15 s: its path
    follower saw 'collision ahead' on every wobble and its Spin/BackUp recoveries
    were refused. reach_node owns the goal (RViz 2D Goal Pose -> /reach/goal,
    ./rover reach X Y [DEG]): nav2 far, goal_exec near and for the exact finish;
    on failure stop, clear costmaps, face the goal, look ±25, then precise-pass if
    narrow or wait if blocked; up to 8 attempts / 5 min. No collision check is
    ever switched off. ./rover nav starts goal_exec and reach with nav2;
    kill_match patterns bracketed so they cannot kill their own shell.
    Co-Authored-B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
2026-09-26 Review fixes: check motion while it runs, never act on a frozen view
    - goal_exec: turns and legs re-checked every step for what is left (was
    start only); 2 consecutive blocked steps stop it. Sim: a box appearing
    mid-leg is now refused 29 cm short (new case); suites unchanged.
    - goal_exec_node: no LiDAR scan for 0.5 s pauses the goal (the last scan
    never expired).
    - gap_pass turn_to: stops if pose (0.3 s) or scan (0.5 s) goes stale;
    re-checks the swing every step.
    - reach: nav2 failure reasons from this attempt's log lines only.
    - ./rover status: nvblox integration, goal_exec, reach, nav2 restarts.
2026-09-26 INTELLIGENCE_PLAN: why 'go near the bottle' spins and misses, and the plan
    The pixel is grounded with the newest depth and pose, not the ones the photo
    was taken at (the camera stamp is dropped on the Pi 5). The brain's turns are
    timed 5 rad/s pivots, and it sends raw nav2 while /reach and /goal_exec run
    unused. Found objects are never remembered. ML/RL: what the market does, what
    pays off here. Plan B1-B6, each graded on the rover.
2026-09-26 B1 + B2: goal_exec turn-only mode, goal ids in status, photo-time grounding
    goal_exec: /goal_exec/turn turns to a heading and stops (within 2 deg, slide
    reported, never driven back). Simulator: 24/24 turn-only goals within 2.5 deg
    over three chassis conditions, no forward command; suite PASS.
    goal_exec and reach status lines carry goal_stamp so a caller matches its own
    goal's result.
    pixel_to_goal: /vision/pixel_snapshot freezes the depth frame and camera pose
    of the photo the VLM is looking at; a stamped pixel_query grounds against it.
    Live: snapshot 33 ms from the photo, expired stamps refused, still-rover
    photo-time vs newest agree to 2 mm.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
2026-09-26 goal_exec: judge a turn after it stops rolling; rate over 40 ms; pose-stamp clock
    Floor test of B1 (move_robot L/R through /goal_exec/turn): 5/6 within 2 deg,
    one R:90 failed "-5.6 deg after 8 tries" in under a second of retries. Two
    causes, both reproduced in the simulator (short coast + bursty clock: 1/10):
    - /odom stamped 50 ms apart ARRIVED 0.6-441 ms apart on the loaded Jetson;
    a turn rate over 0.6 ms made the coast lead huge and turns stopped short.
    The node now steps on the pose's stamp, and the rate needs >= 40 ms.
    - a retry judged while the rover was still coasting "arrived" at once; 8
    tries burned during the coast. Now it waits SETTLE_S after each turn.
    Simulator: suite PASS,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
2026-09-26 pixel_to_goal: ground the VLM's box -- nearest solid slab above the floor
    Floor test: a bottle 1.2 m ahead, located from three poses, came out 65 cm
    apart. Gemma 4 12B's x is good to ~5 px, its y is off by up to ~45 px either
    way (checked on four objects in one photo), so its "centre" sat on the cap's
    top edge and the depth there was the door behind.
    A query may now carry the VLM box ("<id>;box=x0,y0,x1,y1" in frame_id). Every
    valid depth pixel in the box (+45 px up and down) goes to odom with the
    photo's camera pose; floor points (z <= 4 cm; base_link is on the floor) are
    dropped; the nearest slab of >= 12 points within 10 cm of range is the object.
    Nothing above the floor -> the old centr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
2026-09-26 ghost_check: which costmap layer holds an obstacle nobody can see
    Owner: a person in front of a standing rover sometimes leaves a lethal blob
    in RViz after walking off. The checker classifies every lethal cell ahead as
    live (LiDAR now), camera memory (nvblox planning slice only) or stuck in the
    LiDAR layer.
    Three walk-ins measured (a pass; standing facing a door at 2 m; standing
    facing open space past the camera's 3 m reach): all cleared, nvblox within
    ~2 s -- the "background beyond 3 m" theory is refuted. Unexplained so far:
    the costmap cleared in steps up to ~14 s after nvblox, and twice ended a
    test 150-400 cells below its start (stale cells flushed). OPERATIONS.md §5
    says how to catch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
2026-09-26 Depth only while a goal needs it: idle goal_exec and reach starved the camera
    The brain found a bottle and could not measure it: the D555 sent no depth for
    up to 9 s (the gap is in the frames' own stamps) with every Jetson core at
    76-88% and the camera driver logging "callback took too long". Idle,
    goal_exec and reach each received every ~800 KB depth frame (~25/s) into
    Python for their obstacle memory -- ~40% CPU each doing nothing.
    DepthObstacles.set_active(): goal_exec subscribes when a goal arrives (and
    waits up to 2 s for one fresh view before moving), reach only while pursuing;
    both drop the subscription when done. The memory is kept, not updated.
    Idle cost 39% -> 27% each; aligned de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
2026-09-27 pixel_to_goal keeps 24 photo snapshots: the Pi 5 now surveys every photo
    The Pi 5 brain surveys every photo it takes in the background (look, each
    search view, locate): the VLM lists the objects, and each is grounded here at
    that photo's stamp and stored in the brain's object memory. Those queries
    arrive after a search, which now has 8 views (45 deg steps), so 8 snapshots
    would have dropped the depth of the photos being surveyed. 24 x ~0.9 MB.
2026-09-27 reach: at the spot with only the final turn blocked is arrival
    "Go to the white box" (2026-09-27): reach put the rover 1-2 cm from the
    goal, then goal_exec refused the final turn to the goal heading ("something
    0.24 m away is in the +84 deg swing" -- the box, or the wall beside it).
    reach retried that same turn 8 times over 171 s and reported the whole trip
    FAILED. Within AT_GOAL_M (5 cm) with only a swing refusal, it now reports
    result "reached" plus a "note"; the Pi 5 brain tells the user it arrived but
    couldn't turn all the way.
2026-09-27 pixel_to_goal: a photo in a depth gap takes the next depth if the camera stayed still
    The D555's depth stream stalls under CPU load (1.8 s in a quiet minute,
    7.1 s at the moment of a photo on 2026-09-27; 3 of 15 photo holds failed).
    A photo inside a gap then had no depth, so the Pi 5 could not place the
    object the user had just been told about. Now the camera pose AT the photo
    is kept, and the first depth frame after the gap is used if the camera has
    moved less than 2 cm and 1 deg since (same view, same depth); moved ->
    "moved_before_depth", never a guess. Waits up to 12 s. Offline-tested:
    no gap info, still waiting, still camera, moved camera.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
2026-09-27 Costmap drawn in body terms; 2 cm margins; nav2 crash-test settings
    Owner, 2026-09-27: parked in a U-shaped pocket with ~15-22 cm to the walls,
    the rover looked trapped in RViz and hesitated in turns and near walls.
    - phase3/nodes/wall_margin_view.py (new, display only): the global costmap
    as the owner reads it -- walls RED, the body margin VIOLET, floor clear.
    nav2's own view is drawn for the rover's CENTRE (a ~23 cm cyan band).
    Started by ./rover nav; "Walls + body margin" is on by default in RViz,
    nav2's costmap display is off by default.
    - margin 5 cm -> 2 cm everywhere it is enforced, kept equal:
    nav2 footprint_padding, goal_exec.py MARGIN, reach_node.py MARGIN
    (3 cm before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
2026-09-27 Drive-test fixes: centred routes, nav2 arrival is final, no global clears
    From random-goal drive tests on the floor (2026-09-27), rotation goals
    (side/behind, a different final heading) and tight passages:
    - inflation_radius 0.45 -> 0.80 at cost_scaling_factor 2.0: routes kept
    to the edge of the old 45 cm zone, where the rover cannot turn; now to
    the middle. "collision ahead" went from 172-312 per goal to 0-36.
    - cost_scaling_factor stays 2.0 (10.0 preceded the segfaults).
    - reach: nav2's arrival is final -- a refused exact finish no longer
    re-runs nav2 + squeeze (8.3 m driven for a 1.5 m route before); a near
    goal whose docking line is refused goes to nav2 next.
    - goal_exec pass mo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
2026-09-27 Nav2: body-aware planning (Smac Lattice) + MPPI, escape, honest failures
    The owner's RViz goal from a tight pocket failed after 8 attempts / 341 s
    with 2 m of open floor ahead: NavFn plans for a point, RPP could only pivot
    first (refused), and the 2 cm hard margin counted the rover as already in
    collision. See NAV_PLAN.md for the plan, measurements and next phases.
    - planner: NavFn -> SmacPlannerLattice, diff-drive primitives generated at
    2.5 cm (config/lattice_diff_2p5cm_r0p4.json, nav2 jazzy generator)
    - controller: RPP -> MPPI (DiffDrive, 1000 x 40 @ 20 Hz, footprint
    CostCritic, forward only); held 20 Hz on the floor
    - margins: hard contact margin split -- global (planner) 1 cm, loca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
2026-09-27 Nav N6: footprint_clear layer, goal snapping, straight-only escape
    Drive test 2026-09-28: 2.6 m through a gap reached 0.8 cm first attempt
    (39 s); clicks touching an obstacle snap 8-46 cm to a pose that fits;
    "Start occupied" 0 after the heading-sweep fix (6 per session before).
    - phase3/plugins: rover_costmap_plugins::FootprintClearLayer (C++, built
    inside the image by build.sh like lidar/build.sh). GLOBAL costmap only,
    after nvblox + LiDAR, before inflation: the cells under the rover's own
    outline are free, swept +-11.25 deg (the lattice checks its start at the
    nearest of 16 headings) + 2 cm. MPPI's local costmap keeps every mark.
    - reach: goal snapping (fit): nearest pose, same h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
2026-09-27 rate_probe.py: topic rate without decoding (for ./rover gates)
    ros2 topic hz deserializes every message and fell behind on big ones on the
    loaded Jetson (raw depth read 11.5 Hz vs 28.4 Hz counted raw, 2026-09-26).
    This counts raw arrivals, BEST_EFFORT / VOLATILE, so it matches any
    publisher. Not wired into ./rover yet.
2026-09-28 STARTUP.md: power-cycle lessons of 2026-09-28; reach logs pose OK / NO POSE
    STARTUP.md: the Jetson renamed itself rakhi-jetson-3.local after a power
    cycle (avahi name clash; restart avahi-daemon); the D555 needs ~60 s after
    a PoE replug, longer than ./rover up waits; continue layer by layer instead
    of re-running up (which restarts the camera); pose needs SLAM=false or slam
    refuses; nav2 lifecycle bringup can hang (costmaps 0.0 Hz) -- re-run nav;
    the footprint_clear plugin build and the two post-restart checks.
    reach_node.py: logs "pose OK" once /odom arrives, or "NO POSE" after 5 s,
    so ./rover logs reach is the whole check after a restart.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
2026-09-28 Camera tilt re-measured: pitch +0.50, roll -0.85 deg (was 0.0 / -1.40)
    ./rover camera --floor on clear floor, 2026-09-28 after a power cycle and
    the rover being lifted by hand: 73% of 40k points on the plane, 3.3 mm rms.
    The 0.5 deg of pitch the TF did not know made the floor rise ~2.6 cm by
    3 m; with depth noise, far floor crossed nvblox 5 cm obstacle band. After
    applying it (description/build, lidar..vlm restarted): ghost_check shows 0
    camera-only cells from 0.35 to 1.35 m on the same clear floor.
    [rover.step, rover.urdf]
2026-09-28 Nav under load: MPPI 10 Hz / 3 s, CPU diet, nav2 bringup watchdog
    Drive test 2026-09-28: with the Jetson at load ~9 on 6 cores MPPI ran at
    8.7 Hz against a 20 Hz plan ("Control loop missed its desired rate" 8x),
    commanded ~0 for 40 s ("Failed to make progress") and a 1.6 m goal took
    148 s.
    - MPPI: controller 10 Hz, model_dt 0.1, 30 steps = 3 s ahead (was 20 Hz,
    0.05 x 40 = 2 s). Half the CPU; ample at <= 0.25 m/s.
    - reach: depth subscribed only while recovering (escape/look/pass), not
    for the whole drive.
    - depth_obstacles: camera_info unsubscribed after the first message (it
    never changes) -- 30 Python wake-ups/s gone in reach and goal_exec.
    Idle: reach 30.6 -> 22.6 %, goal_exec 25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
2026-09-28 Nav: penalised slow reversing (lattice + MPPI) -- ends "Start occupied"
    In this nav2, "Start occupied" means the lattice search stopped after one
    iteration: none of its primitives out of the start fits. Forward-only, a
    rover nosed into a tight spot had no legal first move (3 of 6 attempts on
    one goal, 2026-09-28). Now: allow_reverse_expansion with reverse_penalty
    3.0; MPPI vx_min -0.10 (= the smoother), enforce_path_inversion, PathAngle
    mode 2, PathAlign use_path_orientations. Planning-only check from the same
    spot afterwards: 0 Start occupied. Limit: low things (< 25 cm) behind that
    the camera never saw stay invisible -- as for the escape and BackUp.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
2026-09-28 Nav N7: collision monitor (approach) on raw LiDAR; open-floor speed 0.35
    nav2_collision_monitor between the velocity smoother and turn_shaper
    (SENSOR_FUSION_PLAN M5: a last line independent of the planner). approach:
    the body + 1 cm, moved along the CURRENT command (turns and reversing
    included), is kept >= 1.0 s from any /scan point, so speed follows
    clearance -- full in open floor, slowing smoothly toward anything the LiDAR
    sees, whatever the costmap says. No /scan for 1 s -> stop. With that cap,
    MPPI vx_max 0.25 -> 0.35 and the smoother 0.26 -> 0.36. goal_exec and the
    reach escape keep their own swept checks on /cmd_vel.
2026-09-28 reach: after a nav2 route, finish by turning on the spot, not re-docking
    Drive test 2026-09-28: nav2 (with the collision monitor) crossed 1.1 m
    around an obstacle in ~6 s and landed 3.9 cm off -- then goal_exec's exact
    finish, which lines up by backing to a pre-goal 35 cm out, backed into
    clutter and was refused, three times (7 and 8 cm landings too); the goal
    took 48 s and 4 attempts. Now within FINISH_NEAR (= nav2's 10 cm xy
    tolerance) the finish is goal_exec TURN-ONLY to the goal heading, or
    nothing if within 3 deg. Price: a long route ends within ~10 cm, not ~1 cm;
    short goals that go to goal_exec from the start keep its 1 cm docking.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
2026-09-28 reach: approach and look -- no route to the goal? get near, face it, replan
    N8 (build and go), first piece. Drive test 2026-09-28, a far goal through
    a critical area: the route closed as the camera saw more, nav2 timed out,
    and reach could only recover on the spot. Owner: "it needs to go near and
    see the way". Now on "no path" (also when it is the reason inside a nav2
    timeout, which is now reported): points 0.5 / 0.9 / 1.3 / 1.8 / 2.4 m short
    of the goal are snapped to a pose that fits and checked with the planner
    alone (ComputePathToPose, no motion); nav2 drives to the nearest reachable
    one; the rover faces the goal and holds 2.5 s so nvblox maps the way; then
    the goal is planned again. Eac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
2026-09-28 Nav under load: BT server timeout 1 s, cached lattice heuristic, 8 m window
    Drive test 2026-09-28 (Jetson load ~10 on 6 cores):
    - bt_navigator default_server_timeout 20 -> 1000 ms: the planner, busy in a
    search, acknowledged the BT's request late -> "Timed out while waiting
    for action server to acknowledge goal request for compute_path_to_pose"
    -> Goal failed, with a route possibly available.
    - lattice cache_obstacle_heuristic: true (the BT replans the same goal every
    second) and the global costmap 12 -> 8 m (44% of the search area);
    planner_server had been the top CPU user at 80%.
    - reach: classifies the late-ack failure ("busy") and "Failed to make
    progress" ("stuck") instead o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
2026-09-28 Nav2 segfaults: root cause is nvblox's costmap plugin -- use StaticLayer
    The first nav2 crash trace ever kept (libbackward, via nav2_supervise.sh;
    logs/nav_crashes/20260928-163852.txt) is in planner_server's costmap
    update thread:
    Costmap2DROS::updateMap -> LayeredCostmap::updateMap
    -> nvblox::nav2::NvbloxCostmapLayer::updateCosts -> lookupInSlice SIGSEGV
    Every "planner_server segfaulted" of the last weeks was blamed, without a
    trace, on whatever changed that day (footprint padding, inflation radius,
    global costmap clears). It was this plugin.
    Both costmaps' nvblox_layer is now nav2's stock StaticLayer reading
    /nvblox_node/static_occupancy_grid: the same map (odom, 2.5 cm, binary
    0 / 1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
2026-09-28 rover: the #9 trap in eight more places; one refuse_if_manual
    Under set -eo pipefail a bare var=$(probe) of something that is down ended
    the script with no message: goto/navto/drive/pass/reach/response with
    teleop not running (curl's 7), the camera emitter retry, view's Xwayland
    and subscription probes, grade with no bags, and status whenever nav2 had
    never restarted (no /tmp/nav_restarts.log -> tail 1 -> no health report).
    The six MANUAL checks are one helper now, on $PI5_HOST rather than a
    hard-coded IP; teleop down is not MANUAL.
2026-09-28 fusion2 status survives a gyro stall; goal_exec refuses on it
    /fusion/status was published only from the gyro callback, with gyro_alive
    hard-coded true: when the D555 link stalled (9 s on 2026-09-26) the status
    went silent with the pose, and nothing could say why. It now also comes
    from the LiDAR callback while the gyro is quiet, with gyro_alive false.
    goal_exec's frozen-pose guard was "no /fusion/status", so it now checks
    gyro_alive explicitly -- otherwise it would drive on a frozen pose. The pose
    itself is unchanged (it still stops with the gyro). health.py reports it.
2026-09-28 pixel_to_goal: a depth gap whose camera pose is not in TF yet is retried
    c4a5ee5 kept the camera pose at a photo inside a depth gap -- but only if TF
    already had it. Under the same CPU load that stalls depth, TF lags the stamp
    too, and the photo was dropped. Now it waits (up to SNAP_GAP_WAIT_S) for the
    pose, then applies the still-camera rule as before. Offline-tested with
    stubbed ROS: gap + TF late -> pose taken -> first depth after the gap used.
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2026-09-29 OPEN_ISSUES: slot 3 is the vision-tool slot; the survey never shares an agent's
2026-09-29 teleop MANUAL also cancels reach and goal_exec
    Taking MANUAL cancelled nav2's goals only. The rover now drives through
    reach_node and goal_exec, which never heard it: goal_exec kept publishing
    its commands against teleop's 10 Hz zeros (the rover jerks between them),
    and reach retried against them for up to 5 minutes. MANUAL now publishes
    /reach/cancel and /goal_exec/cancel too -- covering goals nobody on the Pi 5
    brain started (RViz, ./rover goto). The live copy is ~/langrobo_teleop/ on
    the Pi 5: copy and pkill to deploy (OPEN_ISSUES).
2026-10-02 teleop page: stay in step with the real mode; log every switch with who
    The page read the mode only on load. The mode also changes from another
    phone, the brain (POST /mode) or a page left open on a phone that slept, so
    the label could say AUTO while the rover was in MANUAL (2026-10-01) and a tap
    could not be trusted to do what it said. Re-read every 2 s while visible and
    at once on wake; re-render only on a real change.
    Every switch is now logged, AUTO too, with the client address: only MANUAL
    was (as the nav2 cancel), so the switch that lets the robot move left no
    trace. Note: the Pi 5 was still running the 2026-08-22 copy, without
    9d780b1 (MANUAL cancels reach and goal_exec) -- redeploye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
2026-10-02 vlm nodes: spin on EventsExecutor -- pixel_to_goal 24.7% -> 11.0% CPU idle
    py-spy on the idle rover (2026-10-02): pixel_to_goal, goal_exec and reach
    spent 77-86% of their time in rclpy executors.py _wait_for_ready_callbacks,
    the stock single-threaded executor rebuilding its wait set for every message
    (depth, camera_info, /tf at ~68 Hz). rclpy.experimental.EventsExecutor
    (Jazzy) dispatches from events; callbacks still run one at a time.
    Measured over 60 s idle (top): pixel_to_goal 24.7% -> 11.0%, image_bridge
    21.1% -> 17.5% (it does real JPEG work); Jetson idle 27.0% -> 30.6%.
    Verified after: ./rover vlm gate OK; snapshot held 33 ms from the photo;
    "how far is the black backpack" -> 0.95 m,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
2026-10-02 goal_exec: spin on EventsExecutor -- 26.4% -> 8.1% CPU idle, same accuracy
    Idle, goal_exec spent 77% of its time in the stock executor's wait-set
    bookkeeping (py-spy, 2026-10-02). Same change as 3b461e2 (vlm nodes);
    callbacks still run one at a time; ROVER_EXECUTOR=single restores rclpy.spin.
    Floor test with the owner watching, after the change:
    - 7 exact 45 deg turns (scripts/capture_ring.py): all reached, 0.4-1.8 deg
    (this morning, before: 0.7-1.9 deg).
    - move_robot F:30 -> reached 0.6 cm, +0.3 deg.
    - B:30 -> stalled 15.8 cm short: the rover reversed onto a power cable on the
    floor (owner saw it); goal_exec stopped and said so -- stall detection works
    on the new executor too.
    Idle t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
2026-10-02 pose nodes: EventsExecutor -- gyro 28.7% -> 15.7% CPU; fusion2/lidar_odom at next up
    Same change as 3b461e2 / 3ac89f0. gyro_node republishes the D555 IMU at
    ~200 Hz -- the most messages of any Python node here.
    gyro (restarted alone, 2026-10-02): idle 28.7% -> 15.7% (top, 60 s). The pose
    did not move across the restart (0.08 mm), fusion2 gyro_alive true. Floor
    test, owner watching: move_robot L:90,R:90 -> +89 / -89 deg, heading back to
    91.3 from 90.8.
    fusion2_node and lidar_odom_node are changed too but NOT restarted: either
    one restarting resets odom, which invalidates the session (photos, places)
    and needs slam/map/nav restarted after it. They load at the next ./rover up
    -- grade them th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
2026-10-02 reach (gap_pass.Pass.spin_for): EventsExecutor -- 24.3% -> 8.4% CPU idle
    reach runs synchronously and keeps messages flowing through Pass.spin_for,
    which called rclpy.spin_once every 50 ms: the stock executor rebuilt its wait
    set each time (80% of reach's time idle, py-spy 2026-10-02). Pass now owns
    one EventsExecutor and spin_for steps it; callbacks still run inside spin_for,
    one at a time. ROVER_EXECUTOR=single restores rclpy.spin_once.
    Checked: sim_gap_pass.py SUITE PASS; reach restarted alone -> pose OK in 0.1 s;
    idle 24.3% -> 8.4% (top, 60 s); Jetson idle now 37.8%. Floor test, owner
    watching: "go near the black backpack" -> goal_exec refused (obstacle 0.07 m
    into the leg), reach recov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
2026-10-02 depth_obstacles: forget remembered points inside the rover's own outline
    Telegram 2026-10-02, at a door: every turn and drive refused for ~85 s with
    "something 0.01-0.02 m away is in the ... swing" -- measured from base_link's
    centre, i.e. inside the body -- while the owner could see free space. A
    remembered depth voxel is cleared only when the camera sees through it or
    after MEM_S (120 s), and the camera cannot see within ~30 cm of the nose, let
    alone under the rover: once it stood where something had been (a door that
    then swung?), nothing could clear it. points_base now drops and forgets any
    remembered point inside the rover outline (the same box goal_exec_node._scan
    drops from the LiDAR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
2026-10-02 Tight gap (45 cm): no blind Nav2 spin, reach can pass, keep edge contacts
    The 2026-10-03 gap run (spray bottle one side, low chair foot the other)
    touched the foot. Three causes, three fixes:
    - bt: Spin removed from both navigator recoveries. A 100 deg spin in a
    45 cm gap swings the outline into what is beside it; Nav2 Spin neither
    checks the outline nor models the 6-16 cm skid slide. BackUp + Wait kept.
    - reach: GP.attempt sent MARGIN 0.01, and goal_exec refuses a pass below
    0.02, so every pass since 09-27 was refused. PASS_MARGIN = 0.02.
    - depth_obstacles: forget-inside (010c90e) also forgot the real foot once
    a slide put it 1-2 cm inside the outline. Now only points 5 cm or more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
2026-10-02 Maps without turn smear; 3 cm floor line; reach looks and passes before approach
    Floor-measured 2026-10-03 at the 45 cm gap (chair leg ~7 cm tall one side,
    spray bottle the other). Four goal_exec turns of 25 deg in place:
    - Frames painted while turning, and in the first moments after (the lidar
    fix for the slide lands after the turn stops), put every object again
    3-10 cm beside itself -- the 3-4 cm the owner saw between map and room.
    New phase2/nodes/turn_gate.py: keep a depth frame only if the gyro saw no
    turn faster than 0.15 rad/s in the 0.8 s before it. depth_gate.py relays
    only those frames to nvblox (raw bytes, stamp read from the CDR; ~17% of
    one core). In the always-visi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
2026-10-02 nav2 routes keep 4 cm; reach goes to look + pass after a jam, not an escape loop
    - global footprint_padding 0.01 -> 0.04. Plan-only checks from the gap
    (2026-10-03): at 1 cm the planner routed through the 45 cm S-gap with the
    outline 0.8 cm from the chair leg (MPPI then swerved and touched it, all
    three runs); at 4 cm it is "no path" (208), and three open-floor goals
    still plan with 5.5-25.7 cm. Start-pose refusals, the reason it went to
    1 cm, are footprint_clear's job now. Local (MPPI) stays 0.02.
    - reach: after escape, a "narrow" / "stuck" / "no path" failure no longer
    retries nav2 at once from 5 cm back (five times at the gap mouth); it goes
    on to look and a straight pass.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
2026-10-02 Exact moves judge obstacles on nvblox's fused map, not single depth frames
    New phase3/nodes/fused_obstacles.py, same surface as DepthObstacles;
    goal_exec, gap_pass and reach take it through make_obstacles()
    (ROVER_OBSTACLES=depth goes back to the live 1 cm memory).
    Why (2026-10-03, 45 cm gap): with the emitter off (load-bearing for
    cuVSLAM) the live memory read 73-646 mid-air points over empty floor in
    front of the white wall, and every depth preset that removed them removed
    the chair leg too. nvblox fuses all frames from all poses; at the same spot
    it had leg 10, bottle 6, open floor 9 cells. Each occupied 2.5 cm cell is
    its four corners (never read smaller than it is); points deep inside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
2026-10-02 Review fixes: honest freshness and map checks, tests, stale notes
    - fused_obstacles: "fresh" now means a depth frame was handed to nvblox
    recently (depth_gate's new /depth_gate/passed), not just camera_info: the
    grid keeps publishing when the camera or the gate has died.
    - turn_gate: no gyro history in the first 3 s after a start is the
    subscription connecting, not a dead gyro -- dropped quietly (it let the
    first frames through ungated and warned).
    - ./rover map and status read /depth_gate/passed: back_projected_depth is a
    debug picture at its own pace (3.2 Hz while nvblox integrated 9.7 Hz by
    its own save_rates), so both said FAIL/LOW on a healthy map.
    - phase3/tools/test_obstac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
2026-10-02 goal_exec: turn-and-shuffle -- a blocked turn moves a little and finishes
    Owner, 2026-10-03: "where it can't rotate 90 deg but can up to 70, it needs
    to move and rotate". A turn the outline cannot sweep used to be refused
    outright ("something 0.22 m away is in the -21 deg swing"). Now, before
    refusing, GoalExec.maneuver() looks for the least driving that makes it
    fit: a short straight move (5-20 cm, forward first) then the turn, or the
    largest safe part of the turn, a short move, then the rest. The same check
    runs when a turn is blocked MID-turn (stop, settle 0.6 s, shuffle from
    there). Every piece is checked as a turn or leg already is (outline swept
    about the learned pivot, MARGIN); after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
2026-10-02 ROVER_STATE_DIR: a second instance keeps its own learned state
    The Mitra twin (the laptop simulator) runs the rover's navigation as a
    SECOND instance on the Jetson, on its own ROS domain. goal_exec and the pass
    tool save the learned turn pivot to /logs/goal_exec_pivot.json, and
    depth_obstacles caches the camera mount under /logs/calib: a sim instance
    would have overwritten the real rover's pivot with the sim's. Both paths now
    come from ROVER_STATE_DIR (default /logs -- the real rover is unchanged).
    sim_goal_exec, sim_gap_pass, test_obstacle_sources: SUITE PASS.
2026-10-03 reach: far goals in legs; goal_exec: more margin until the pivot is learned
    Both found by the Mitra twin (mitra_sim: Gazebo world on the laptop, this
    code on the Jetson on its own ROS domain, every moment judged on the truth).
    - reach: the global costmap is an 8 x 8 m window that follows the rover (no
    map frame), so a goal more than ~4 m away is "outside bounds" and nav2
    fails at once. Home world, bedroom -> living room (6.2 m): eight instant
    "nav2 failed" in 117 s, gave up. In a real home: any room past ~4 m.
    Now a goal beyond LEG_MAX (3.2 m) is driven in legs: the farthest point
    toward it, up to 3.2 m, that fits the rover and plans (fit + plan_ok, as
    approach); a leg that gain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
2026-10-03 OPEN_ISSUES: the Waveshare switch vs the D555's jumbo frames (parked; camera back on its direct cable)
2026-10-03 OPEN_ISSUES: Mac mini not on the rover's network; Jetson /etc/hosts had the Pi 5 at the old JioAirFiber address
2026-10-03 OPEN_ISSUES: Mac mini back on the rover's network (.5), LLM + VLM verified from a live D555 frame
2026-10-03 D1: pixel_to_goal takes the nearest slab that is >=8% of the box, not any 12-point speck
    'Go near the door' aimed at 86 points of chair leg 0.8 m away and reach
    spent 8 attempts in the clutter. Now the nearest substantial slab wins,
    else the largest; replies carry slab/share/skipped/candidates.
    Checked live on chair/cot/door; tests in phase4/tools/test_object_slab.py;
    phase4/tools/ground_check.py asks VLM + pixel_to_goal without driving.
2026-10-03 Camera re-calibrated: pitch 0.49 -> 3.02 deg (the mount moved); fake red on the glossy floor before the door
    ghost_check before: 1913 camera-only lethal cells 0.85-1.85 m ahead, LiDAR none.
    Three ./rover camera --floor runs agree (2.93-3.07 deg, 84% on plane, 3 mm rms).
    After: 497, the open floor ahead clean.
    [rover.step, rover.urdf]
2026-10-03 D1 v2: the object must also fill the middle of the VLM box; door drive tests recorded
    Drive 2 (camera fixed) reached its goal first try but the goal was the
    pillar beside the door, clipped at the box's edge. From in front of the
    door the pick moves from the frame to the door's plane. Dark plain
    surfaces still give little depth (emitter off): LiDAR grounding is next.
2026-10-03 OPEN_ISSUES: Studio door request failed on stalled turns (battery sagging), orphan Studio server
2026-10-03 G1: doors, walls, cupboards are measured with the LiDAR, not the camera
    The brain now sends what it looked for (;what=the door). For big flat
    things pixel_to_goal takes the LiDAR's nearest continuous surface across
    the middle half of the VLM box's bearing, from the scan taken with the
    photo (kept with each snapshot). A near-black door gave stereo almost
    nothing (emitter off) and the pick fell on its lighter edge. Camera
    path unchanged for everything else. 16 offline tests.
2026-10-03 G1 is a trial: LIDAR_GROUNDING switch, and OPEN_ISSUES says how to test, turn off or revert it
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2026-10-03 reach escape: log each turn's sweep/end and the point counts when none fits
    Live it showed why: reach's points (LiDAR + depth memory, 29,828) put the
    chest 3.7 cm off and a left 90 turn 0.1 cm from it -- too close on a floor
    where turns slide 6-33 cm. Root cause is upstream: MPPI's costmap pads 0.02,
    the planner's 0.04, so the controller parks where the planner will not start.
2026-10-03 reach escape: 3-point turns (turn, drive, turn) when no single move opens space
    Owner: 'move 30 degrees, then a little back, then 60 -- a U-turn kind of
    thing'. Searches ~360 short sequences; every step's sweep keeps 1 cm on
    the real points, the end must open space by the costmap; most space, then
    fewest steps, least motion, toward the goal. Points beyond 0.75 m dropped
    (1.2 s on 30k). Beside the chest: left 45, forward 10 cm, left 60 -> 3.0
    to 10.8 cm. Each step runs closed-loop (goal_exec turns, drive_straight
    with a 1 cm floor); a failed step stops it and the next attempt re-plans.
2026-10-03 Revert the reach escape changes for the start-occupied-beside-furniture case (owner)
    Reverts 20ee5ac, d631ace, d3e3549, 2b0c9d8: reach_node.py back to its
    straight-only escape at 3 cm; test_escape.py and its fixtures removed.
    NAV_PLAN keeps the measurements, marked as removed.
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2026-10-04 docs: bring every page up to date with 2026-10-04 (ghost_clear, the way back, Studio reports, RViz colours)
    - ARCHITECTURE: /ghost_clear/grid is the map nav2 and goal_exec read (nvblox's
    own grid only feeds ghost_clear); ghost_clear, trail.py, blocker_view rows;
    reach's way back; the new tools and offline tests
    - STARTUP: map layer starts ghost_clear; status row; Studio's drives now report
    back to Studio (the listener=NONE story is history) -- still one brain at a
    time for driving
    - OPERATIONS §5: how ghost_clear works, how to watch it, the LiDAR-shadow
    trace, how to switch it off; the RViz colour table
    - NAV_PLAN item 3 done; OPEN_ISSUES #5 fixed, #8 updated; README status
    - revi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
2026-10-04 OPEN_ISSUES: live test results of the day's brain fixes; E13 Pi 5 ssh login stalls
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2026-10-04 RViz: back to the original colours (owner's request)
    Reverts the colour part of 49e22a9: blocker view RED LiDAR only, ORANGE camera
    only, PURPLE both, GREY erased (full-size, as in 29c3562); rover outline
    orange, LiDAR ring orange-red, obstacle points coloured by height. Kept: the
    whole-room view on by default (1f33223) and its 10 cm squares (09187af) --
    those are what fixed 'only able to see blue', not the colours. Docs follow.
    Pi 5 338cec4 puts the brain's object dots back to orange.
2026-10-04 OPEN_ISSUES: Waveshare switch retest -- drops every frame over ~1.5 kB on two ports; both cables proven; Pi 5 jumbo doesn't work
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2026-10-09 ESP32 on USB serial (UROS_SERIAL) + ./rover view/up fixes from the 2026-10-09 bring-up
    Firmware: UROS_SERIAL 1 (default) runs micro-ROS over the USB cable to the
    Pi 5 at 115200 with every debug print compiled out (one stray byte corrupts
    the XRCE stream); 0 is the old WiFi UDP link + OTA. FLASHING.md: flashing
    from the Pi 5 with arduino-cli. Docs say USB serial where they said WiFi.
    ./rover view, each one seen failing tonight:
    - the laptop's host key is checked as the alias `rover-laptop`, not per DHCP
    address: at a new address (.5) BatchMode refused it and the search walked
    past it (OPERATIONS.md "The laptop key").
    - two $(ssh ...) under set -eo pipefail ended the script silently when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
2026-10-10 follow me: follow.py + follow_node.py; tracker dedupe; TF on its own node
    phase3/nodes/follow.py (no ROS): face the person, keep GAP 1.0 m, <= 0.3 m/s,
    no reversing; corridor + turning checks on LiDAR + fused-map points with the
    target itself excluded; stop at once inside the gap; re-acquire a new tracker
    id near the predicted position; one wild sample ignored; lost after 3 s,
    blocked after 10 s. follow_node.py: /follow/start {} | {id} | {stop_at_gap},
    /follow/cancel, /follow/status; the same pose-trust rules as goal_exec_node;
    subscribes /vision/people only while following (that wakes YOLO); a goal_exec
    or reach goal ends it; cmd_topic:=/follow/cmd_vel_dry is a dry run.
    test_follow.py: 9 cl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
2026-10-10 reach: tight route -- turns and short drives when nav2 has no path
    The bedroom door, 2026-10-10: a 77 cm gap past the open leaf (rover 38),
    nav2 NO_VALID_PATH for every goal through it (lattice turns on 0.4 m; the
    rover's left side 5 cm from a wall corner), and "come to me" from the hall
    failed after 188 s without one move. A search over goal_exec's own moves
    found F10 L45 F160; driven step by step it went out of the door.
    tight_route.py: A* over turns (15-90 deg, learned pivot) and straight
    drives (5 cm-1 m, reverse <= 10 cm), checked with goal_exec's own
    turn_clear / drive_clear at 2 cm. reach runs it on "no path" / narrow /
    stuck BEFORE the way back: LiDAR + camera map first; else the Li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
2026-10-10 RViz: what reach is doing, and the tight route's plan (/reach/markers)
    The "come to me" that failed on 2026-10-10 was three "no path" and two
    way-back hops, readable only in /tmp/reach.log. reach now draws on
    /reach/markers (transient local), shown as "Reach - what it is doing":
    a line over the rover from every status it says, e.g.
    "try 2: tight -- F10 L45 F160 (lidar)"; green reached, red failed
    the tight route's plan from where the rover stands: the centre's path,
    the outline at the end of every move, the cyan target -- green when
    planned on LiDAR + camera, amber on the LiDAR alone; cleared when the
    round ends
    tight_route.poses_of() gives the poses (turns slide about the lear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
2026-10-11 goal_exec: pass turns no longer wait for a fresh depth view; measure.py tape check
    A clicked goal through a 60-70 cm corridor spent 2 x 240 s in a gap-pass turn:
    depth_gate passes nothing while rotating, so the 1 s freshness rule stopped
    every turn and each wait reset the stall clock. Turns now run on the LiDAR and
    nvblox memory (cancel past 15 s), and a goal's depth waits are capped at 20 s.
    measure.py: per-source distance to the nearest obstacle ahead, for tape tests.
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2026-10-11 rover: TWIN error names mitra_sim's current branch, v0.0.2
2026-10-11 rover up: start follow (detect + follow_node) after vlm, not fatal
    The Pi 5 brain has "follow me" on (LANGROBO_FOLLOW=1), but follow_node and the
    person tracker were started by hand, so after every power cycle the brain said
    "the Jetson's follow node is not running". up now runs ./rover follow after
    vlm on the real robot (not the twin); a failure warns and up carries on. YOLO
    idles without demand; measured with it active: /odom 20 Hz, colour 4.5 Hz,
    grid 5 Hz, /scan 10 Hz, GPU ~10 %.
    detect gate: the publisher count is asked up to 3 times -- the graph lags a
    just-started node and printed FAIL for a running detector.
    STARTUP.md / OPERATIONS.md: the follow layer, its cost, dry-run, and the l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
2026-10-13 follow: hold when blocked close to the person, search when lost, log why
    - blocked within GAP + 0.5 m of the person is holding, not a failure
    (/follow/status holding); come mode ends reached there with the reason.
    - target unseen past COAST_S: turn toward where they went (bearing error,
    else their sideways velocity) up to 120 deg, re-acquire within 2 m; lost
    only after 8 s.
    - follow_node logs once per change why it is blocked/holding/searching:
    nearest corridor point and whether LiDAR or the fused map saw it.
    - test_follow: test_near_hold, test_search (13 pass).
2026-10-17 ops: watchdog, health in one pass, the slam room survives a power cycle
    - ./rover health: every layer's rate in one ~15 s pass (status takes 2+ min).
    - rover-watchdog (ops/, systemd via ops/install_services.sh): probes every
    30 s, serves http://<jetson>:8099/ (JSON at /health), logs changes to
    logs/watchdog.jsonl. Observe-only unless ROVER_WATCHDOG_ACT=1; never acts
    while /cmd_vel is non-zero or paused; ./rover watchdog start|stop|pause|
    resume|status|act. ops/test_watchdog.py.
    - ./rover net: WiFi signal, link rate, jitter to the Pi 5, ROS traffic.
    - slam resume: phase2/tools/map_autosave.py writes maps/last.* every 2 min
    (atomically); ./rover slam resumes it from where the rover s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
2026-10-17 twin: find the Isaac Sim twin over DDS, start its slam fresh
    The twin (mitra_sim) moved from Gazebo to Isaac Sim on a new laptop (user
    chotesh, no ssh server). TWIN=1 ./rover camera / lidar no longer ssh into the
    laptop (user rakhi24, /workspace/mitra_sim):
    - find_twin reads the twin's latched /sim/hardware on domain 42 (the laptop's
    addresses, cable ports, world, engine) and picks the address on this
    Jetson's subnet; LAPTOP_IP still overrides.
    - twin_desc_check compares the params_sha1 it announces with
    description/params.yaml.
    - twin_reset publishes /sim/reset (the rover back on its world's start).
    - SLAM_FRESH defaults to 1 under TWIN=1: the twin's rover always starts on its
    worl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
2026-10-18 ISAAC_ROS_4_6_UPGRADE.md: the 4.4 -> 4.6 plan for the agent here
    What 4.6 can and cannot give us (the packaged cuVSLAM may replace the
    pyCuVSLAM workaround and save CPU; no nvblox fixes for our issues), the rules
    (never touch orin-nav:1.1, twin first, same power mode), the gate (the Jetson
    froze four times after the 2026-10-18 power change) and the steps A-F.
    Linked from OPEN_ISSUES.md.
2026-10-18 orin-nav:1.2 + Isaac ROS cuVSLAM as the VO; JetPack 7.2.1 fixes
    The robot's default image is now orin-nav:1.2 (1.1 + Isaac ROS 4.6 + CUDA
    13.2, pyCuVSLAM removed) and its visual odometry the packaged
    isaac_ros_visual_slam, which 4.6 builds for this Orin (4.4's was Thor-only).
    TWIN=1 stays on 1.1 + pyCuVSLAM until the twin is moved on purpose.
    Rollback: IMAGE=orin-nav:1.1 ./rover up.
    - phase1/launch/vo_isaac.launch.py: the tracker; publishes /vo/odom itself.
    - phase1/nodes/vo_isaac.py: keeps vo_node's contract -- its optical frames
    under camera0_link, /vo/status with the same keys, the z-divergence guard,
    the floor-projected, gated map -> odom (slam:=true). Raw CDR reads and the
    events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
2026-10-18 review: faster gates and status, live teleop STOP fix, docs that match the code
    Speed
    - Layer gates (rate_of): rate_probe.py (raw counting, stops when its window
    is full) instead of `ros2 topic hz` (decodes every message, under-reads big
    topics, always 12 s). ~6 s a gate; slow topics (< 2 Hz) get a 12 s window.
    Checked against `ros2 topic hz` on /wheel_state: 20.0 vs 20.0 Hz.
    - ./rover status: one health_probe pass over all 14 topics (~12 s) instead
    of 14 sequential `ros2 topic hz` runs (2+ min).
    Fixes
    - teleop STOP also cancels /follow/cancel: the live copy on the Pi 5 had it
    since 10-16, the repo did not (re-deploying would have lost it).
    - Removed phase4/pi5/ (stale copy of the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
2026-10-18 slam: find the rover in the saved room before resuming; never overwrite a good room with a wrong lock
    Real robot 2026-10-18: the room was resumed from where the rover stood at the
    last autosave; it had been carried elsewhere and power-cycled, slam_toolbox
    locked onto the wrong place, and the 2-min autosave wrote that over the good
    room within minutes (only one .prev kept).
    - phase2/tools/relocalize.py: one /scan against the saved room picture
    (likelihood field; every free cell at 10 cm x 72 headings, best 12 refined
    to 1 cm / 0.5 deg). locked / ambiguous / lost. Tested: synthetic rooms 1-2 cm;
    symmetric and foreign rooms refuse. REAL bag 20261018-230500_real_survey:
    87/87 scans lock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
2026-10-19 reach + nav2: blocked goals, dithering, arrival, turn escape, local costmap
    Found on the twin (apt_s1, ledge_probe, pinned_side; every reach step and
    nav2's plans/costmaps recorded, kino_sim tools/nav_explain.py):
    - planner_says_no(): ask the planner before a nav2 run; only a real "no
    route" answer refuses (a slow planner is not a no). Re-fit the goal after
    every failure on the map as now seen (the real robot's shelf-ledge goal,
    R10: 4 x "no path", 250 s).
    - dither watch in run_nav2: 20 s, no net 15 cm nearer the goal, inside
    50 cm, the heading reversing >= 2 times and >= 85 deg of turning ->
    cancel, "narrow: dithering" (nav2's progress checker counts a 29 deg turn
    as progress,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
2026-10-19 reach: a tight-route set-up drive runs with the move it sets up
    The tight route plans a sequence and drove only its first move before
    re-planning. A short first move only sets up the next one ("B5 L30 F85":
    back 5 cm so the turn fits), and the re-plan from 5 cm away undid it:
    B5, then "F5 L30 F85" -> F5, then B5 again -- three rounds, ~15 s, twin
    apt_s1 2026-10-19. A 5 cm shift is inside the planner's tie noise.
    Now a drive of <= TIGHT_SETUP_M (10 cm) that has a next move is driven
    together with it before re-planning; each move still goes through
    goal_exec on fresh points, and a refusal still ends the pair.
2026-10-19 LiDAR: see what is right beside the body (no 2 cm self-filter, 5 cm min range)
    gap_pass (reach's points), goal_exec_node and follow_node dropped every
    LiDAR point within 2 cm OUTSIDE the outline as "the rover itself", and both
    costmaps ignored returns closer than 20 cm to the LiDAR (~15 cm in front of
    the nose, where the camera is blind under ~40 cm too).
    That band hid real obstacles exactly where tight moves happen. Twin apt_s1
    2026-10-19: a coffee-table panel 0.4 cm off the side read as a 5.7 cm gap,
    the escape turned into it (-3.3 cm) and stayed against it.
    Nothing of the rover is in the scan plane (25 cm, above the frame): in 21299
    REAL scans (survey 2026-10-18) no return came within 6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
2026-10-19 Obstacle height band to 31 cm: the rover keeps out from under low furniture
    nvblox's map slice and reach's depth obstacles stopped at 27 cm; the rover
    is 26.3 cm tall (LiDAR top), 0.7 cm of margin. A 28 cm coffee-table top read
    as free floor: twin apt_s1 2026-10-19, the rover drove UNDER its overhang
    (1.7 cm over the LiDAR) until its wheels jammed on the table's base (mesh
    check: nothing of the table at 6-26.3 cm inside the outline, ~8000 points
    below 6 cm and above 26.3 cm).
    esdf_slice_max_height and depth_obstacles Z_MAX 0.27 -> 0.31 (~5 cm over the
    rover): what hangs lower is an obstacle. After: the rover got itself out
    from under the table and no longer went under it.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
2026-10-19 reach: steering-slide escape and a pinned watch; MPPI hard margin stays 2 cm
    Parked 1-2 cm along something the whole length of a side (the coffee table,
    twin apt_s1 2026-10-19): every turn swings a corner in, short straight moves
    only slide along it, even a gentle arc swings the rear corner in first
    (~REAR^2 / 2R), and MPPI refuses every motion inside its 2 cm padding -- 3
    goals in a row failed from the spot with 0.0 m driven.
    MPPI padding 0.01 was tried and REVERTED: on 2.5 cm cells MPPI then drove
    the front-left corner 1.4 cm into the sofa and pushed there 190 s. A
    refusal is fair, a touch never is; nav2.yaml says so at footprint_padding.
    - escape_moves.slide_clear / slide_steer + reach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
2026-10-19 Docs: the 2026-10-19 twin nav session -- what was wrong, why, the fixes, the numbers
    - NAV_PLAN.md: "Session 2026-10-19": the seven problems with their evidence
    and commits, the fixed 5-leg loop before / after (from "bedroom -> living
    room fails, 4 of 5 legs touch" to all 5 reached, nothing touched), pose
    drift measured per source, what is open.
    - NAV_GUIDE.md: brought up to date -- BT keeps its path (no 1 Hz replan),
    LiDAR from 5 cm, obstacle band 3-31 cm, MPPI's 2 cm hard margin and why
    it stays, reach's pinned watch / steering slide / crash guard, legs along
    the house route (REACH_HOUSE_ROUTE, still off on the real robot).
    - OPEN_ISSUES.md: 2026-10-19 entry, real-robot test ne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
2026-10-19 reach: tight-route search gets 8 s, sized for the Orin (was 3 s)
    Real robot 2026-10-19, house route on: a goal into the bedroom through a
    49-60 cm door past the foot of the bed (38 cm rover). nav2: "no path" -- its
    lattice plans 16 headings with a 46 cm padded body, which sweeps ~52 cm at
    that door's angle. The tight route is for exactly this, and replayed offline
    on the recorded LiDAR points of that moment it found the way every time:
    F65 R45 F40 R15 F135, 1238 poses. On the Orin under nav's load the same
    search took 2.9-5.6 s; at a 3 s budget it gave up a fraction short and the
    goal failed "no path ... 3 times from the same spot".
    TIGHT_BUDGET_S = 8.0. After: through the door on the first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
2026-10-19 reach: when no leg point is reachable, the tight route takes the gap (aimed along the house route)
    Real robot 2026-10-19: back out of the bedroom through the same 49 cm door,
    goal > 3.2 m. Legs need a point nav2 can plan to; the route goes through a
    door nav2 cannot plan and the door was nearer than LEG_MIN, so legs_toward
    said "no reachable point toward the goal (legs)" -- and that only made reach
    wait and ask nav2 again: 3 x, 41 s, not one move.
    - A legs failure "no reachable point ..." is now "no path: ..." for the
    recoveries, so the tight route (turns and straight drives on the raw
    points) runs.
    - tight_target() takes its point ALONG THE HOUSE ROUTE (through the door),
    not on the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
2026-10-19 reach: the house route is ON by default (REACH_HOUSE_ROUTE=0 turns it off)
    Twin (2026-10-19): the 5-leg cross-room loop on apt_s1 went from "bedroom ->
    living room fails, 4 of 5 legs touch furniture" to all 5 reached, nothing
    touched (house route + nav2's obstacles and costs, commits 87d7533 ff.).
    Real robot, the same evening, after checking the SLAM lock (78% of live
    LiDAR points within 10 cm of the saved map's walls): far goals that failed
    "no path ... 3 times" with straight-line legs (4.3 m, 343 s) went through a
    49 cm bedroom door and back out.
2026-10-19 Docs: the 2026-10-19 evening on the real robot -- the door, the fixes, the overloaded Orin
    - NAV_PLAN.md: goals before / after, how the 49 cm door was diagnosed from
    the recording (single scans vs smearing, costmap right, the tight route's
    time), the overloaded Orin (detections_3d 58% CPU + 1.1 GB, publishing
    nothing), what is open.
    - OPEN_ISSUES.md: real run done; house route on by default; detections_3d,
    the doorway camera point and the 10 cm turn-only finish as open items.
    - NAV_GUIDE.md: legs along the house route by default; the tight route takes
    gaps nav2 cannot plan, aimed along the route, 8 s.
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2026-10-19 HARDWARE.md: the ultrasonic sensors are on their own new ESP32 (owner's pins stand)
    Correction to a2ea4d4: the owner bought a second ESP32 for the two HC-SR04s,
    so TRIG/ECHO on GPIO 5/19 and 18/21 are fine there (still: 1 k / 2 k divider
    on each echo). New notes: two ESP32s on the Pi 5's USB -> address them by
    /dev/serial/by-id, never ttyUSB0/1; the sonar board talks plain serial to a
    small Pi 5 node (/sonar/left, /sonar/right), apart from the wheels' micro-ROS.
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2026-10-19 Sonar board firmware: MicroPython main.py (+ the uploader) for the two front sensors
    The front sonars' own ESP32 (HARDWARE.md 2b) runs MicroPython 1.24 with this
    main.py: S1 (TRIG 5 / ECHO 19) and S2 (TRIG 18 / ECHO 21) pinged in turn,
    never together, a line per reading over USB ("S1 1234" mm, "S2 -1" = no
    echo). Runs at power-up. upload_main.py replaces it over the same USB link
    (stops the old one, writes, checks, resets) -- no compiler, no flashing tool.
    On the robot 2026-10-19: streaming S1 144 / S2 149 mm after a reset; the
    Pi 5's sonar node publishes them as /sonar/left, /sonar/right.
2026-10-19 description: sonar field of view 0.52 rad -- the full cone, not its half
    sensor_msgs/Range field_of_view is the FULL angle of the cone. An HC-SR04
    hears ~15 deg either side, so 0.52 rad; 0.26 (4708314) was the half by
    mistake, and the twin's sensor model was half as wide as the real one.
2026-10-19 The front sonars as a witness: close echoes the map cannot explain become obstacle points
    A sonar cone says how far, not where: painted into the map as an arc, a
    doorframe heard beside the rover would read as a wall across its path and
    every tight gap would close. So (sonar_witness.py): an echo within 60 cm is
    used only when no known obstacle point (LiDAR or camera map) lies inside
    that sensor's cone up to 5 cm beyond it -- then it is something real the map
    lacks (a slipper, a chair's foot: under the LiDAR's plane, inside the
    camera's blind 40 cm) and becomes one obstacle point straight ahead of that
    sensor. Explained echoes add nothing, so the rover is not more timid.
    - sonar_feed.py: /son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
2026-10-19 nav2 collision monitor: the front sonars as range sources (never a stop for silence)
    /sonar/left and /sonar/right as `range` sources: each echo an arc of points
    across its cone. With the `approach` polygon (body + 1 cm, 1.0 s) that caps
    the speed so contact stays >= 1 s away and stops only for points already in
    the body + 1 cm -- graceful slowing for something low and close in front,
    never a block for a doorframe heard beside the path. source_timeout 0.0: nav2
    stops on ANY stale source otherwise, and a sonar USB hiccup must not freeze
    the wheels; the Pi 5 node publishes +inf (no echo) while its board is
    missing, so a last close reading never lingers.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
2026-10-19 Sonars vouch a lone camera speck away: the rover goes where only a reflection stood
    Real robot 2026-10-19 (bag ..._rviz_real3, recorded): leaving the bedroom
    door, goal_exec refused a 90 cm drive twice -- "obstacle 0.32 m into the
    leg" -- for ONE 2.5 cm cell of the fused camera map, 52 cm ahead, 17 cm from
    any LiDAR point, on bare polished marble in the image: a reflection. ~45 s.
    The camera map is flat, so silence alone cannot tell a floor reflection from
    a tabletop edge above the cone (the rover drove under one that morning). A
    furniture edge is a line of cells, a slipper a patch, a reflection a lone
    speck. sonar_witness.vouched_specks overrules a camera point only when ALL
    hold: no LiDAR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
2026-10-19 reach: the tight route follows its plan between moves (re-plans on a refusal or a miss)
    Real robot 2026-10-19, chairs: the tight route re-planned after EVERY move --
    1.5 s settle, a camera-point plan failing its whole budget, the house route
    again -- for moves that had gone exactly as planned (F30: 0.7 cm off): ~10 s
    per move, ~30 cm of progress per 13 s.
    Now the rest of the plan is kept with the pose poses_of() expects after each
    move (the learned pivot slide included); while the rover is within
    TIGHT_FOLLOW_M (4 cm) / TIGHT_FOLLOW_DEG (4 deg) of it, the next move is driven
    after TIGHT_FOLLOW_SETTLE_S (0.3 s). A refusal, a miss or a LiDAR plan's
    drive cut short re-plans from where the rove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
2026-10-19 Docs: the front sonars, the chairs, tight-route speed -- design, evidence, what is open
    - NAV_PLAN.md: the chairs measured (52 vs 42 cm), the tight route following
    its plan, the sonars' three uses (collision monitor, witness, vouch) with
    their rules and commits, why the flat camera map limits the vouch to lone
    specks, what is not yet done, the Pi 5 dropping off.
    - NAV_GUIDE.md: the sonars beside the costmaps (not in them), in "who
    decides what to try next".
    - OPEN_ISSUES.md: sonars built and live (drive test next), the boot service
    (owner, sudo), the assumed mounting, the plan-following change, the Pi 5.
2026-10-19 KINO_SYSTEM.md: one copy again in all three repos; the 2026-10-19 findings
    - the sonar row (was only in the Pi 5's copy), the laptop's current docs
    (was only in the laptop's), the wheels' ESP32 by its USB socket;
    - known problems: the Jetson stopped dead at 12:07, 16:30 and 21:46 on
    2026-10-19 with nothing wrong the second before (netwatch: 5.09 V in at
    ~1.2 A, 53 C, load ~2, WiFi -38 dBm; the journal just ends) -- a power cut
    or a hard hang, not heat or load; the Pi 5's undervoltage; the twin's VO.
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2026-10-20 tight_route: a fixed search size (6000 poses), the same on every computer
    The time budget decided before (MAX_EXPAND 40000): the laptop, ~8x the Orin,
    found a 13-move detour round a 7 cm floor speck that the robot never finds, so
    test_reach_tight failed on the laptop and the twin tests did not show the
    robot's behaviour. Real robot 2026-10-20: the largest plan found was 3523 poses.
    Tests: test_tight_route all pass (a wall: 'none' in 965 ms), test_reach_tight
    5/5 (was 4/5 on the laptop).
2026-10-20 Tight route: a camera point in a LiDAR plan's way is checked, not driven into (T1, T2)
    Real robot 2026-10-20 (reach log 14:53-16:11): when no plan fitted ALL points
    the LiDAR's plan was driven, and goal_exec refused its first move 7 of 15 times
    on a camera point (a chair's splayed foot, a stool seat); twice the very same
    plan was made again from the same spot and refused again ("F40 L30 F135 L30
    F20", 16:06:48/:57), and the goal went on to wander (way_back 24-32 hops).
    Now (tight_route.Evidence, per goal): the LiDAR plan is checked against the
    camera's points with goal_exec's own tests before a move. The part before the
    first blocked move is driven (a new viewpoint); if the first move is bl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
2026-10-20 way_back: the shortest way along the trail, and none that wanders (T3)
    Real robot 2026-10-20: way_back of 24 hops for 2.36 m nearer, and 32 hops for
    1.96 m (goal 763 ran 239 s, cancelled): it replayed the trail in time order,
    every loop the rover had driven -- "random points" to the owner.
    Now trail points closer than LINK_M (0.30 m; the rover is 38 cm wide, so
    nothing can stand between two places its centre has been that close) are
    joined, and the way back is the shortest path over the trail (Dijkstra). A way
    back that drives more than 2.5 x its gain + 1.5 m is not taken; reach logs why
    ("the way back drives 10.2 m to get 1.3 m nearer") and goes on to its other
    recoveries. Each hop is stil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
2026-10-20 reach: an honest "too tight" with a number -- the widest way on the LiDAR (scenario 7)
    Twin 2026-10-20, world gap36 (the only way on is a 36 cm gap; the rover is 38),
    old code: 269 s and 3.8 m driven -- tight search 19 s, pass_far x4, an "approach"
    through nav2 for 125 s, waits -- then "no way from here ... 3 times from the same
    spot". The real robot did the same in its tight places (T3).
    widest.py: the max-min (bottleneck) path from the rover to the goal over a 2.5 cm
    grid of the LiDAR's points. On the first "no path" of a goal, once stopped and
    settled (no smear), reach asks it; narrower than 2 x SIDE + 2 x PASS_MARGIN (42 cm)
    -> the goal ends at once: "too tight: the widest way to the go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
2026-10-20 Tight route: a refused move makes its camera points SUSPECTS, not believed (chairs44)
    Twin chairs44 2026-10-20, fixes 2-4: goal 1 failed at 99 s (old code: reached
    in 30 s). Same start in both: F100, then the F150 refused on a camera point
    0.31 m ahead that was gone a moment later. The old code re-planned F135 and went
    through; the first version of the evidence rule believed the refused-on points
    at once, so the passing glitch walled off the only way for the whole goal ("no
    fit found in the time" x2, 8 s each).
    Now a refused move feeds its camera points to Evidence.check like any other
    camera point: believed only when seen again from another pose; from the same
    spot a LiDAR plan through the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
2026-10-20 Tight route: what the camera cannot see now blocks only until the next move, never for the goal
    Twin chairs44 2026-10-20, two runs on 47a44dd: goal 1 took 144 and 182 s (old
    code: 30 s). After the first refused drive the re-plan on all points failed
    ("no fit found in the time", 8 s) where the old code re-planned F135 in 23 ms:
    Evidence.check believed at once, for the whole goal, any blocker the camera
    could not see from there -- and points just off the bumper (< CAM_NEAR) count as
    unseen, so a passing glitch there became a wall.
    Now: confirmed = seen from two poses only. A blocker the camera cannot see is
    avoided until the rover next moves (Evidence.unseen; cleared on every reached
    move and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
2026-10-20 reach: the tight route leads where the widest way is under what nav2 plans through (T5)
    nav2's planner keeps 4 cm a side on 2.5 cm cells: it plans a gap only from ~51 cm,
    and under that it tries, swerves and fails. Twin door49 2026-10-20 (a 49 cm way,
    old code): nav2 drove ~5.5 m in 67 s, then "no path"; the tight route then went
    through in 30 s. Real robot 2026-10-20: "no path" on almost every tight goal (T5).
    Now, before nav2 on a goal within 4 m: the widest way on the LiDAR (widest.py,
    read 5 cm generous). Fits the rover (>= 42) but under NAV2_W (56 read, ~51 real)
    -> the tight route leads, once per goal. Thresholds on synthetic walls: real
    42-52 cm -> tight route, 55+ -> nav2, open -> n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
2026-10-20 docs: the 2026-10-20 tight-place session (NAV_PLAN, NAV_GUIDE, OPEN_ISSUES)
    NAV_PLAN "Session 2026-10-20": T1/T2 camera evidence, T3 shortest way back,
    the honest "too tight" (widest way), fix 5 on its own branch, the reverted
    search cap -- with the twin's before/after numbers and what is still open.
    NAV_GUIDE §5: how the tight route, widest way and way back decide now.
    OPEN_ISSUES: status, newest first. Branch work; merge is the owner's call.
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2026-10-21 track: closed-loop approach on the twin (stage 4) + three fixes it found
    closed_loop_approach.py plays the brain's part on the twin: find (YOLO or a
    VLM stand-in pointing at the truth, with optional error), ground through
    pixel_to_goal, lock, drive /reach and re-send the goal on the refined point;
    judged on /sim/truth/pose. --mode oneshot is today's behaviour.
    clutter world, bottle 0.9 m, the first guess deliberately 25 cm wrong (2 runs each):
    sideways: one-shot misses by 24 cm (facing 29 deg off); closed 1.3-1.4 cm, 1.5-1.7 deg
    too far: one-shot stops 21 cm short; closed 1.1-1.2 cm short
    With a good first guess (VLM box +-40 px) both are ~1 cm: pixel_to_goal's box
    groun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
2026-10-21 approach: ./rover approach <label> -- closed-loop "go near" on the real robot (no truth)
    closed_loop_approach.py runs without --truth: YOLO finds the thing, and the
    result is what the robot measured (tracker point vs its own pose). ./rover
    approach LABEL [--mode oneshot] runs it in the container with the host
    TensorRT; it DRIVES, refuses in MANUAL and needs ./rover track. Tested on the
    twin: wiring, and a clean "YOLO sees no vase" (an empty-argument bug found and
    fixed: printf of no options passed an empty string).
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2026-10-21 track: gate asks 3 times (a running node read FAIL 3 s after start on the real robot)
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2026-10-24 2.0: realsense-ros 4.58.2 Lyrical patch (NVIDIA's 4.56.3 one doesn't apply)
    4.58.2 already has the link/tf2 fixes; it only lacks lyrical in its ROS_DISTRO switch.
2026-10-24 2.0: nav2 1.5, costmap plugin, lidar, YOLO TensorRT and image checks pass
    - check.sh: 0 FAILs on orin-nav:2.0 (packages, plugins, ldd, sm_87, DDS librealsense,
    TensorRT 10.16 in-image, python deps); nav2_bringup was never used, list fixed
    - vo_check: 2.0 = 30.0 Hz, +2.4 % vs truth, 21 % core, 580 MB, 479 landmarks (1.2: 30.0, -2.4 %)
    - nav2_check.sh (new): our nav2.launch.py + nav2.yaml + BT + plugin, offline -> PASS on 2.0 and 1.2
    * nav2.yaml: MPPI motion model is a plugin in nav2 1.5 (DiffDrive.plugin)
    * nav2.launch.py: Lyrical copy of the BTs with IsPathValid -> ValidatePath (retire with 1.2)
    - footprint_clear_layer.cpp: declare_or_get_parameter on nav2 1.5, declareParameter on 1.3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
2026-10-24 2.0 on the real robot (standing still): all layers green; Lyrical logger fix; vo_replay A/B
    - every layer up on orin-nav:2.0 (camera, lidar, pose, fused, slam, map, nav, detect)
    - get_logger().warn() -> .warning() (removed in Lyrical rclpy; vo_isaac.py crashed on it)
    - vo_replay.sh: replay a recorded IR bag into any image; dark-room VO failure reproduced
    identically on 4.6 and 5.0 -> scene (4 AM, emitter off), not the upgrade
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2026-10-24 B2: b2_gridloc.sh -- NVIDIA occupancy-grid localizer vs relocalize.py on the live scan
    First live result (maps/last, 3.5 m room, robot in a corner, standing still): ours locked
    (-0.07, 0.08, -71.5 deg) 99.4 % of beams on walls, 1.6-9 s; NVIDIA 0.3-0.5 s but wrong and
    unstable: 10-27 % of beams on walls under either frame reading, also with
    invalid_range_threshold 0.25. Keep relocalize.py; re-test on the twin with truth.
    relocalize.py docstring: no --json flag (it always prints JSON).
2026-10-25 nav2 1.5: restore three behaviours the upgrade silently changed (twin home_real)
    Twin home_real on 2.0, first run: 2/4 reached (1.2 baseline: 4/4). Root causes, from the logs
    and a live parameter audit:
    - costmap_update_timeout (new, default 0.3 s): controller now waits for a fresh local costmap
    and aborted 9x with error 107 when the loaded Jetson's update stalled -> 1.0 s
    - MPPI prune_distance / enforce_path_inversion / inversion_* moved to the new PathHandler
    plugin and were IGNORED; enforce_path_inversion fell back to false (cusp stalls, 'Failed to
    make progress') -> same values under controller_server.PathHandler
    - wait_for_service_timeout (bt_navigator builds the tree at activatio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
2026-10-25 nav2 1.5: plain Twist on every nav2 velocity publisher -- nav2 never drove on 2.0
    nav2 1.5 defaults enable_stamped_cmd_vel to true. The velocity smoother published
    TwistStamped on /cmd_vel_smoothed; collision_monitor (enable_stamped_cmd_vel: false, ours)
    subscribed Twist: different types never connect, nothing errors. Every nav2 command was dropped;
    reach's own fallback moves reached the goals (twin home_real: nav2 legs 'stuck: the controller
    made no progress' for 120 s each, goal 4 timed out). controller_server, behavior_server and
    velocity_smoother now set enable_stamped_cmd_vel: false explicitly.
    topic_audit.sh (new): lists every topic whose publishers and subscribers disagree on the type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
2026-10-25 B2 on the twin: NVIDIA's grid localizer as accurate as ours (4.0-4.5 cm) and 10x faster
    3 spots on the twin's SLAM map, measured standing still (truth read before and after):
    ours 4.0-4.7 cm in 5.5-7.2 s, NVIDIA 4.0-4.5 cm in 0.6 s. Plan: NVIDIA first, verified by our
    scan agreement, our search as the fallback (it was wrong on the cramped real 3.5 m room).
    b2_gridloc.sh: waits for 3 s standing still and re-reads the truth after both answers.
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2026-10-25 rover lidar: check the per-distro build (build_*/), missed in the step-9 cleanup
    Real-robot bring-up on 2.0 refused the lidar ('driver not built') although lidar/ws/build_lyrical
    has it; the twin uses its own driver and never reached this check.
2026-10-25 rover slam: pass the relocalize hint as --hint=x,y,th
    A saved pose with a negative x ('-0.095,0.148,-1.257') was parsed by argparse as a new option:
    relocalize.py exited with a usage error, printed no JSON, and ./rover slam reported
    'lost: no answer' and archived the room without having looked. Found on the real robot.
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2026-10-25 map_autosave: sleep between saves, listen 3 s before each (15 % -> ~3 % of a core)
    It spun the whole 120 s period, decoding every /tf, /scan and /map message, and used only
    the last ones at save time. Measured on the real Orin, full stack: 15 % of a core continuously
    before, 2.8 % over 30 s after (incl. start); a 15 s test period still saved (last.posegraph).
    tf_lag.sh (new): scans newer than the newest odom TF, TF stamp age, TF arrival gaps. Real robot
    standing still: TF age ~0-5 ms, worst gap 90 ms (light) / 122 ms (YOLO+follow+track), none
    > 200 ms -- the collision monitor's 'invalid source' stops need driving load to reproduce.
2026-10-25 explore: ./rover explore -- frontier exploration of the LiDAR map, every goal through reach
    phase3/nodes/explore_node.py: frontier cells of slam_toolbox's /map (free next to unknown),
    clusters >= 30 cm, goal = safe free cell (no wall/unknown within 30 cm) >= 25 cm back from the
    frontier, facing it; nearest first; reach drives (nav2 + goal_exec + 'too tight' refusals);
    failed/visited spots blacklisted (50 cm); stops when no frontier is left, at the time limit, or
    after 4 failures in a row. Never commands the wheels itself. /explore/status JSON.
    Twin home_real, fresh SLAM map: done in 8.9 min, 10 goals (8 reached, 1 timeout, 1 refused
    '30 cm way, needs 42'), 'no frontier left'; map 26.9 m2 fre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
2026-10-25 open issues: brain blind after bring-up -- image_bridge frames not reaching the Pi 5, fixed by restart, gate gap
2026-10-25 teleop: run on the Pi 5 distro switch (Lyrical since 2026-10-25)
    run_teleop.sh read /opt/ros/jazzy; it now reads ~/.langrobo/ros_distro (the
    same switch as the Pi's ~/ros2_ws/scripts/ros_env.sh, default lyrical).
    Deployed to the Pi's ~/langrobo_teleop/ together with teleop_web.py (the live
    copy had drifted: an older comment only, same behaviour).
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2026-10-25 docs: the robot is on ROS 2 Lyrical end to end; the 1.x/4.6 record goes to git history
    - OPEN_ISSUES: the blind-brain entry gets its measured cause (Jazzy Pi 5 vs Lyrical
    Jetson, image_bridge never matched Pi readers in the live graph) and the fix
    (Pi 5 on Lyrical, 42 frames/10 s at agent_node) + the closed gate gap.
    - ISAAC_ROS_5_UPGRADE: log entry, step 5 answered.
    - ARCHITECTURE: middleware row = Lyrical on both machines; VO row = isaac_ros_cuvslam
    (the pyCuVSLAM/Thor text described the deleted 1.1 image).
    - KINO_SYSTEM (the copy shared by all three repos): versions 2026-10-25, the Pi's
    distro switch, why the ESP32 firmware needs no reflash; pointers to 5.0 docs.
    - README, FLASHIN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
